808017/ATmega4809-CNANO-Documents/ATmega4809-Curiosity-Nano-Altium-Project/BOM_Template.xlsx

 | Component list |  | Field=ProjectTitle
 | PCBA Number: |  | Field=ProjectPCBAssyNumber
 | PCBA Revision: |  | Field=ProjectPCBAssyRevision
 | Variant: |  | Field=VariantName
 | Print Date: | Field=CurrentDate | Field=CurrentTime
Column=Fitted | Column=Designator | Column=Quantity | Column=Value | Column=Manufacturer | Column=MPN | Column=Description
 |  | Field=TotalQuantity
Approved |  |  | Notes
