808017/ATmega4809-CNANO-Documents/CNANO-Explorer-UserGuide-DS50003716.pdf

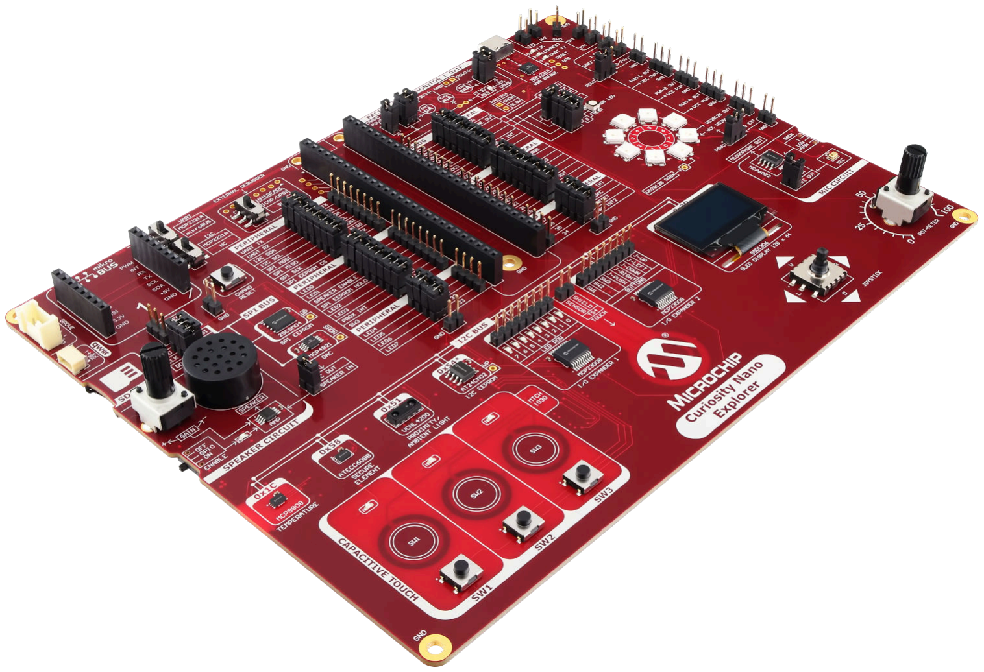
[picture p1: figure]

User Guide
© 2025 Microchip Technology Inc. and its subsidiaries

DS50003716B - 1

## Preface

- Website (https://www.microchip.com/en-us/development-tool/EV58G97A) - Purchase this product, kit information, latest user guide, and design documentation
- Explorer Pinouts for all Curiosity Nanos (https://ww1.microchip.com/downloads/aemDocuments/documents/MCU08/ProductDocuments/BoardDesignFiles/Curiosity-Nano-Explorer-Pinouts.pdf) - Explorer Pinouts for all Curiosity Nano boards
- Schematics (https://ww1.microchip.com/downloads/aemDocuments/documents/MCU08/ProductDocuments/BoardDesignFiles/Curiosity-Nano-Explorer-Schematics.pdf) - Board schematics
- Altium Project (https://ww1.microchip.com/downloads/aemDocuments/documents/MCU08/ProductDocuments/BoardDesignFiles/Curiosity-Nano-Explorer-Altium-Project.zip) - Altium design files for the latest board revision
- Design Documentation (https://ww1.microchip.com/downloads/aemDocuments/documents/MCU08/ProductDocuments/BoardDesignFiles/Curiosity-Nano-Explorer-Design-Documentation.zip) - Production files for all board revisions
- MPLAB® Discover (https://mplab-discover.microchip.com/v2?dsl=%22Curiosity+Nano+Explorer%22) - Code examples for Curiosity Nano Explorer

Important:
This version of the user guide documents Curiosity Nano Explorer Revision 4.
- Identify your product revision
- Curiosity Nano Explorer Online Errata (https://onlinedocs.microchip.com/g/GUID-2B07EF5D-DD0E-43DF-9A21-7FCEBF41749E) - Latest revision history and known issues for all board revisions

Product Page Links

## Curiosity Nano Explorer User Guide

## Curiosity Nano Explorer User Guide [EV58G97A]

Curiosity Nano Explorer User Guide [EV58G97A]

- Curiosity Nano Explorer Online User Guide (https://onlinedocs.microchip.com/g/GUID-4910ECB5-7AD0-4572-B070-CCA2E253F3CB) - Access the latest user guide online
- Curiosity Nano Explorer PDF User Guide (http://www.microchip.com/DS50003716) - Download the latest PDF version of the user guide

## Table of Contents

6.3. I

Introduction

## 1. Introduction

Kit Introduction, Kit Contents, Terminology, Image Legend.

## 1.1. Curiosity Nano Explorer

The Curiosity Nano Explorer lives up to its name by providing extensive on-board features that allow users to explore and experiment with the microcontroller peripherals of their Curiosity Nano development board. It also serves as a great platform to become familiar with Microchip's software offerings.
A wide selection of input and output options:
- INPUTS include Touch and mechanical buttons, a potentiometer, a joystick, a temperature sensor, a proximity sensor, an ambient light sensor, and a microphone
- OUTPUTS include LEDs (simple yellow, standard RGB, and WS2812B RGB), an OLED display, and a speaker
Solid support for serial communication:
- I²C Bus with eight clients
- SPI Bus with three clients
- UART connection
Microchip’s complementary technologies:
- Touch controller with three touch buttons and a separate touch button for use with microcontrollers featuring a touch peripheral
- ECC608 provides CryptoAuthentication™ features
- Power Monitoring by the PAC1944 enables the measurement of various power domains Finally, if anything is missing on the Explorer, its functionality can be expanded via the mikroBUS™, Grove or Qwiic® connector.

## 1.2. Kit Contents

The Curiosity Nano Explorer kit contains:
- One Curiosity Nano Explorer development board
- 20 separable 100-mil jumper wires for pin remapping
- Ten additional 100-mil pin jumpers
- One 1x8 (100-mil) right-angled pin header to connect external programmer/debuggers
- One joystick cap

## 1.3. Terminology

This user guide uses the following terminology:

Table 1-1. Terminology
Term | Explanation
Explorer | The Curiosity Nano Explorer development board
CNANO | The connected Curiosity Nano development board
CNANO Socket | A socket with two 1x28 100-mil pin header sockets to connect any Curiosity Nano development board to the Curiosity Nano Explorer

## 1.4. Image Legend

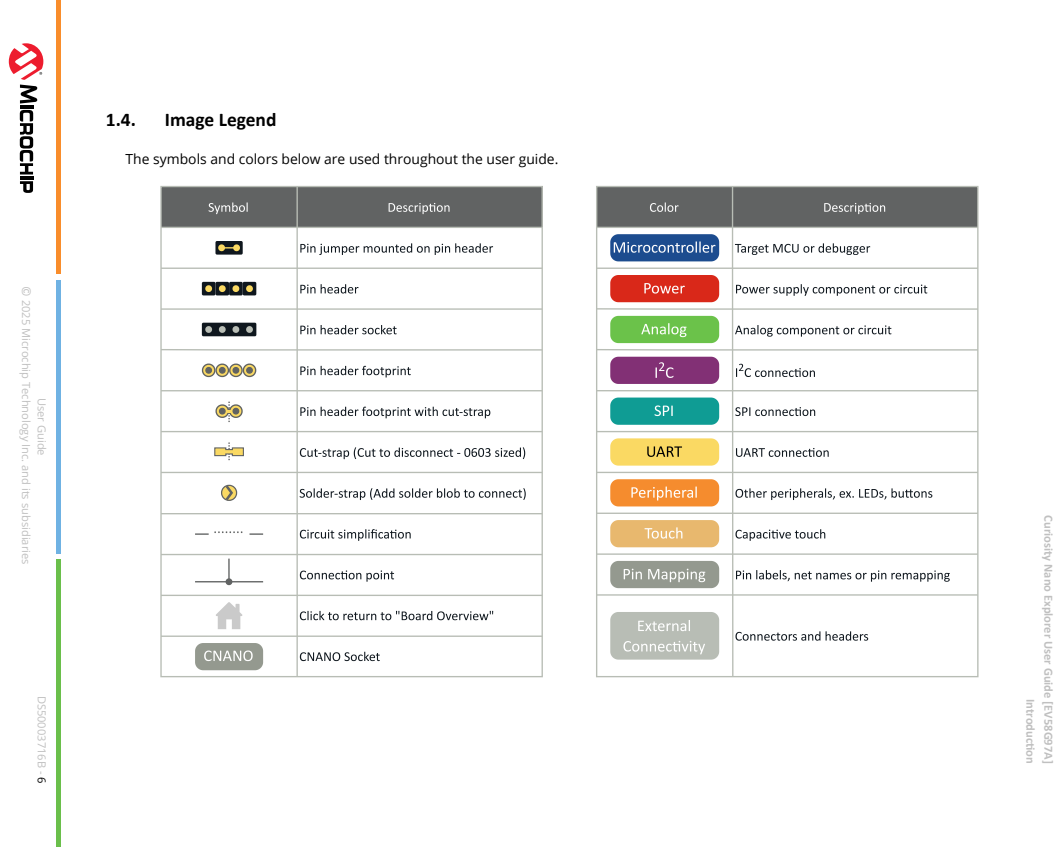
[picture p2: page 6]
Introduction; User Guide

rotatethispage90
The symbols and colors below are used throughout the user guide.

© 2025 Microchip Technology Inc. and its subsidiaries

Curiosity Nano Explorer User Guide [EV58G97A]

## 2. Board Overview

## 2.1. Block Diagram

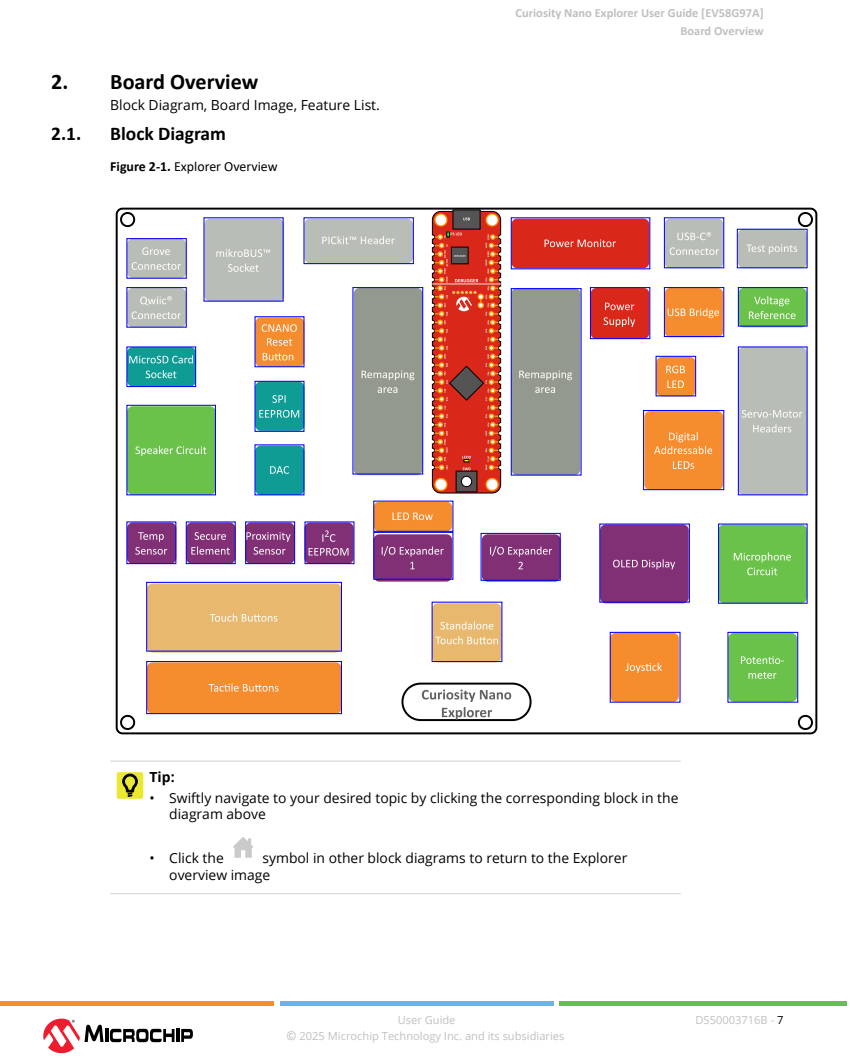
[picture p3: page 7]
Board Overview; • Click the; symbol in other block diagrams to return to the Explorer; overview image

Block Diagram, Board Image, Feature List.

Figure 2-1. Explorer Overview

Tip:
• Swiftly navigate to your desired topic by clicking the corresponding block in the
diagram above

## 2.2. Board Image

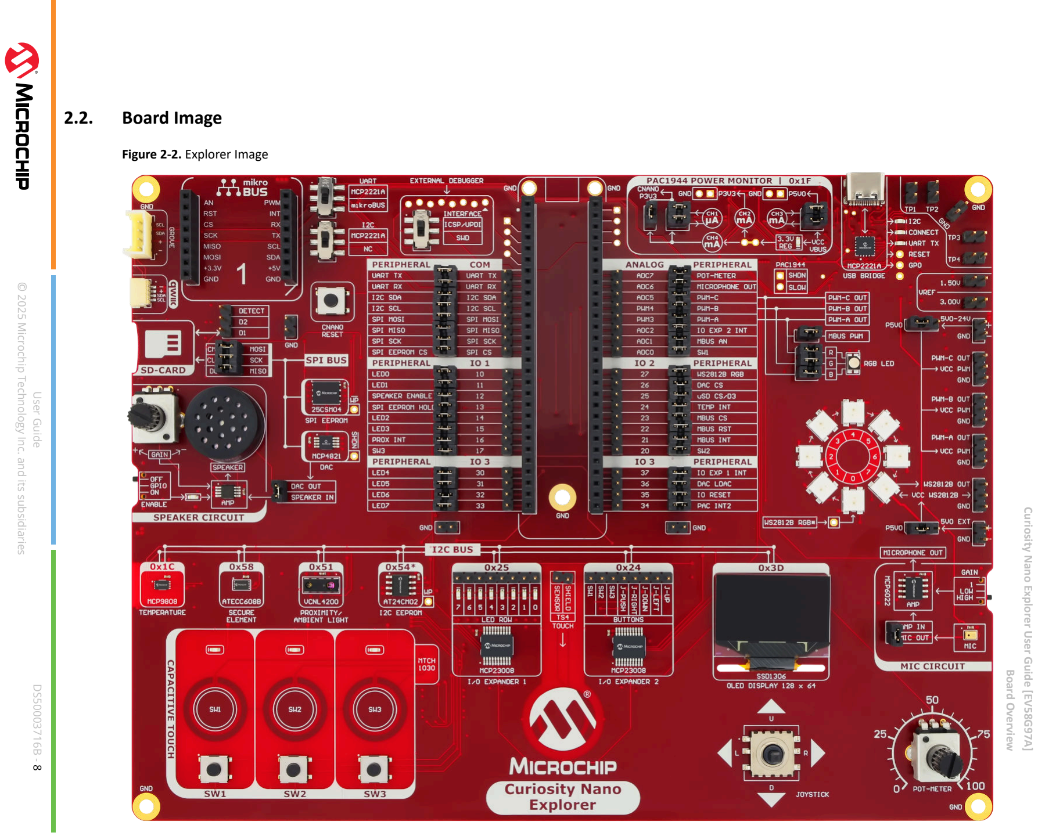
[picture p4: page 8]

Curiosity Nano Explorer User Guide [EV58G97A]

Board Overview

User Guide

© 2025 Microchip Technology Inc. and its subsidiaries

DS50003716B -

8

rotatethispage90
Figure 2-2. Explorer Imagerotatethispage90

Board Overview

## 2.3. Feature List

- Curiosity Nano socket
– Supports all Curiosity Nano development boards
– Fully remappable pinout
- On-board peripherals
– MCP2221A (https://www.microchip.com/en-us/product/MCP2221A) USB to UART/I²C-Bridge – PAC1944 (https://www.microchip.com/en-us/product/pac1944) power monitor
– ATECC608B (https://www.microchip.com/en-us/product/atecc608b) secure element
– MCP4821 (https://www.microchip.com/en-us/product/mcp4821) 12-bit digital-to-analog converter
– MTCH1030 (https://www.microchip.com/en-us/product/MTCH1030) touch controller
– Two serial EEPROMs (AT24CM02 (https://www.microchip.com/en-us/product/at24cm02) and 25CSM04) (https://www.microchip.com/en-us/product/25CSM04)
– Two MCP23008 (https://www.microchip.com/en-us/product/MCP23008) I²C I/O-expanders – MicroSD card socket
- Multiple input options
– MCP9808 (https://www.microchip.com/en-us/product/MCP9808) temperature sensor
– Microphone and amplifier (MCP6022) (https://www.microchip.com/en-us/product/mcp6022) with adjustable gain
– Joystick
– Potentiometer
– Push buttons
– Touch buttons
– Proximity/ambient light sensor
- Multiple output options
– LED row with eight yellow LEDs – OLED display
– One RGB LED
– Eight digital addressable LEDs
– Three external PWM outputs for servomotors
– Speaker and class-D amplifier with adjustable gain
- External connectivity options
– Grove I²C connector
– mikroBUS™ socket
– Qwiic® I²C connector
- Multiple power sources
– On-board USB Type-C® connector
– USB powered from connected CNANO – External power options for addressable LEDs and servomotors
- On-board Power Supplies
– MIC33153 (https://www.microchip.com/en-us/product/mic33153) 4 MHz PWM 1.2A internal inductor buck switcher power module to power 3.3V peripherals
– MCP1754 (https://www.microchip.com/en-us/product/MCP1754) 3.3V 150 mA LDO to power USB bridge and power monitor circuitry
– MIC2008 (https://www.microchip.com/en-us/product/MIC2008) high-side power switch for slew rate control and over-current protection
- MCP1501 (https://www.microchip.com/en-us/product/MCP1501) user-remappable voltage references, 1.5V and 3.0V
- Reset button for connected CNANO MCU

Pinout and Remapping

## 3. Pinout and Remapping

Pinout and Remapping Area, Different Types of Remapping.

Tip: The mapping between Explorer and any Curiosity Nano development board can be found in the Curiosity Nano Explorer Pinouts (https://ww1.microchip.com/downloads/aemDocuments/documents/MCU08/ProductDocuments/BoardDesignFiles/Curiosity-Nano-Explorer-Pinouts.pdf) document.

Figure 3-1. Pinout, Remapping Area and CNANO Socket

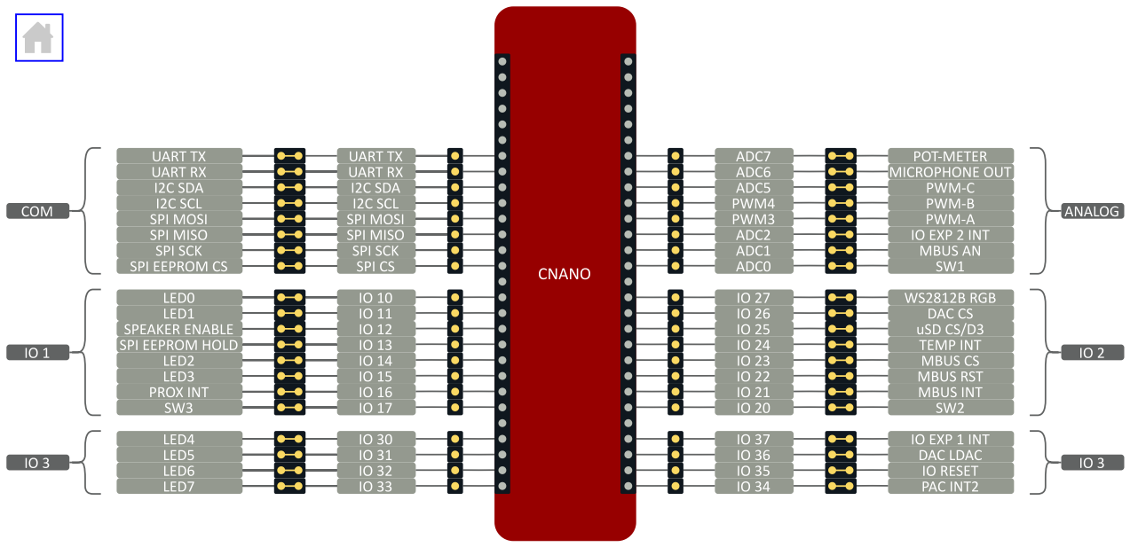
[picture p5: figure]

Connections to the CNANO socket are divided into five sections - COM, analog, IO1, IO2 and
IO3. Standard functionality is assigned to each pin in the COM and analog section Curiosity Nano development boards. Pins in the I/O sections are numbered with a <section><pin-number> format, ex: “IO 26” indicates section 2 pin 6.

Info: Curiosity Nano development boards with low pin count microcontrollers
may not implement the standard functionality in the COM and analog sections.

Pinout and Remapping
Figure 3-2. Explorer to CNANO Connections

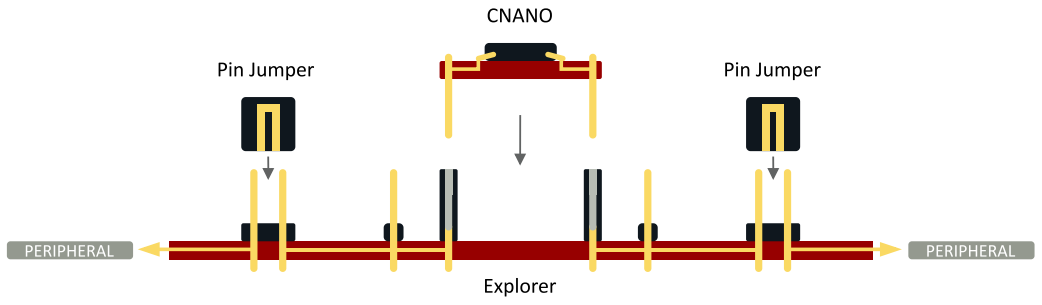
[picture p6: figure]

Tip: Connect your measuring tool to the innermost pin header for easy access to any signal on the Explorer. Use the custom test points for access with longer measurement probes.

## 3.1. CNANO Socket Remapping

The Explorer’s connections to the CNANO socket are fully remappable. Any peripheral can be connected to any pin on the socket.

Figure 3-3. Peripheral to CNANO Pin Remapping

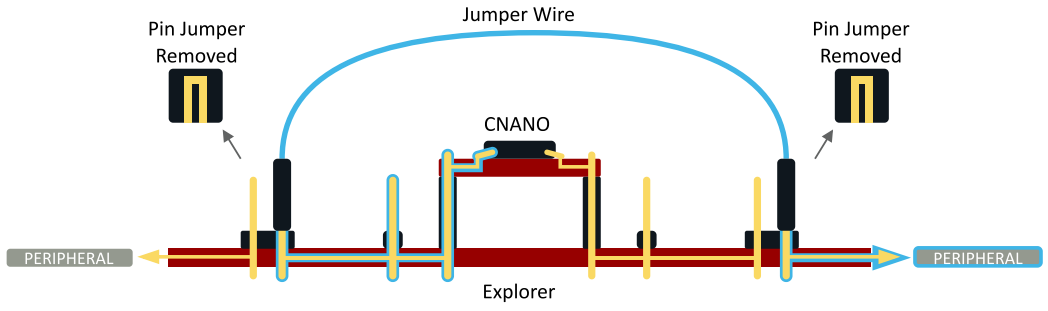
[picture p7: figure]

Tip: Peripheral connections are labeled on the silkscreen.

## 3.2. Direct Remapping

Many peripherals on the Explorer can be remapped by connecting a pin directly to the CNANO socket using a jumper wire. For example, if your CNANO's microcontroller has a DAC (Digital-to-Analog Converter) output, you can directly connect it to the speaker amplifier.

Pinout and Remapping
Figure 3-4. Direct peripheral remapping

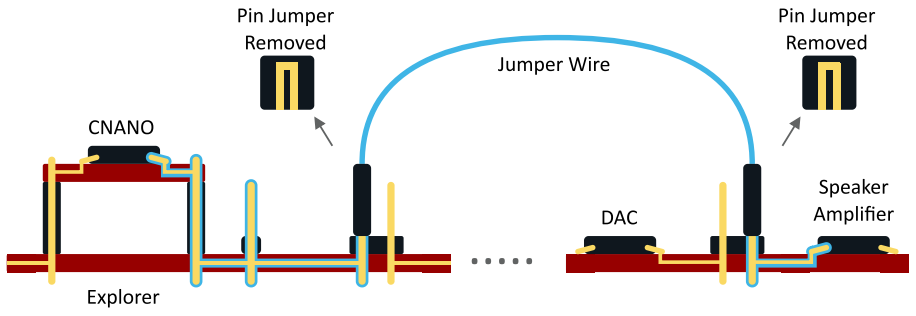
[picture p8: figure]

## 3.3. Custom Test Points

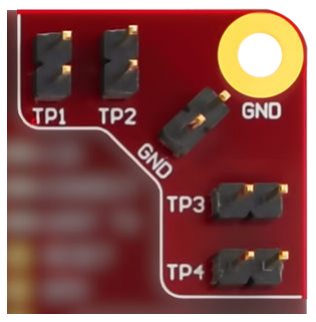
[picture p9: figure]

The Explorer features four customizable test points available on the board edge. The test points are labeled TP1, TP2, TP3 and TP4 on the silkscreen.
Easily measure any signal by connecting a jumper wire between the innermost pin header in the remapping area and a test point.

Figure 3-5. Connecting Net to Test Point

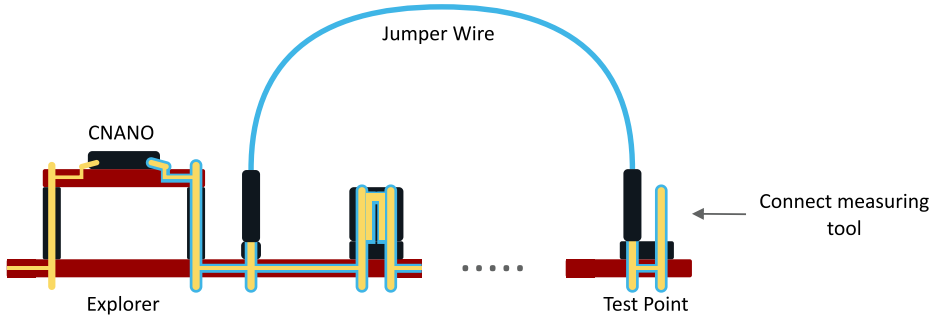
[picture p10: figure]

Tip: A pin header with ground connections is available next to the test points.

Power Supply and Monitor

## 4. Power Supply and Monitor

Power supply, Power Monitor.

## 4.1. Power Supply

Figure 4-1. Power Supply Overview

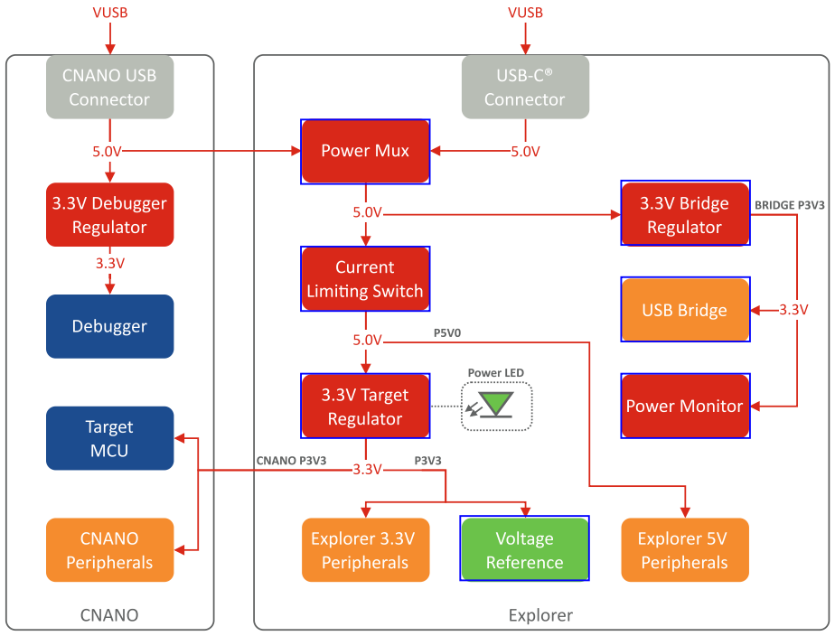
[picture p11: figure]

Important: The Explorer powers the CNANO at 3.3V, and all the pins connected to the CNANO socket are designed for use with 3.3V I/O pins.

The Explorer’s power supply features:
- Dedicated 3.3V regulator to power the CNANO and 3.3V peripherals
– The CNANO’s target regulator is disabled while connected to the Explorer
- 5V peripherals powered directly by USB voltage
- A power multiplexer allows power supplied from the on-board USB-C® connector or the CNANO
- A current limiting switch with a soft start to protect the board, the current limit set at 2A
- On-board power monitoring for voltage and current measurement with four channels

Power Supply and Monitor
Table 4-1. Power Domain Specifications
Power Domain | Vnom | Vmin - Vmax | Imax
P5V0 | 5.0V | 4.4–5.5V | 2.0A
P3V3 | 3.30V | 3.22–3.38V | 1.2A
CNANO P3V3 | 3.30V | 3.22–3.38V | 1.2A
BRIDGE P3V3 | 3.30V | 3.23–3.37V | 150 mA

### 4.1.1. Power Sources

The two main power sources are:
- The USB connector on the CNANO
- The USB-C® connector on the Explorer

Current limitations:
- The CNANO’s VBUS output has a current limitation of 500 mA
- The Explorer’s USB-C® connector can sink different amounts of current based on the USB source (up to 3.0A from a USB-C® source)
- Both USB inputs are fed into a power multiplexer, with output current limited to 2.0A

Info: If both USB connectors are powered, the current is sourced through the Explorer's USB-C® connector.

Figure 4-2. Power MUX Overview

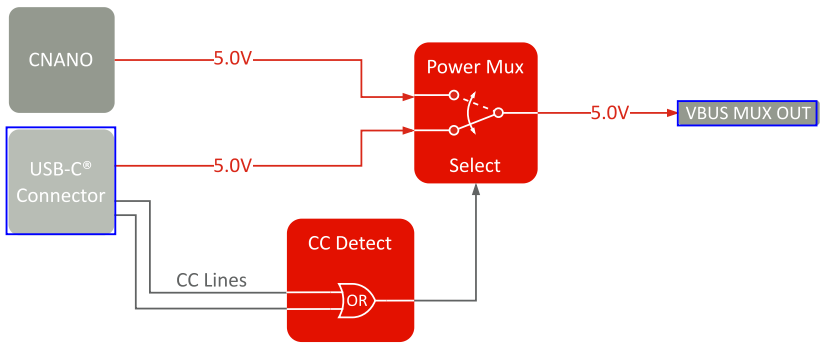
[picture p12: figure]

### 4.1.2. Power Domains

There are four main power domains on the Explorer:
- P5V0
- P3V3
- CNANO P3V3
- BRIDGE P3V3

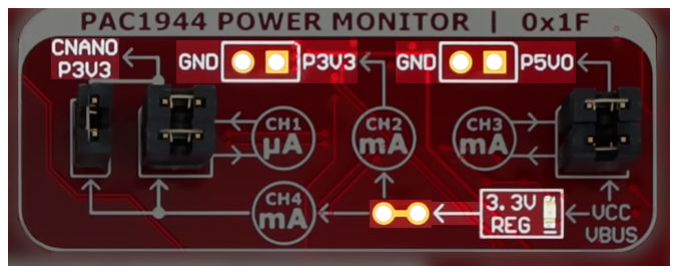
[picture p13: figure]

Power Supply and Monitor
CNANO P3V3 is powered by the same regulator as P3V3, separated for dedicated power measurement of the CNANO. It powers the CNANO’s external power input. Refer to CNANO Power Configuration for more information.

Table 4-2. Peripherals Connected to the Different Power Domains
Power Domain | Power Measurement Channel | Peripheral
CNANO P3V3 | CH1 (uA), CH4 (mA) | Connected CNANO
P3V3 | CH2 (mA) | Touch controller I/O expander 2 + button LEDs I/O expander 1 + LED row I 2C EEPROM Secure Element Proximity and ambient light sensor (digital circuitry) Temperature sensor OLED display SPI EEPROM DAC Voltage reference Microphone circuit Speaker circuit Potentiometer mikroBUS™ socket (3.3V pin)
| | MicroSD card socket Grove and Qwiic®connector
P5V0 | CH3 (mA) | RGB LED Digital addressable LEDs Servomotor circuit Proximity and ambient light sensor (internal LED) mikroBUS™ socket (5V pin)
BRIDGE P3V3 | - | Power monitor circuit USB bridge circuit

Figure 4-3. Power Domains Overview

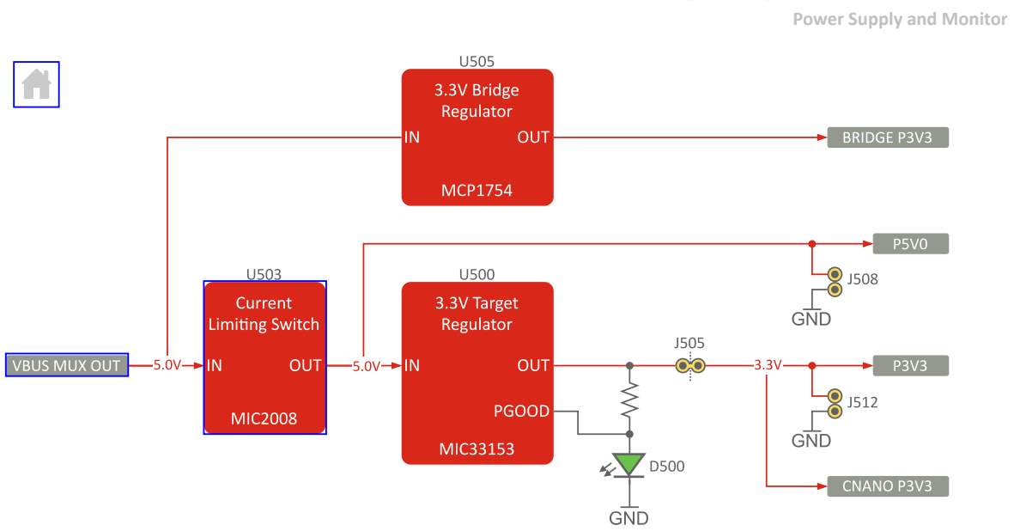
[picture p14: figure]
Power Supply and Monitor

### 4.1.3. Current Limiting Switch

A MIC2008 (https://www.microchip.com/en-us/product/MIC2008) current limiting switch with an adjustable slew rate is mounted on the board to prevent large inrush currents. The switch has been configured with a current limit of 2.0A by selecting resistor R500 to be 120Ω.

Info: MIC2008 current limit range: 0.2–2.0A. See the MIC2008 data sheet (https://www.microchip.com/en-us/product/MIC2008#document-table) for more information

Figure 4-4. Current Limiting Switch

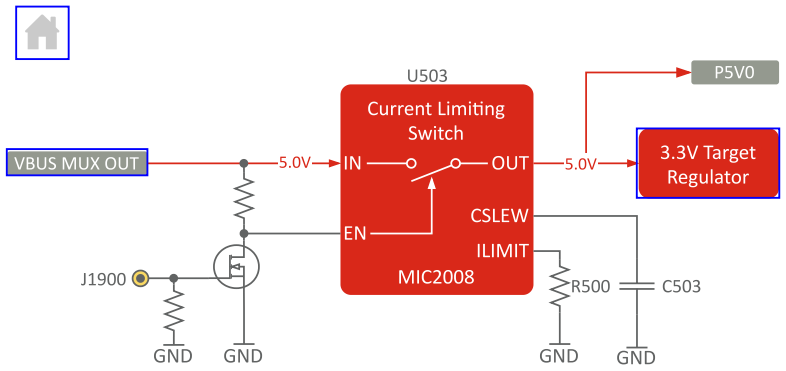
[picture p15: figure]

### 4.1.4. CNANO Power Configuration

The Explorer supplies the CNANO with a fixed 3.3V. When connected to the Explorer, the on-board regulator of the CNANO is disabled by pulling the VOFF pin low, ensuring no logic level mismatches between the CNANO and the Explorer.

Info: The CNANO's on-board debugger is only powered when the CNANO USB is connected to power.

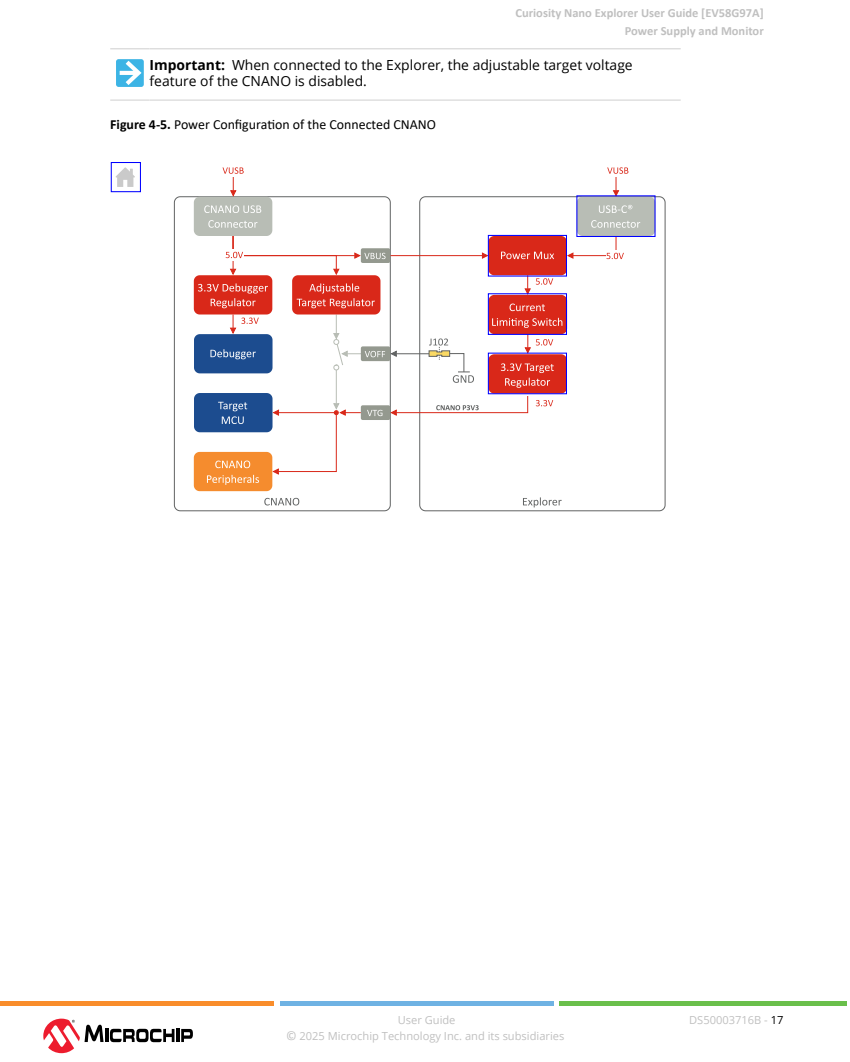
[picture p16: page 17]

Power Supply and Monitor

Important: When connected to the Explorer, the adjustable target voltage
feature of the CNANO is disabled.

Figure 4-5. Power Configuration of the Connected CNANO

Power Supply and Monitor

## 4.2. Power Monitor

### 4.2.1. Getting Started with Power Monitor

The on-board PAC1944 (https://www.microchip.com/en-us/product/pac1944) quad-channel power monitor circuit allows tracking of the power consumption of peripherals on the Explorer. The measurement data can be accessed through the USB bridge MCP2221A.
To read and visualize power data, download and install the PAC194x/PAC195x Demo Application. (https://www.microchip.com/en-us/development-tool/EV40S84A#Software)

Figure 4-6. PAC194x/PAC195x Demo Application

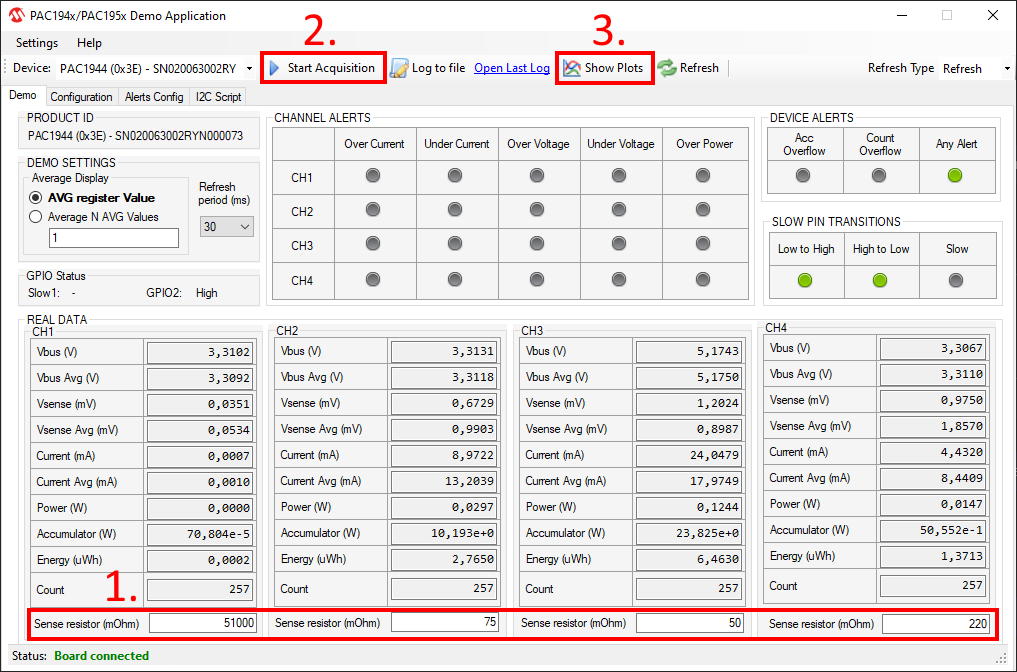
[picture p17: figure]

Open the application and perform the following steps to get started:
1. Configure the sense resistor value:
a. Channel 1: 51000
b. Channel 2: 75
c. Channel 3: 50
d. Channel 4: 220
2. Start Acquisition.
3. Press "Show Plots" to visualize the data.

Important: While using the demo application set the I

2C slide switch to the
"NC" position, which isolates the PAC1944 and MCP2221A from the rest of the Explorer’s I²C bus.

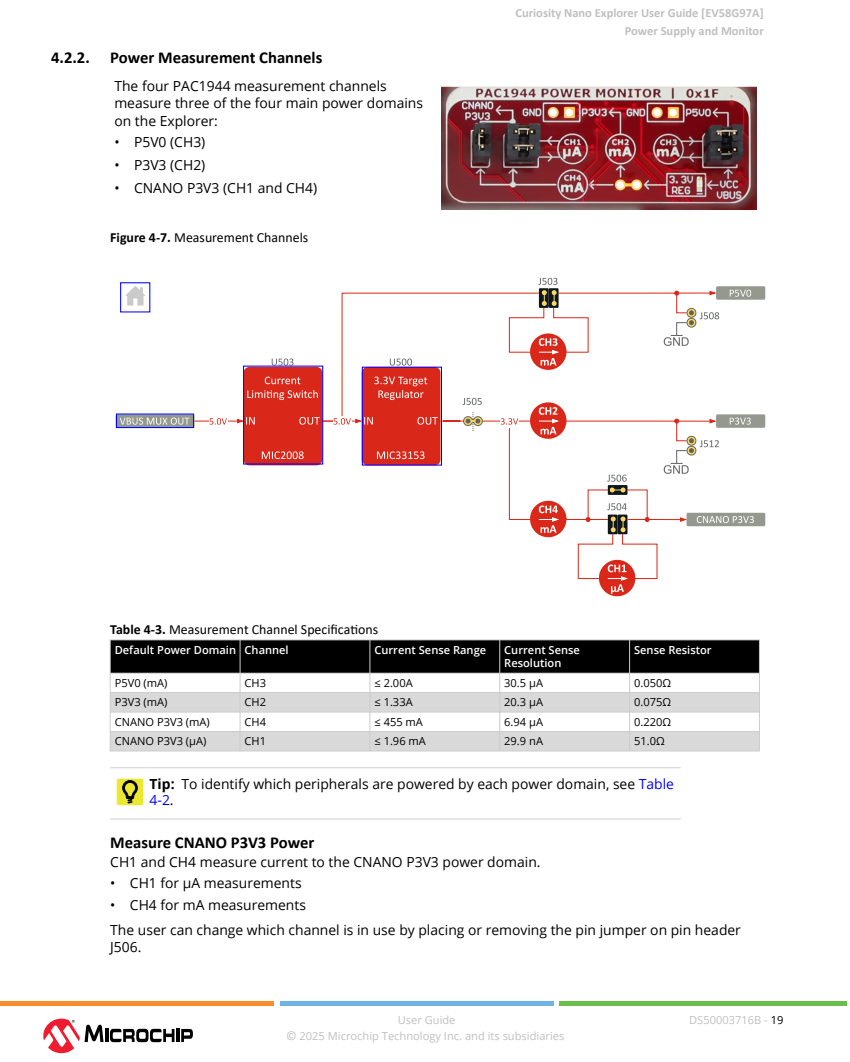
[picture p18: page 19]

Power Supply and Monitor

4.2.2. Power Measurement Channels

The four PAC1944 measurement channels
measure three of the four main power domains
on the Explorer:
• CNANO P3V3 (CH1 and CH4)

Figure 4-7. Measurement Channels

Table 4-3. Measurement Channel Specifications

Default Power Domain | Channel | Current Sense Range | Current Sense Resolution | Sense Resistor

P5V0 (mA) | CH3 | ≤ 2.00A | 30.5 μA | 0.050Ω
P3V3 (mA) | CH2 | ≤ 1.33A | 20.3 μA | 0.075Ω
CNANO P3V3 (mA) | CH4 | ≤ 455 mA | 6.94 μA | 0.220Ω
CNANO P3V3 (μA) | CH1 | ≤ 1.96 mA | 29.9 nA | 51.0Ω

Tip: To identify which peripherals are powered by each power domain, see Table

Measure CNANO P3V3 Power
CH1 and CH4 measure current to the CNANO P3V3 power domain.
• CH1 for µA measurements
• CH4 for mA measurements
The user can change which channel is in use by placing or removing the pin jumper on pin header

Power Supply and Monitor
Important: The sense resistor for CH1 is 51Ω. Currents above 2 mA will cause a significant voltage drop in the voltage supplied to the attached CNANO.
Figure 4-8. Currents Above 2 mA (CH1 bypassed) | Figure 4-9. Currents Below 2 mA (CH1 connected)

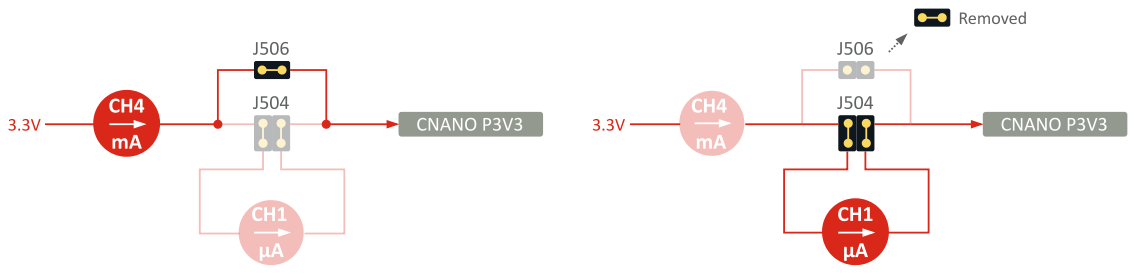
[picture p19: figure]

Measure External Power
CH1 and CH3 can be disconnected from their default connections to measure current from external sources.

Remember to connect the GND from the Explorer to the GND of the external source. Do not apply voltages above 9V to the current measurement channels.

Figure 4-10. Connect External Source to CH1 (µA) | Figure 4-11. Connect External Source to CH3 (mA)

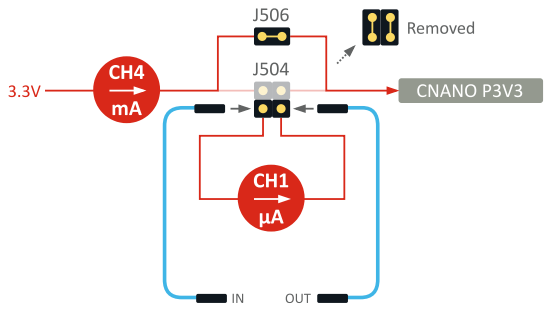
[picture p20: figure]
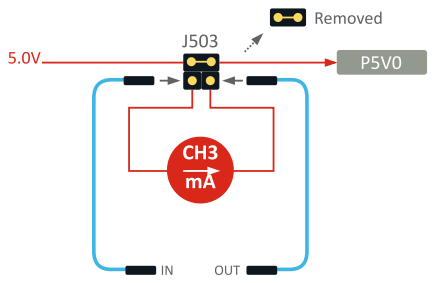
[picture p21: figure]
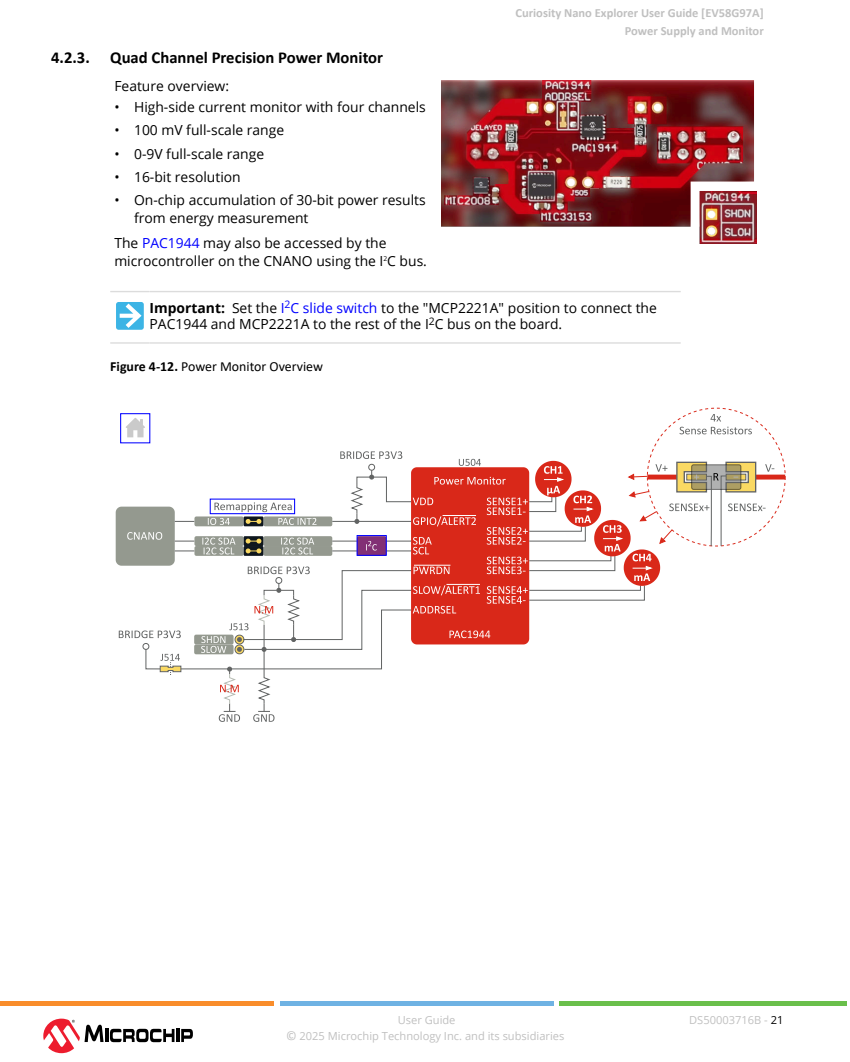
[picture p22: page 21]

Power Supply and Monitor

4.2.3. Quad Channel Precision Power Monitor

Feature overview:
• High-side current monitor with four channels
• 100 mV full-scale range
• 0-9V full-scale range
• 16-bit resolution
• On-chip accumulation of 30-bit power results
from energy measurement
The PAC1944 (https://www.microchip.com/en-us/product/pac1944) may also be accessed by the
microcontroller on the CNANO using the I²C bus.

Important: Set the I
PAC1944 and MCP2221A to the rest of the I²C bus on the board.

2C slide switch to the "MCP2221A" position to connect the

Figure 4-12. Power Monitor Overview

## 5. Buttons and LEDs

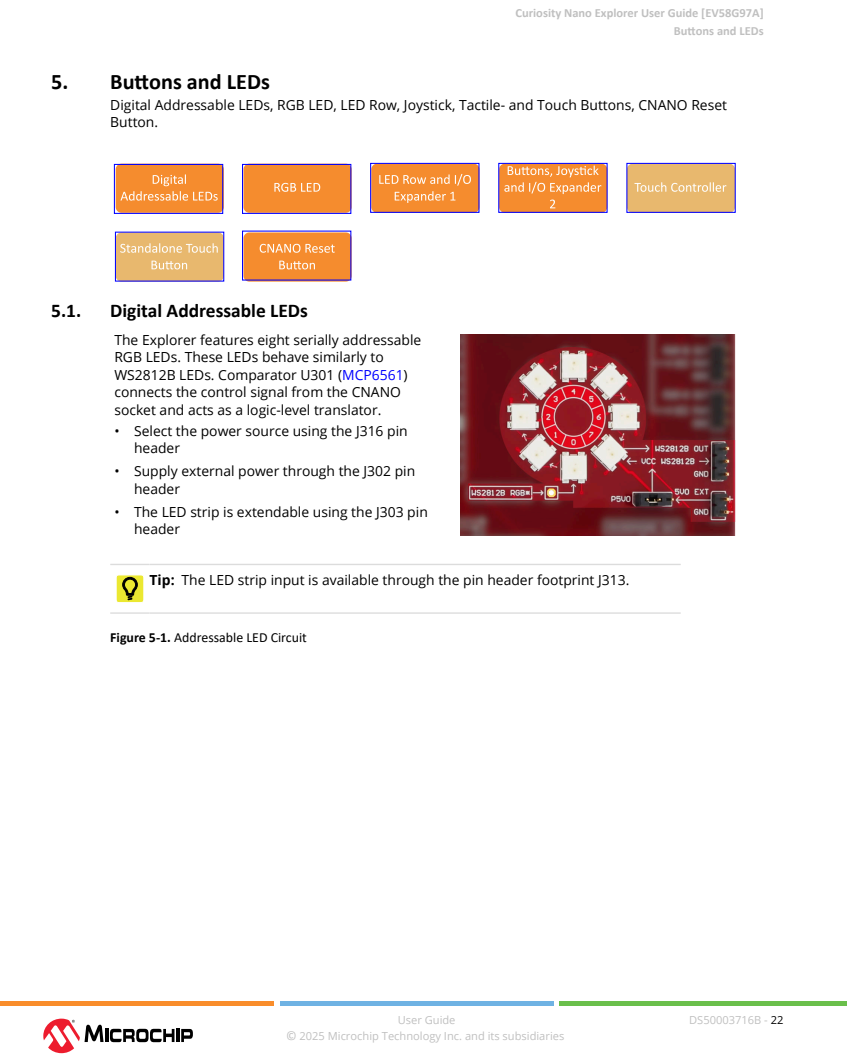
[picture p23: page 22]

Buttons and LEDs

Digital Addressable LEDs, RGB LED, LED Row, Joystick, Tactile- and Touch Buttons, CNANO Reset
Button.

5.1. Digital Addressable LEDs

The Explorer features eight serially addressable
RGB LEDs. These LEDs behave similarly to
WS2812B LEDs. Comparator U301 (MCP6561) (https://www.microchip.com/en-us/product/mcp6561)
connects the control signal from the CNANO
socket and acts as a logic-level translator.
• Select the power source using the J316 pin
header
• Supply external power through the J302 pin
• The LED strip is extendable using the J303 pin

Tip: The LED strip input is available through the pin header footprint J313.

Figure 5-1. Addressable LED Circuit

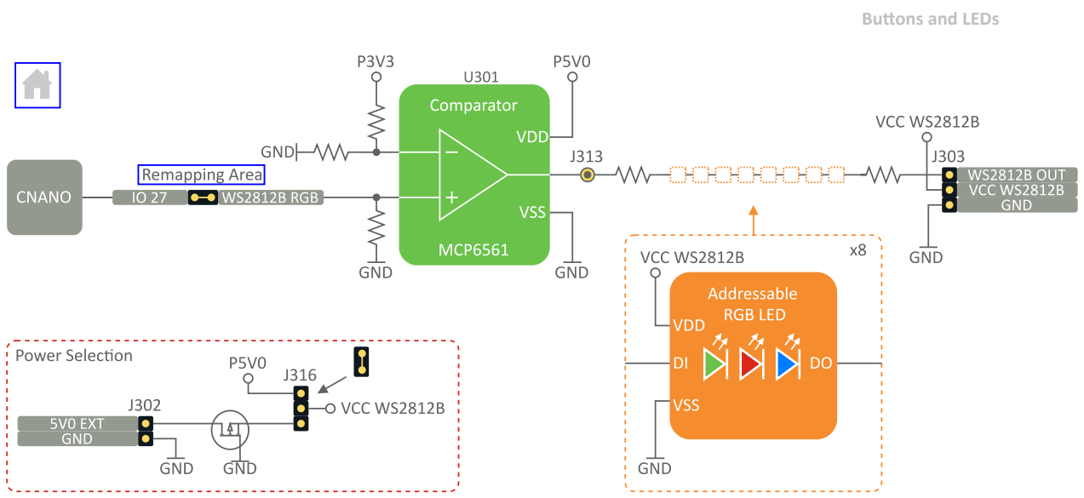
[picture p24: figure]
Buttons and LEDs

Important: Long LED strips consume a lot of current, and it is recommended to use an external supply to power LED strips attached to the board.

Tip: Check out the PIC® and AVR® examples for driving WS2812 or similar LEDs on MPLAB® Discover. (https://mplab-discover.microchip.com/v2?dsl=WS2812)

Related information: Addressable LEDs Timing and Format.

## 5.2. RGB LED

An RGB LED is connected to the PWM outputs
from the CNANO socket.

The LED is very bright when driven at full power – do not stare at it.

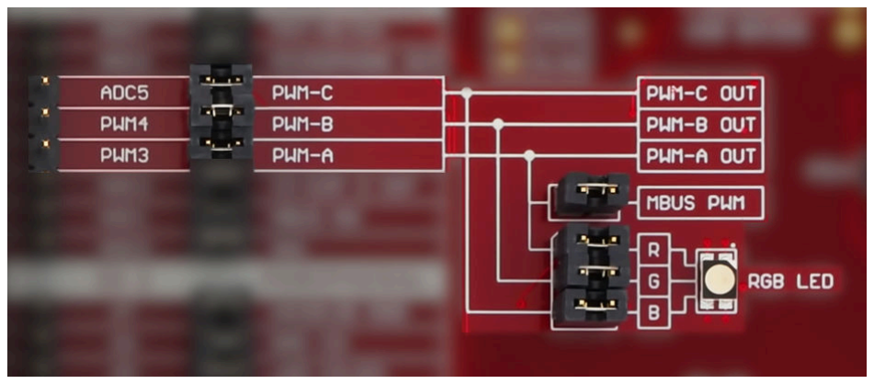
[picture p25: figure]

The PWM outputs from the CNANO socket are shared between the servomotor driver and the mikroBUS™ socket. Disconnect the different channels by removing the jumper caps from J203 and J309.
- Pin header J309 connects the RGB LED to the CNANO socket
- Pin header J203 connects the mikroBUS™ PWM channel to the CNANO socket

Figure 5-2. RGB LED Overview

Buttons and LEDs

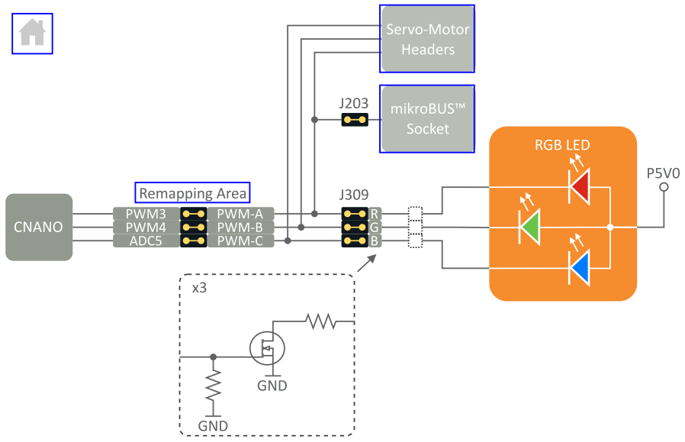
[picture p26: figure]

Tip: Check out the PIC and AVR examples for driving RGB LEDs on MPLAB® Discover. (https://mplab-discover.microchip.com/v2?dsl=pwm+AND+rgb+AND+led)

## 5.3. LED Row and I/O Expander 1

LED Row
The Explorer features eight controllable yellow LEDs. Turn the LED on by pulling the pin low (active-low).
The eight LEDs can be controlled in three different ways:
1. From the Remapping Area.
2. From I/O Expander 1 via the I²C Bus.
3. From the 1x8 pin header (J301).

I/O Expander 1

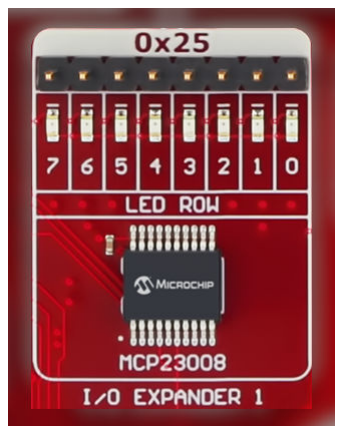
[picture p27: figure]

Set the GP pin to output-low mode on the I/O Expander to activate (turn on) the LED.

Info: Each LED is connected to a resistor network, ensuring that no short circuits occur if controlled from multiple sides simultaneously.

Figure 5-3. LED Row Connections

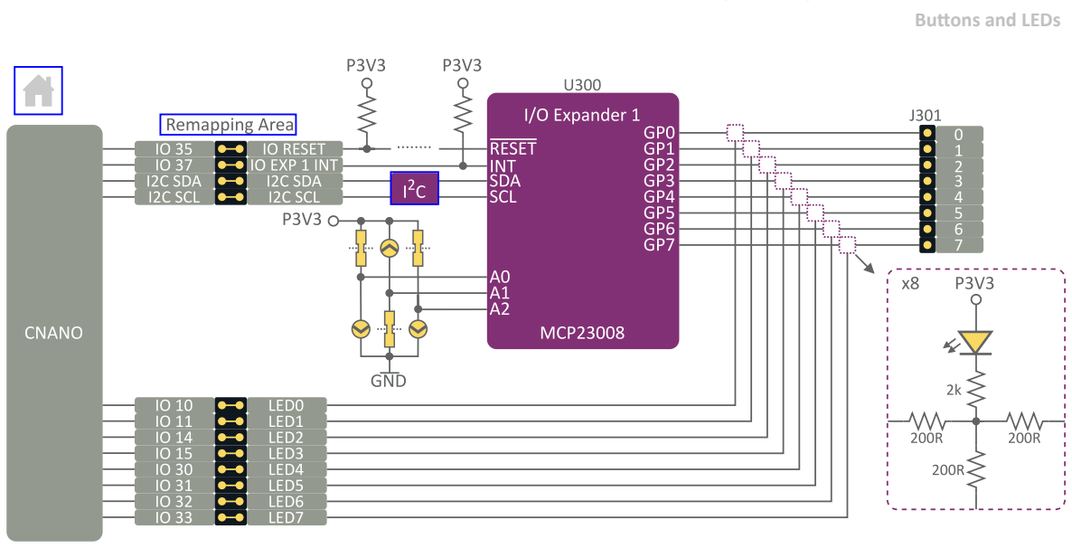
[picture p28: figure]
Buttons and LEDs

Info: I/O Expander 1’s 7-bit I²C address: 0x25. The I²C address can be changed using pins A0-A2 and follows the address format ‘0100, A2, A1, A0’.

## 5.4. Buttons, Joystick and I/O Expander 2

Tactile and Touch Buttons
Three tactile and three touch buttons are available as user inputs on the Explorer. The buttons are connected in a group of one LED, one tactile, and one touch button. The grouping is shown on the silkscreen. Pressing any button in the same group will assert the same signal and activate the LED.
The button signals can be accessed in three different ways:
1. From the Remapping Area.
2. From I/O Expander 2 via the I²C Bus.
3. From the 1x8 pin header (J401).

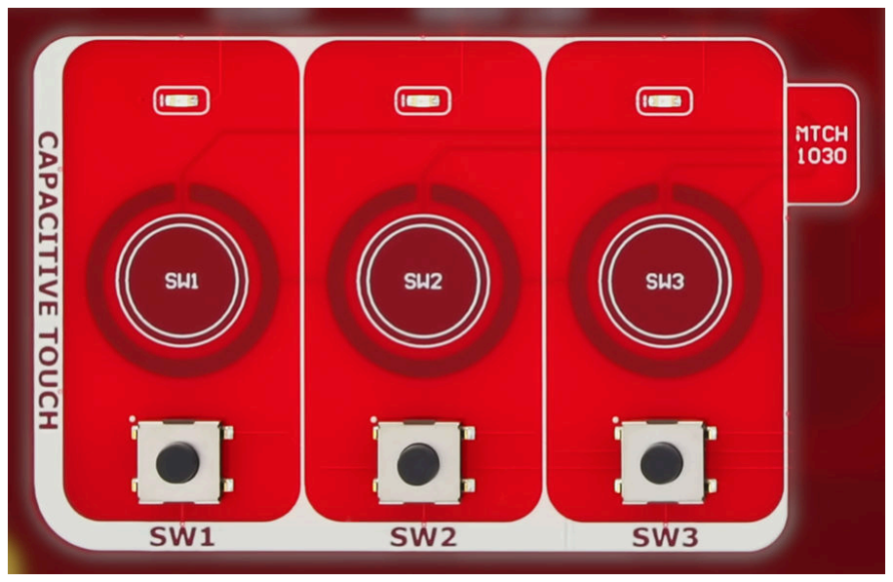
[picture p29: figure]

Tip: See section Touch Controller for more information on the touch buttons.

Buttons and LEDs
Joystick
The joystick signals can be accessed in two different ways:
1. From I/O Expander 2 via the I²C Bus.
2. From the 1x8 pin header (J401).

I/O Expander 2
Configure the GP pins as inputs with internal pull-ups to read the button states with the I/O Expander.

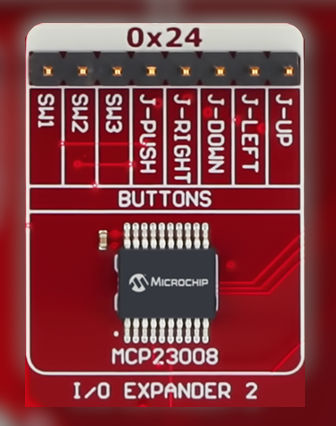
[picture p30: figure]

Info: Each button signal is connected to a resistor network, ensuring there are no short circuit occurs
if a pin is set high while the button is pressed.

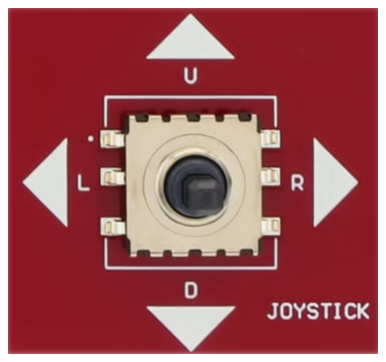
[picture p31: figure]

Buttons and LEDs
Figure 5-4. Buttons and Joystick Connections

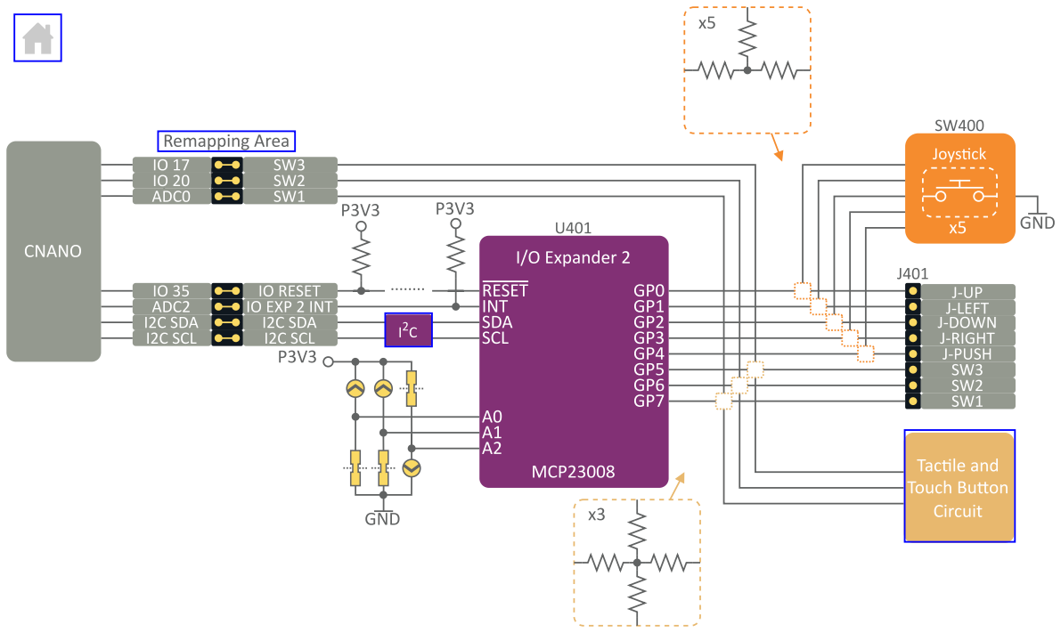
[picture p32: figure]

Info: I/O Expander 2’s 7-bit I²C address: 0x24. The I²C address can be changed using pins A0-A2 and follows the address format ‘0100, A2, A1, A0’.

## 5.5. Touch Controller

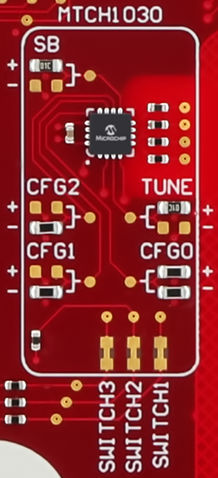
[picture p33: figure]

The three touch buttons are connected to the MTCH1030 (https://www.microchip.com/en-us/product/MTCH1030) touch controller. The touch buttons are sensed using capacitive touch sensors with active shields utilizing the Driven Shield Plus feature. Response time, oversampling, touch sensistivity, easy tune, and single-button mode are configured through resistors networks on the bottom side of the Explorer. The parameters are read by the touch controller during power-up and only the single-button mode can be altered at run-time.

Info: OUTx pin indicates the touch detection state
of BUTTONx. The pin idles in a high-impedance
state. When the touch button is pressed, it switches to output-low.

Buttons and LEDs
Figure 5-5. MTCH1030 Connections

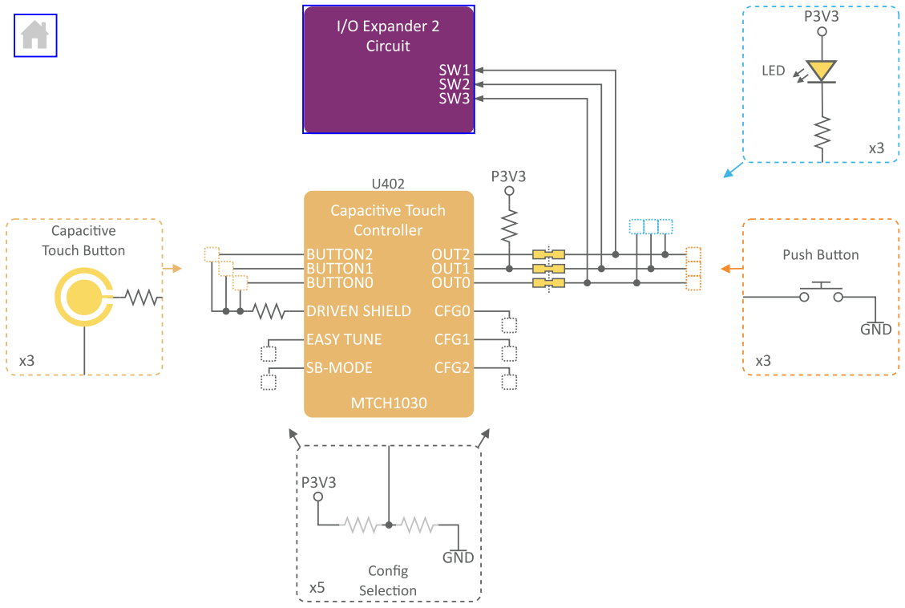
[picture p34: figure]

Info: By default, the Touch Tune Data feature of MTCH1030 is disabled due to the pull-up resistor on pin OUT1. To use this feature, refer to the chapter MTCH1030 Touch Tune Data in the appendix.

Info: The MTCH1030 enables anti-touch recalibration if a touch button pressed for more than 8s. This causes the OUTx pin to revert to a high-impedance state.

The MTCH1030 touch controller on the Explorer is configured as follows:
- Measurement Period: Back-to-back measurements (minimum period)
- Oversampling: Eight samples per measurement cycle
- Sensitivity: 0-63
- Easy Tune: Disabled
- Single-Button Mode: Disabled

Tip: Touch sensor data captured with MTCH1030 can be visualized using the MPLAB® Data Visualizer, (https://www.microchip.com/en-us/tools-resources/debug/mplab-data-visualizer) see section MTCH1030 Touch Tune Data.

Buttons and LEDs

## 5.6. Standalone Touch Button

Underneath the Microchip logo is a single standalone capacitive touch button with an optional active shield.
If the microcontroller on the CNANO supports capacitive touch sensing, the standalone capacitive touch button can be used by connecting it to the remapping area from the 1x2 pin header J404. See section Direct Remapping.
The sensor and shield pins are labeled in the silkscreen next to the pin header.

Figure 5-6. Standalone Touch Button

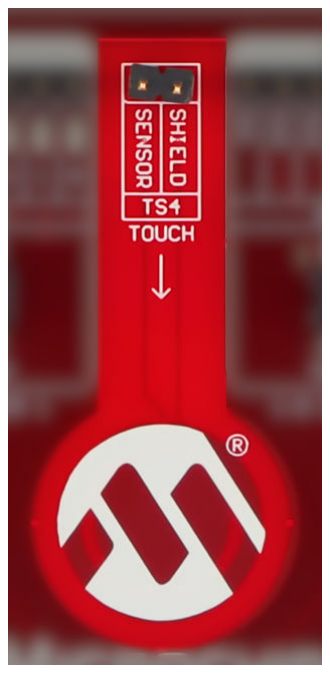
[picture p35: figure]

Tip: Generate code with the capacitive touch library in MCC Melody (https://onlinedocs.microchip.com/v2/keyword-lookup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) and visualize touch sensor data in MPLAB® Data Visualizer. (https://onlinedocs.microchip.com/v2/keyword-lookup?keyword=visualize-touch-dv&version=latest&redirect=true)

## 5.7. CNANO Reset Button

The Explorer features a reset button connected to the default reset pin location of the CNANO. The CNANO microcontroller (MCU) must have the reset functionality enabled for this button to work. Refer to your MCU’s data sheet to determine the pin location and function, and consult the CNANO schematics to see how it is connected.

Important: The reset button will reset only the CNANO MCU. Pressing the button
will not reset the peripherals on the Explorer.

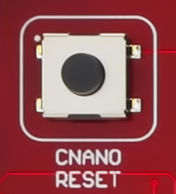
[picture p36: figure]

Figure 5-7. CNANO Reset Button

Serial Communication

## 6. Serial Communication

USB Bridge, UART, I²C and SPI Peripherals.

## 6.1. USB Bridge

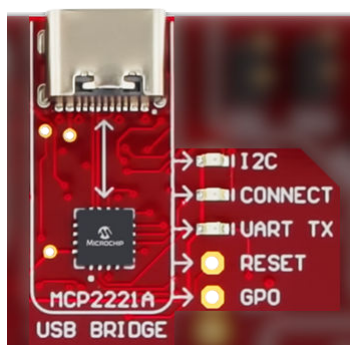
[picture p37: figure]

The MCP2221A (https://www.microchip.com/en-us/product/MCP2221A) is a USB-to-UART/I²C serial converter. It bridges the gap between a computer's USB port and the I²C and UART interfaces on the Explorer.
When the on-board USB-C® is disconnected, the USB bridge is held in reset. You can keep the USB bridge in reset using the MCU on the CNANO by pulling IO-37 on the Explorer low.

Tip: When not in use, it is recommended to
disconnect the bridge reset from the CNANO
socket by removing the jumper cap on IO-37.

Figure 6-1. USB Bridge Overview

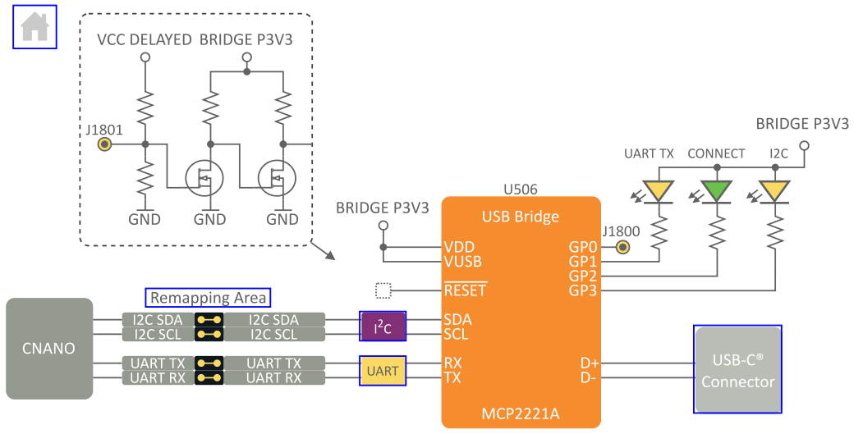
[picture p38: figure]

Tip: Drivers, CLI tools and apps are available to interface with the MCP2221A (https://www.microchip.com/en-us/product/MCP2221A#Software) on
its web page.

The USB bridge can be disconnected from the main I²C bus on the Explorer using slide switch S500. When disconnected, the USB bridge and the power monitor IC are isolated on their own I²C bus.

Serial Communication
Important: The USB bridge is only able to act as an I²C host.

The UART connection to the CNANO socket is shared between the USB bridge and the mikroBUS™ socket. Use slide switch S501 to select the connected UART.

## 6.2. UART Peripherals

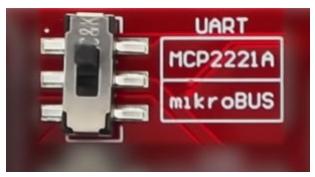
[picture p39: figure]

The CNANO’s default UART pins are shared between the USB
bridge and the mikroBUS™ socket. Only one of the connections is active at any time. Select which pins are connected to the CNANO socket using slide switch S501.

Figure 6-2. UART Overview

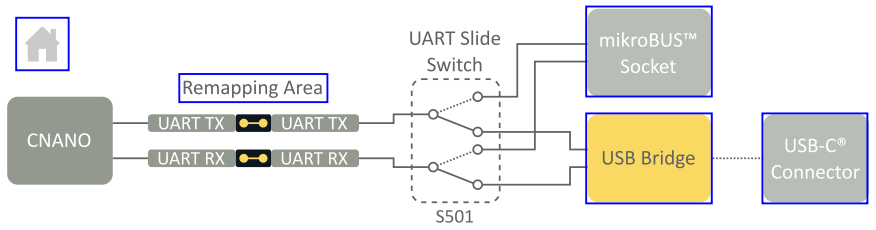
[picture p40: figure]

## 6.3. I

## 2C Peripherals

### 6.3.1. I

2C Bus

Figure 6-3. I

2C Bus Overview

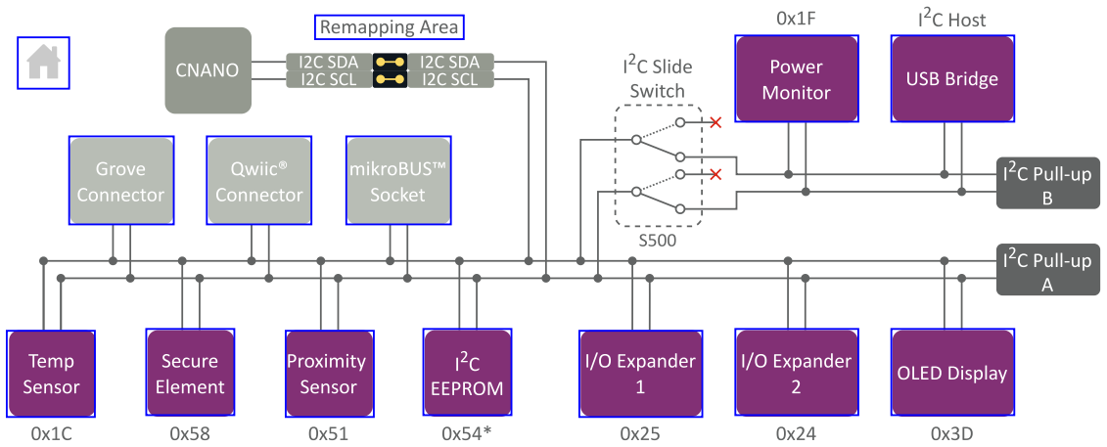
[picture p41: figure]

The Explorer features an I²C bus with several attached devices and external connectivity options. All connected devices are compatible with Standard Mode (100 kHz) and Fast Mode (400 kHz) I²C. The

Serial Communication
bus is designed to meet the rise-time requirements for both modes. The SDA and SCL signals are connected to the COM section of the CNANO socket.

Important: Connecting I²C extension boards with pull-ups will impact bus
performance.

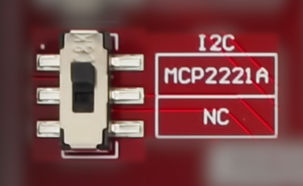
[picture p42: figure]

The Explorer’s I²C bus can be split into two separate buses using
the slide switch S500. Each bus has its own set of pull-ups - I²C
pull-ups A and B.
When the I²C bus is split, the USB bridge and the power monitor ICs are isolated from the main I²C bus, with the USB bridge acting as the host to communicate with the power monitor IC.

Important: The USB bridge can function only as an I²C host.

Table 6-1. I

2C Electrical Characteristics
Parameter | Value
I 2C Pull-up A | 2.7 kΩ
I 2C Pull-up B | 5.1 kΩ
I

2C bus with Pull-ups A and B
I 2C bus capacitance¹ | 130 pF
Rise-time² | ~200 ns
I

2C bus with Pull-up A isolated
I 2C bus capacitance¹ | 95 pF
Rise-time² | ~220 ns
I

2C bus with Pull-up B isolated
I 2C bus capacitance¹ | 35 pF
Rise-time² | ~150 ns
Note:
1Bus capacitance calculated using measured rise time with equation 1 from the I²C-bus specification and user manual. 2Rise time is defined as the time it takes for the I²C bus to rise from 0.3*VDD to 0.7*VDD.

Serial Communication

### 6.3.2. Temperature Sensor

MCP9808 (https://www.microchip.com/en-us/product/MCP9808) is a digital temperature sensor connected to the Explorer’s I²C bus. The alert pin is connected to the CNANO socket IO-24.
- Accuracy:
– ±0.25°C (typical) from -40°C to +125°C
– ±0.5°C (maximum) from -20°C to +100°C
- User selectable measurement resolution:
– 0.0625°C
– 0.125°C
– 0.25°C
– 0.5°C
- User programmable temperature limits: – Temperature window limit
– Critical temperature limit

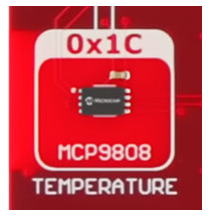
[picture p43: figure]

Info: 7-bit I²C address: 0x1C. The I²C address can be changed using pins A0-A2 and follows the address format ‘0011, A2, A1, A0’.

Figure 6-4. Temperature Sensor

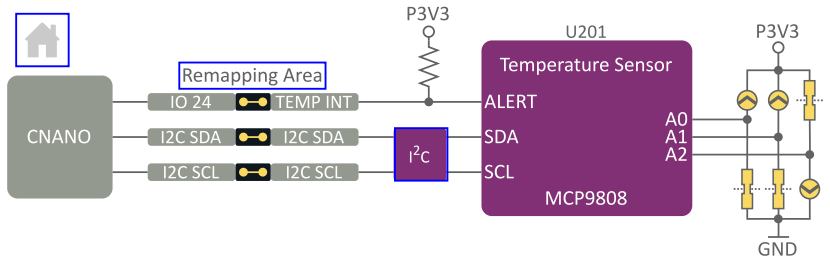
[picture p44: figure]

### 6.3.3. Secure Element

ATECC608B (https://www.microchip.com/en-us/product/ATECC608B) is a secure element in the Microchip CryptoAuthentication™ family and is connected to the Explorer’s I

2C bus.
- Supports advanced Elliptic Curve Cryptography (ECC)
- Protected storage for up to 16 keys, certificates or data
- Internal random number generator
- Secure boot support

Info: 7-bit I²C address: 0x58.

Serial Communication
Figure 6-5. Secure Element

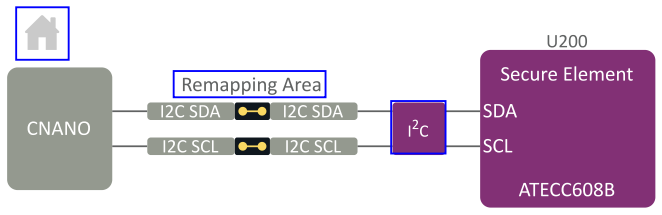
[picture p45: figure]

Info: The ATECC608B-MAH4I used on the Explorer is pre-provisioned for the Microchip Trust Platform and configured to support some of the most common IoT use cases. For more details, visit: https://www.microchip.com/en-us/products/security/trust-platform/trustflex. (https://www.microchip.com/en-us/products/security/trust-platform/trustflex)

### 6.3.4. Proximity and Ambient Light Sensor

VCNL4200 is a proximity sensor (PS) and ambient light sensor (ALS) connected to the Explorer’s I²C bus.
- Programmable emitter current
- 16-bit resolution ALS
- 12-bit/16-bit resolution PS
- Detection distance of up to 1.5m
- Interrupt function available for ALS and PS with upper and lower thresholds

Info: 7-bit I²C address: 0x51.

Figure 6-6. Proximity and Ambient Light Sensor

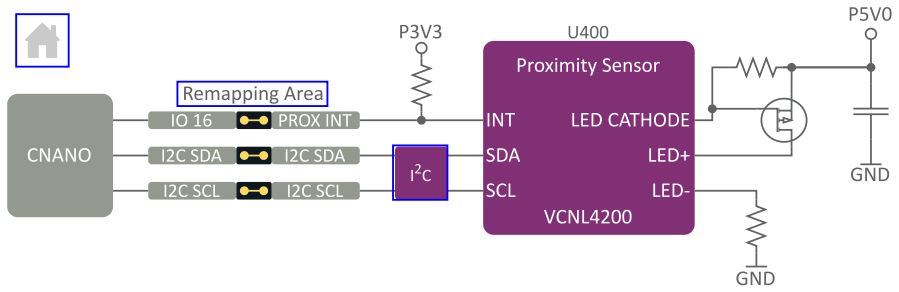
[picture p46: figure]

Serial Communication
6.3.5. 2 Mb Serial EEPROM
AT24CM02 (https://www.microchip.com/en-us/product/at24cm02) is a 2 Mb Serial EEPROM connected to the Explorer’s I

2C bus.
- 1024 pages of 256 bytes each
- Random, byte and sequential read modes
- Byte and page write modes
- Built in error detection and correction
- Hardware write protection

Info: 7-bit I²C address space: 0x54 - 0x57.

Figure 6-7. I

2C EEPROM

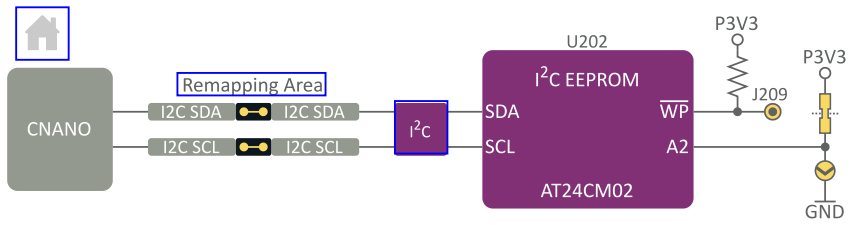
[picture p47: figure]

Info: The write protect pin is available through pin header footprint J209 and can be remapped to the CNANO socket.

### 6.3.6. I/O Expanders

The Explorer features two MCP23008 (https://www.microchip.com/en-us/product/MCP23008) I/O expanders connected to the I²C bus.
- 8-bit bidirectional I/O port
- I/O pins default to input
- Configurable interrupt output pin
I/O Expander 1 is set up to control the LED row containing eight yellow LEDs.
- See chapter LED Row and I/O Expander 1 for more information.
I/O Expander 2 is set up to read the status of the joystick and tactile or touch buttons.
- See chapter Buttons, Joystick and I/O Expander 2 for more information.

Serial Communication

### 6.3.7. OLED Display Module

The Explorer features an OLED display connected to the I²C bus.
- SSD1306 display driver
- 1.30” screen size with 128x64 pixel resolution
- Fast response time (≦ 10 µs)
- Typical brightness: 120 cd/m²

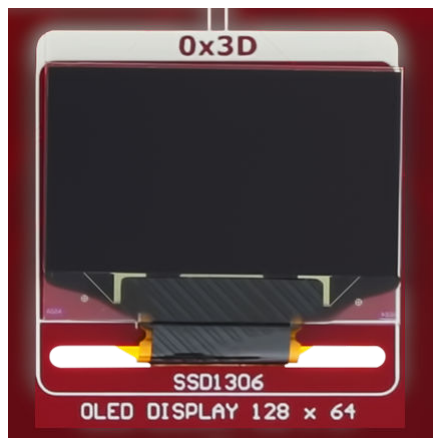
[picture p48: figure]

Info: 7-bit I²C address: 0x3D. Alternative I²C address 0x3C can be used by connecting pin A0 to GND.

Figure 6-8. OLED Display

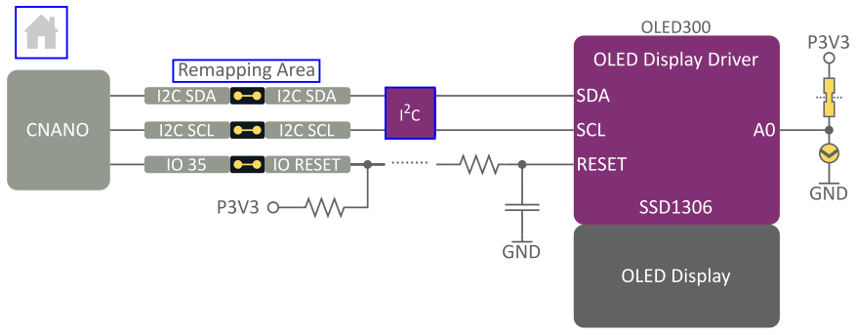
[picture p49: figure]

## 6.4. SPI Peripherals

### 6.4.1. SPI Bus

The Explorer features an SPI bus with several peripherals and a MikroBus socket attached. The individual Chip Select (CS) pins and the mutual SPI bus pins are routed to the CNANO socket.

Figure 6-9. SPI Bus Overview

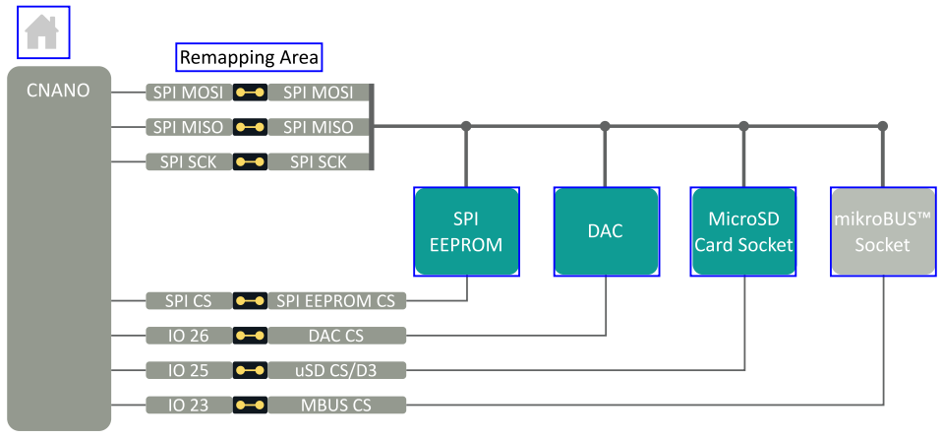
[picture p50: figure]

Serial Communication
Info: A 47 kΩ pull-up resistor (R221) is mounted on the MISO line close to the microSD card socket, causing the MISO line to idle high.

### 6.4.2. Digital-to-Analog Converter

MCP4821 (https://www.microchip.com/en-us/product/mcp4821) is a single-channel 12-bit Digital-to-Analog converter (DAC) with internal voltage reference. The DAC is connected to the SPI bus on the Explorer.
- SPI with 20 MHz clock support
- 2.048V Internal voltage reference (Vref)
- DAC output, limited by supply voltage (3.3V)
- Synchronous update of DAC output using the LDAC pin

Table 6-2. Programmable Gain
Gain Selection | Ideal Output Range | LSb Size
2.048V | 0.0-2.0475V | 0.5 mV
4.096V | 0.0-3.299V | 1.0 mV

Figure 6-10. DAC Overview

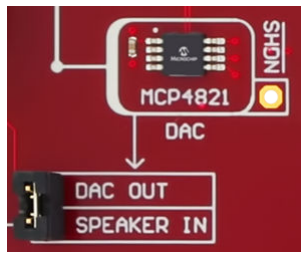
[picture p51: figure]
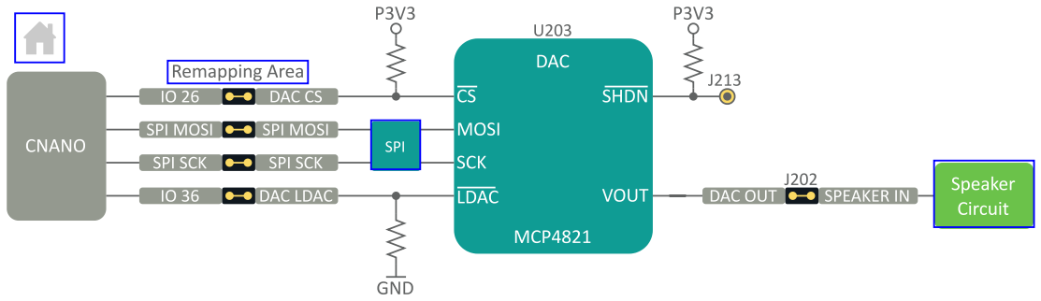
[picture p52: figure]

Tip: The DAC output is connected to the speaker circuit by default. It can be remapped using pin header J202.

6.4.3. 4 Mb Serial EEPROM
25CSM04 (https://www.microchip.com/en-us/product/25CSM04) is a 4 Mb Serial EEPROM connected to the Explorer’s SPI bus.
- SPI with up to 8 MHz clock support
- 2048 pages of 256 bytes each
- Byte or sequential reads
- Byte or page writes
- Built-in Error Correction Code (ECC)
- Configurable software and/or hardware write protection

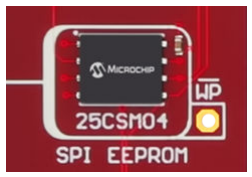
[picture p53: figure]

Serial Communication
Figure 6-11. SPI EEPROM

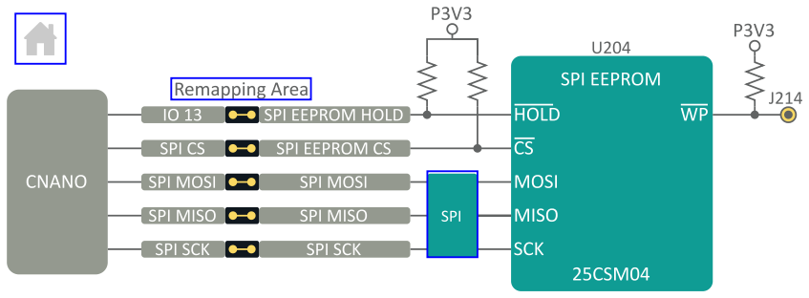
[picture p54: figure]

Tip: Enable the hardware write-protected feature by pulling the WP pin low.

### 6.4.4. microSD Card Socket

The Explorer features a microSD card socket connected to its SPI bus. Only pins required for an SPI connection to a microSD card are connected to the CNANO socket.
All pins of the microSD card socket are available on pin headers close to the microSD card socket. The pin headers allow devices with a dedicated
high-speed multimedia interface to fully utilize all
data lines of a connected microSD card.

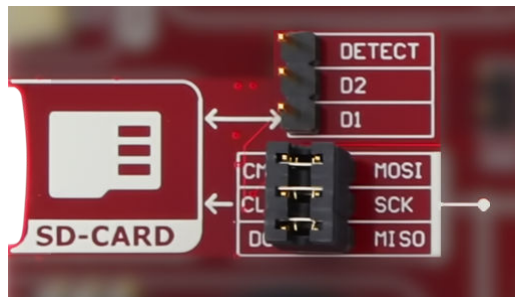
[picture p55: figure]

Tip: D1, D2, and the card detect pins are routed to a separate pin header (J212). With no card inserted, the card-detect pin is low.

Figure 6-12. microSD Card

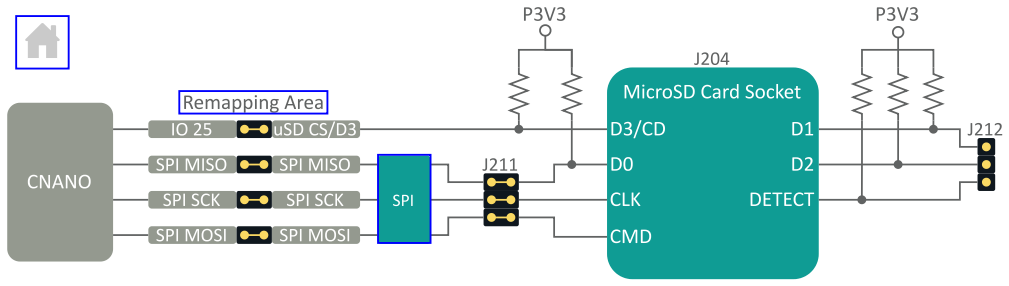
[picture p56: figure]

Info: A 47 kΩ pull-up resistor (R221) is mounted on the MISO line close to the microSD card socket, causing the MISO line to idle high.

Analog Peripherals

## 7. Analog Peripherals

Microphone Circuit, Speaker Circuit, Rotary Potentiometer, Voltage Reference.

## 7.1. Microphone Circuit

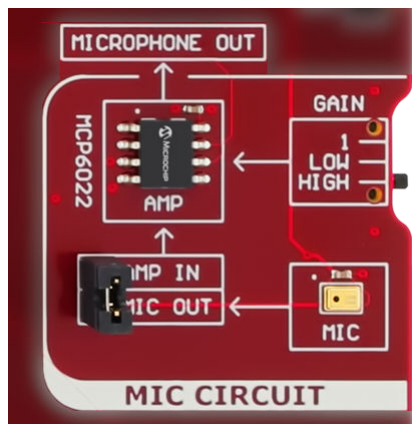
[picture p57: figure]

A MEMS microphone is available as an analog input peripheral on the Explorer and is connected to its amplifier through the 1x2 pin header J206.
The dual operational amplifier MCP6022 (https://www.microchip.com/en-us/product/MCP6022) is used to amplify the signal from the microphone with three selectable gain stages. The gain stages are 1, 221 (low) and 1001 (high), selectable using the slide switch S200.

Figure 7-1. Microphone Circuit Overview

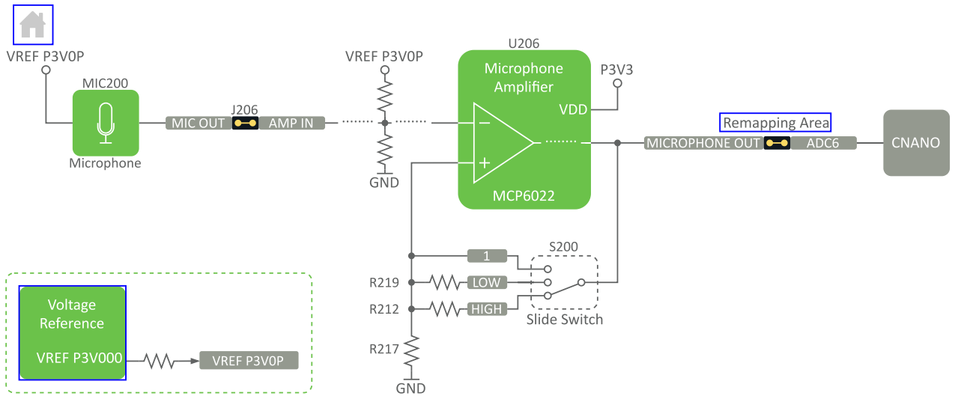
[picture p58: figure]

Tip: The microphone output can be disconnected from the amplifier and accessed directly through the 1x2 pin header J206.

Analog Peripherals

## 7.2. Speaker Circuit

The Explorer features an 8Ω, 0.2W miniature speaker. The speaker amplifier input signal is, by default, connected to the output of the 12-bit DAC MCP4821. (https://www.microchip.com/en-us/product/mcp4821)
A Class-D mono amplifier drives the speaker. Volume control is

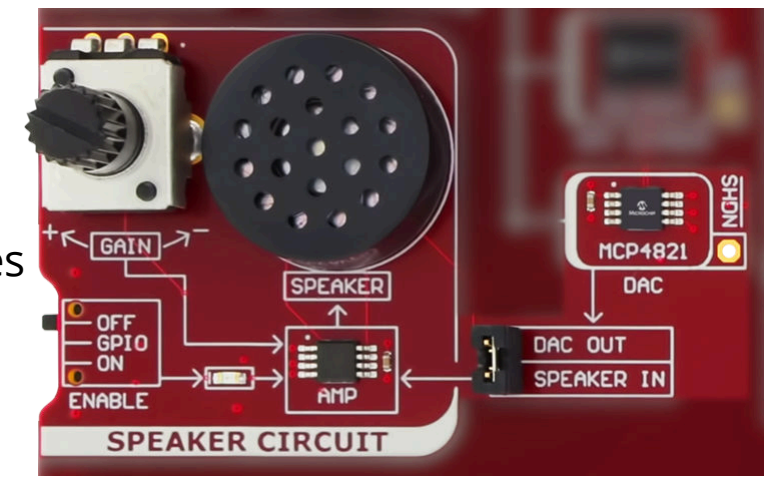
[picture p59: figure]

implemented with the rotary potentiometer R210, which provides an approximate logarithmic gain control for the amplifier input.

Tip: Pin header J202 can be used to remap the
speaker input signal and/or DAC output.

Figure 7-2. Speaker Circuit Overview

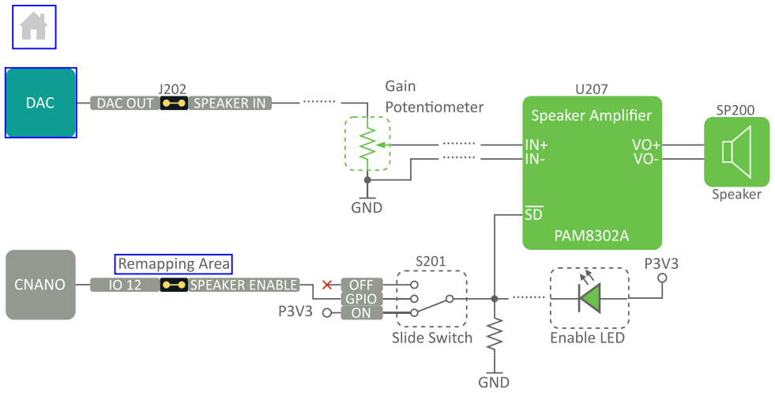
[picture p60: figure]

## 7.3. Rotary Potentiometer

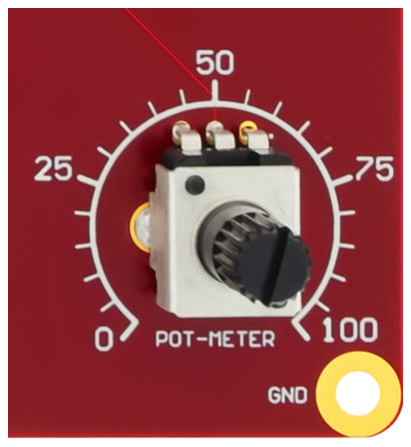
[picture p61: figure]

A 10 kΩ ±20% rotary potentiometer is available to the user as an analog input (R421). The voltage output varies between 0V and 3.3V. The voltage output increases when turning the potentiometer clockwise.

Figure 7-3. Rotary Potentiometer

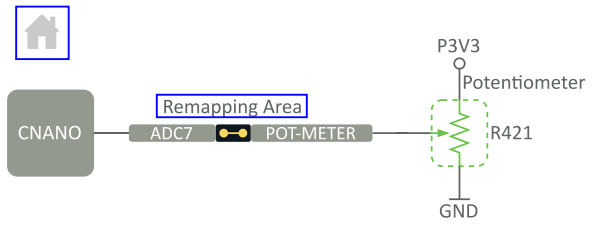
[picture p62: figure]

## 7.4. Voltage Reference

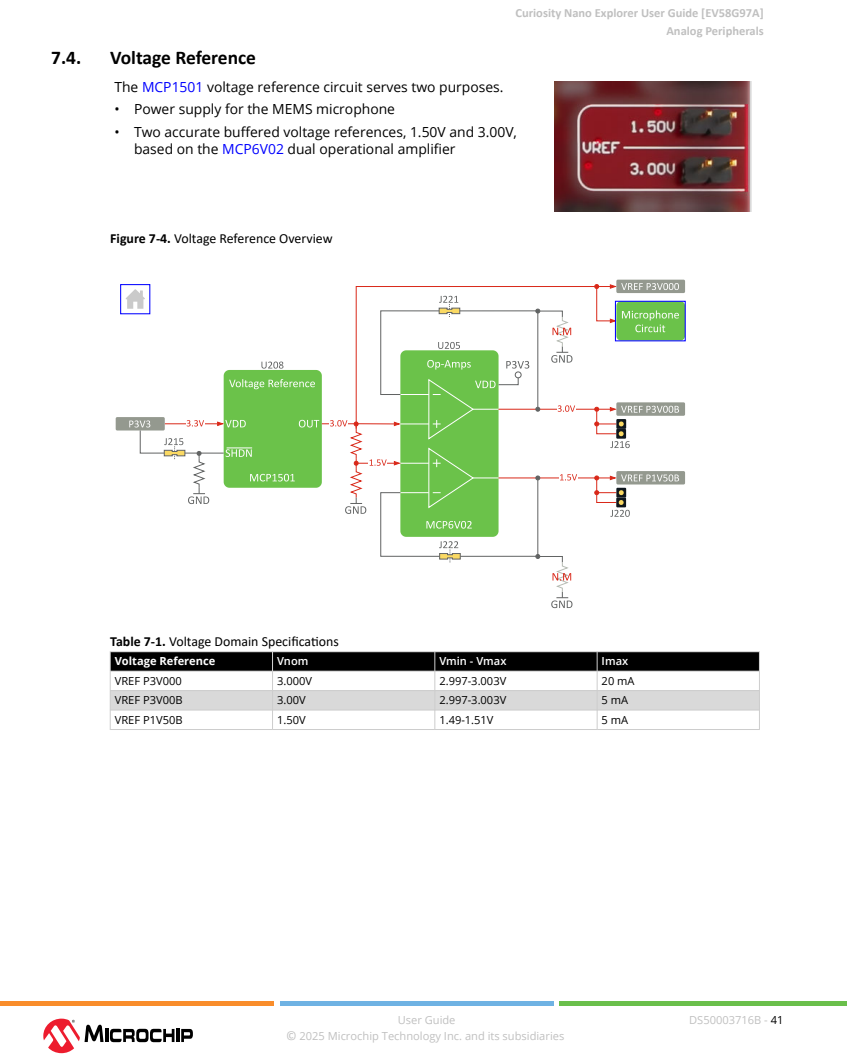
[picture p63: page 41]
Analog Peripherals

The MCP1501 (https://www.microchip.com/en-us/product/MCP1501) voltage reference circuit serves two purposes.
• Power supply for the MEMS microphone
• Two accurate buffered voltage references, 1.50V and 3.00V,
based on the MCP6V02 (https://www.microchip.com/en-us/product/MCP6V02) dual operational amplifier

Figure 7-4. Voltage Reference Overview

Table 7-1. Voltage Domain Specifications

Voltage Reference | Vnom | Vmin - Vmax | Imax
VREF P3V000 | 3.000V | 2.997-3.003V | 20 mA
VREF P3V00B | 3.00V | 2.997-3.003V | 5 mA
VREF P1V50B | 1.50V | 1.49-1.51V | 5 mA

External Connectivity

## 8. External Connectivity

Servomotor Headers, MikroBUS™, Grove, Qwiic®, PICkit™ Header.

## 8.1. Servomotor Headers

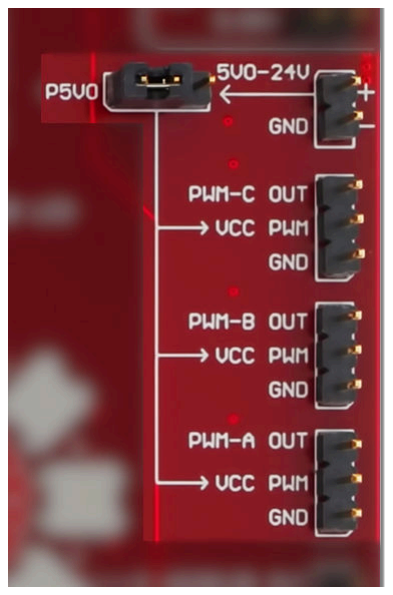
[picture p64: figure]

The Explorer features three-pin headers compatible with typical servomotor pinouts. The control signal of each pin header has a MOSFET-driven open-drain output.
The 5V supply on the board usually supplies the control signal and power output on the pin headers. External power can be supplied through pin header J310. Select between on-board and external power using pin header J308.

Info: The RGB LED will light up when driving
servomotors and can be disconnected by removing
pin jumpers from J309.

Figure 8-1. Servomotor Driver Circuit

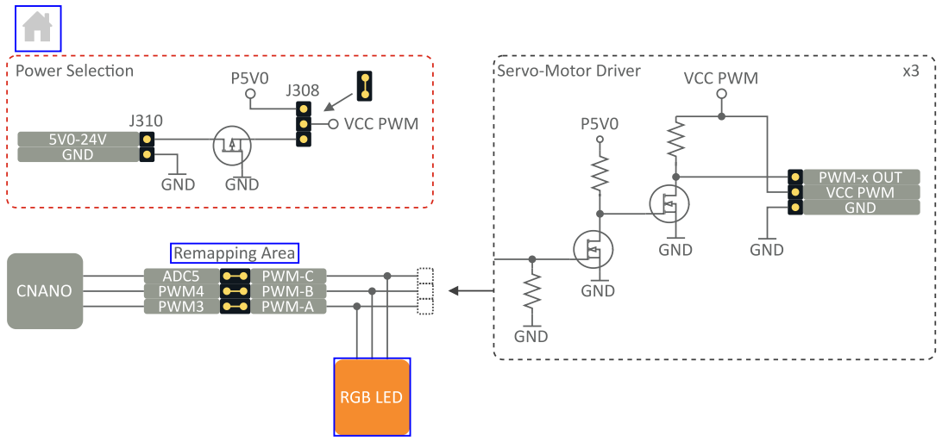
[picture p65: figure]

Important:
Servomotors usually require high currents. It is recommended to use an external supply to power servomotors.
The circuit is rated for external power in the range of 5-24V.

External Connectivity

## 8.2. MikroBUS™ Socket

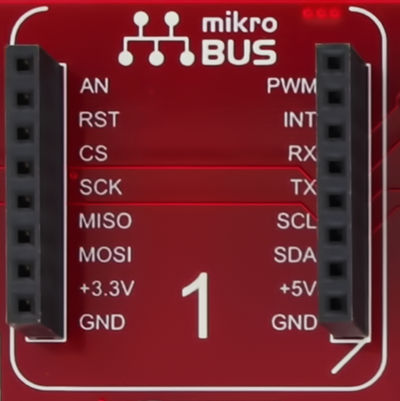
[picture p66: figure]

The Explorer features a mikroBUS™ (https://www.mikroe.com/mikrobus) socket for Mikroelektronika Click boards™. The socket is connected to the Explorer's main I²C and SPI bus.
UART pins are shared between the USB bridge and the mikroBUS™ socket. Select your UART connections using the slide-switch S501.
The PWM pin is shared with the single RGB LED and servomotor driver and can be remapped with pin header J203.

Figure 8-2. MikroBUS™ Socket

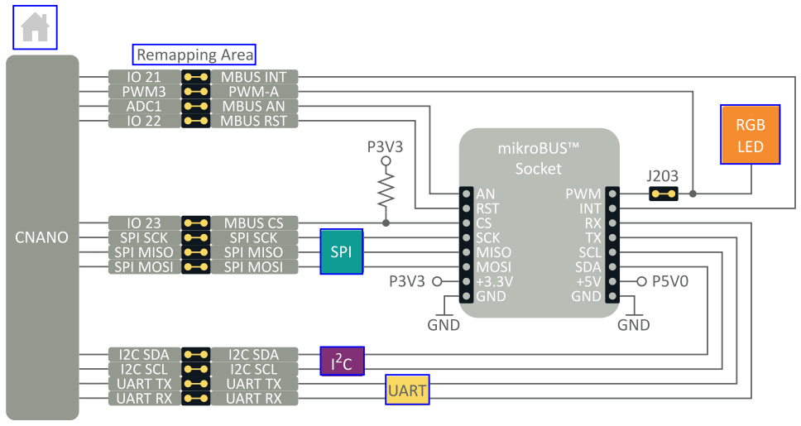
[picture p67: figure]

## 8.3. Grove

The Explorer features a Grove (https://wiki.seeedstudio.com/Grove_System/) connector. The Grove system allows rapid prototyping using modular building blocks with many modules to choose from.

Figure 8-3. Grove Connector

External Connectivity

## 8.4. Qwiic®

The Explorer includes a 4-pin Qwiic® (https://www.sparkfun.com/qwiic) connector for easy daisy-chaining of multiple devices within the SparkFun Qwiic Connect System.

Figure 8-4. Qwiic Connector

## 8.5. PICkit™ Header

The Explorer has a 1x8 PICkit™-compatible connector footprint connected to the CNANO's debug pins.
A slide switch (S100) allows the user to select the programming interface for the connected CNANO. Position 1 for UPDI/ICSP™ and position 2 for SWD.

To use a PICkit™ with the Explorer, the user must insert the included 1x8 right-angled pin header into the staggered footprint J122.

Tip: For repeated use, it is recommended to solder in the 1x8 right-angled pin
header.

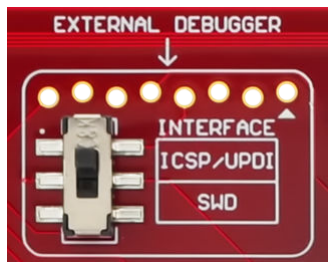
[picture p68: figure]

Figure 8-5. Overview

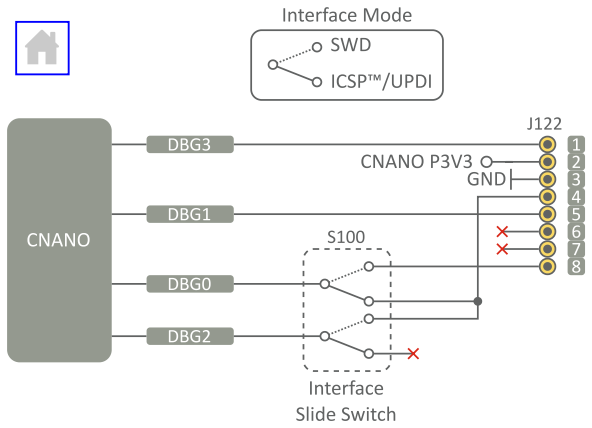
[picture p69: figure]

Hardware Revision History

## 9. Hardware Revision History

## 9.1. Identifying Product ID and Revision

There are two ways to find the revision and product identifier of the Curiosity Nano Explorer: The MPLAB® X IDE Kit Window or the sticker on the bottom of the PCB.

The Kit Window appears in MPLAB X IDE when connecting a Curiosity Nano development board to the computer. An additional page for the Curiosity Nano Explorer shows when the CNANO is plugged into the socket on the board.
The first nine digits of the serial number, listed under kit information, contain the product identifier and revision.

Tip:  If closed, the Kit Window can be opened in MPLAB X IDE through the menu
bar Window > Kit Window.

The same information is found on the sticker on the bottom side of the PCB. The data matrix code on the sticker contains a string with the product identifier 02-00630, revision, and serial number. The product identifier and revision are also printed in plain text as 02-00630/rr, where "rr" represents the revision. The serial number is printed on the following line.
The string in the data matrix code has the following format:

"nnnnnnnrrsssssssss"
n = product identifier
r = revision
s = serial number

## 9.2. Hardware Revision History and Errata

This user guide provides information about the latest available revision of the board. Revision history and errata are available in the Curiosity Nano Explorer Online Errata. (https://onlinedocs.microchip.com/g/GUID-2B07EF5D-DD0E-43DF-9A21-7FCEBF41749E)

## 9.3. Document Revision History

Doc. Rev. | Date | Comments
B | 8/2025 | Updated to reflect Curiosity Nano Explorer Revision 4
A | 6/2024 | Initial document release

Appendix

## 10. Appendix

MTCH1030 Touch Tune Data, Addressable LEDs Timing and Format, Schematics, Assembly Drawing. Schematics, and assembly drawing for the latest board revision are available as a PDF here. (https://ww1.microchip.com/downloads/aemDocuments/documents/MCU08/ProductDocuments/BoardDesignFiles/Curiosity-Nano-Explorer-Schematics.pdf)

## 10.1. MTCH1030 Touch Tune Data

Touch sensor data captured with MTCH1030 can be visualized using the MPLAB® Data Visualizer. (https://www.microchip.com/en-us/tools-resources/debug/mplab-data-visualizer) UART data is output from MTCH1030 on the SW1 pin on the Explorer and can be streamed to the Data Visualizer through the on-board USB bridge.

Important: Power off the Explorer before making any changes to the pin
mapping.

To stream data from the MTCH1030, follow the steps below:
1. Remove the UART TX jumper cap in the pin remapping area.
2. Remove the SW1 jumper cap in the pin remapping area.
3. Make sure that the UART slide switch (S501) is set to connect the Explorer UART to the MCP2221A.
4. Connect the peripheral side of both SW1 and UART TX using a jumper wire.
5. Keep the mechanical SW2 button pressed while powering on the Explorer.
6. Follow the steps in the MTCH1030 data sheet appendix (https://onlinedocs.microchip.com/oxy/GUID-6F038D55-383D-40CD-9C7B-E9EEFD83B8A3-en-US-1/GUID-E100F423-C220-422C-A4CF-49A7C338705D.html) to configure the Data Visualizer.

Figure 10-1. Enabling Touch Tune Data

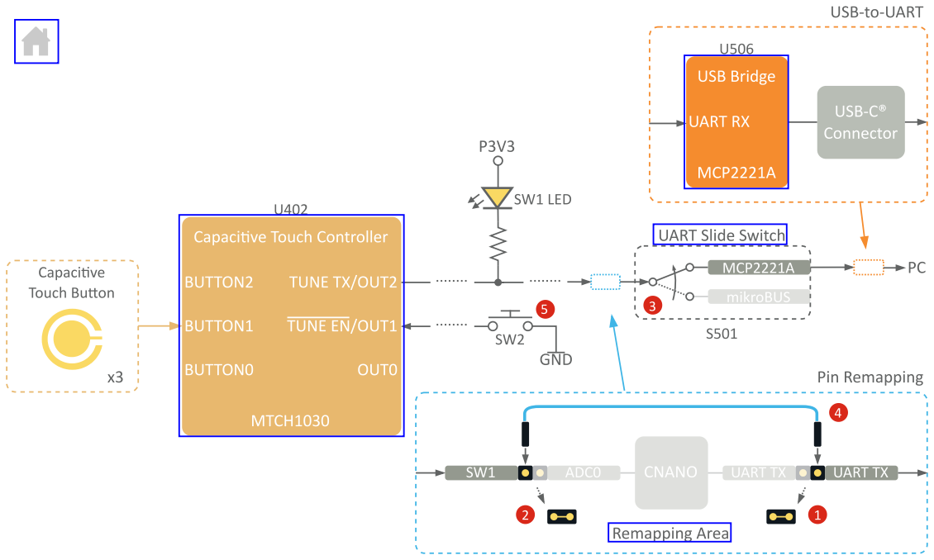
[picture p70: figure]

Related information: Touch Controller

## 10.2. Addressable LEDs Timing and Format

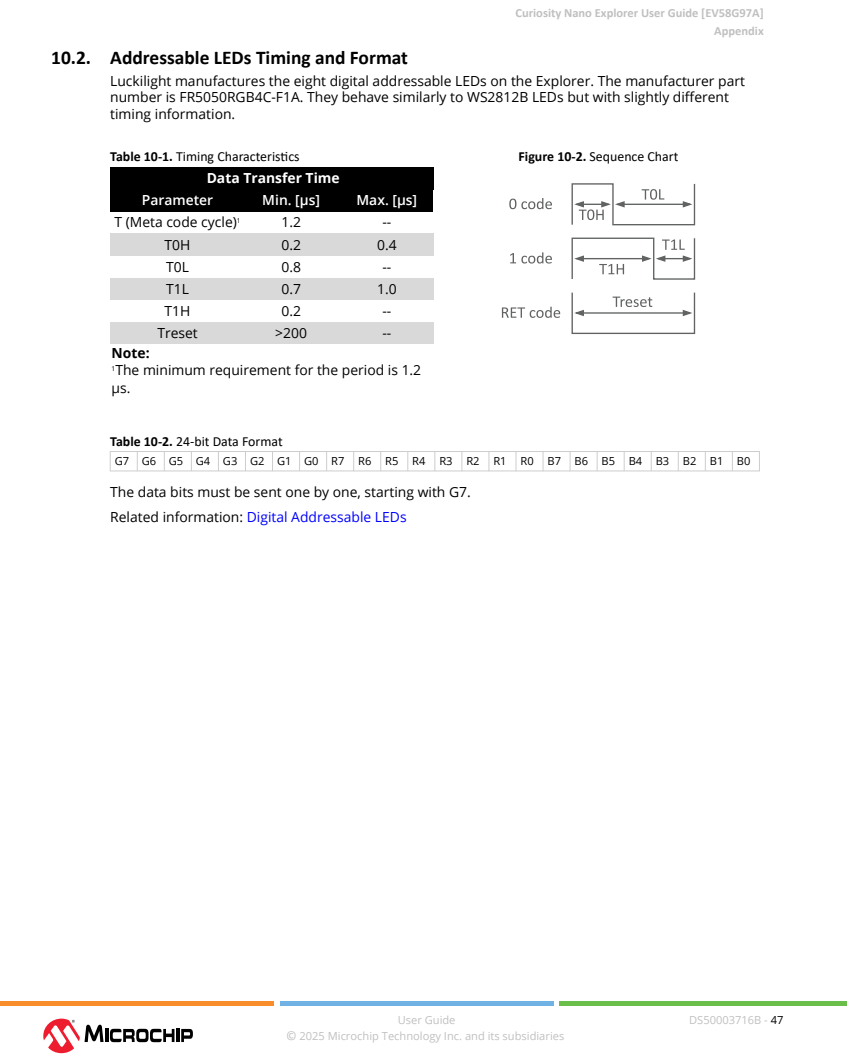
[picture p71: page 47]

Luckilight manufactures the eight digital addressable LEDs on the Explorer. The manufacturer part
number is FR5050RGB4C-F1A. They behave similarly to WS2812B LEDs but with slightly different
timing information.

Note:
1The minimum requirement for the period is 1.2

Table 10-2. 24-bit Data Format
The data bits must be sent one by one, starting with G7.
Related information: Digital Addressable LEDs

## 10.3. Schematics

# Curiosity Nano Explorer

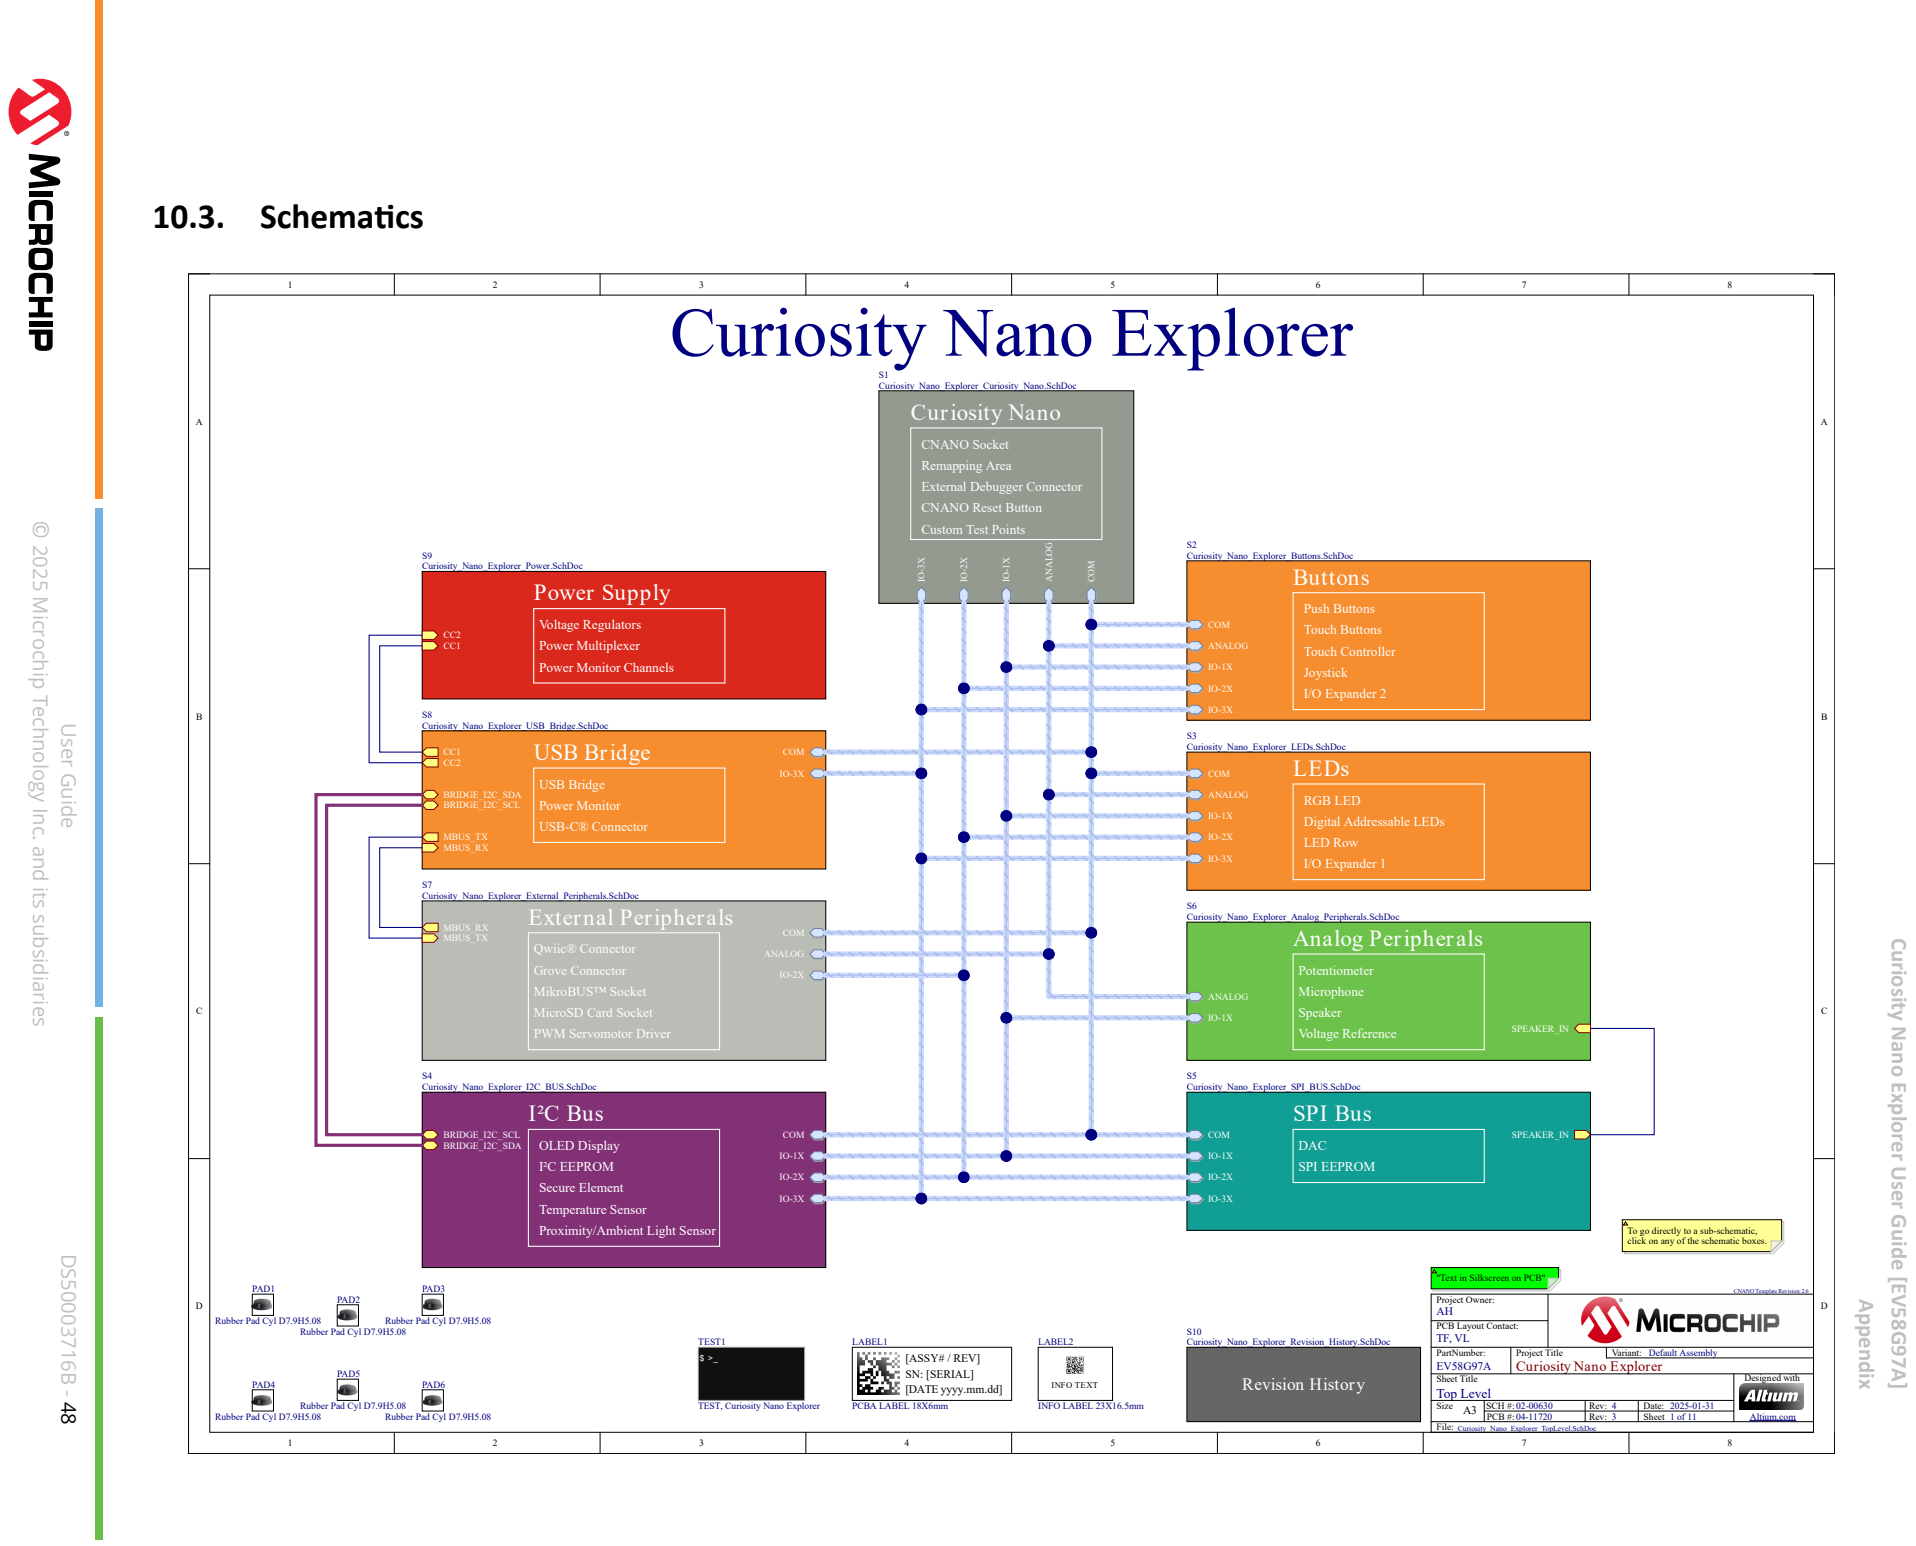
[picture p72: page 48]
Appendix; User Guide; rotatethispage90; Curiosity_Nano_Explorer_TopLevel.SchDoc; File:; PartNumber:; Variant: Default Assembly; ANALOG; SPEAKER_IN; S6 Curiosity_Nano_Explorer_Analog_Peripherals.SchDoc; COM; S1 Curiosity_Nano_Explorer_Curiosity_Nano.SchDoc; MBUS_TX; MBUS_RX; S7 Curiosity_Nano_Explorer_External_Peripherals.SchDoc; S10 Curiosity_Nano_Explorer_Revision_History.SchDoc; PCBA LABEL 18X6mm; LABEL1; S9 Curiosity_Nano_Explorer_Power.SchDoc; S2 Curiosity_Nano_Explorer_Buttons.SchDoc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

CNANO Socket
Remapping Area
External Debugger Connector
CNANO Reset Button
Custom Test Points

© 2025 Microchip Technology Inc. and its subsidiaries

Voltage Regulators
Power Multiplexer
Power Monitor Channels

RGB LED
Digital Addressable LEDs
LED Row
I/O Expander 1

Curiosity Nano Explorer User Guide [EV58G97A]

Qwiic® Connector
Grove Connector
MikroBUS™ Socket
MicroSD Card Socket
PWM Servomotor Driver

OLED Display
I²C EEPROM
Secure Element
Temperature Sensor
Proximity/Ambient Light Sensor

To go directly to a sub-schematic,
click on any of the schematic boxes.

"Text in Silkscreen on PCB"

Rubber Pad Cyl D7.9H5.08

Project Owner:
PCB Layout Contact:

CNANO Template Revision: 2.6

[ASSY# / REV]
SN: [SERIAL]
[DATE yyyy.mm.dd]

Project Title
Curiosity Nano Explorer

Sheet Title Top Level | Designed with Altium.com

TEST, Curiosity Nano Explorer

Size A3 | SCH #: 02-00630 | Rev: 4 | Date: 2025-01-31

PCB #: 04-11720 | Rev: 3 | Sheet

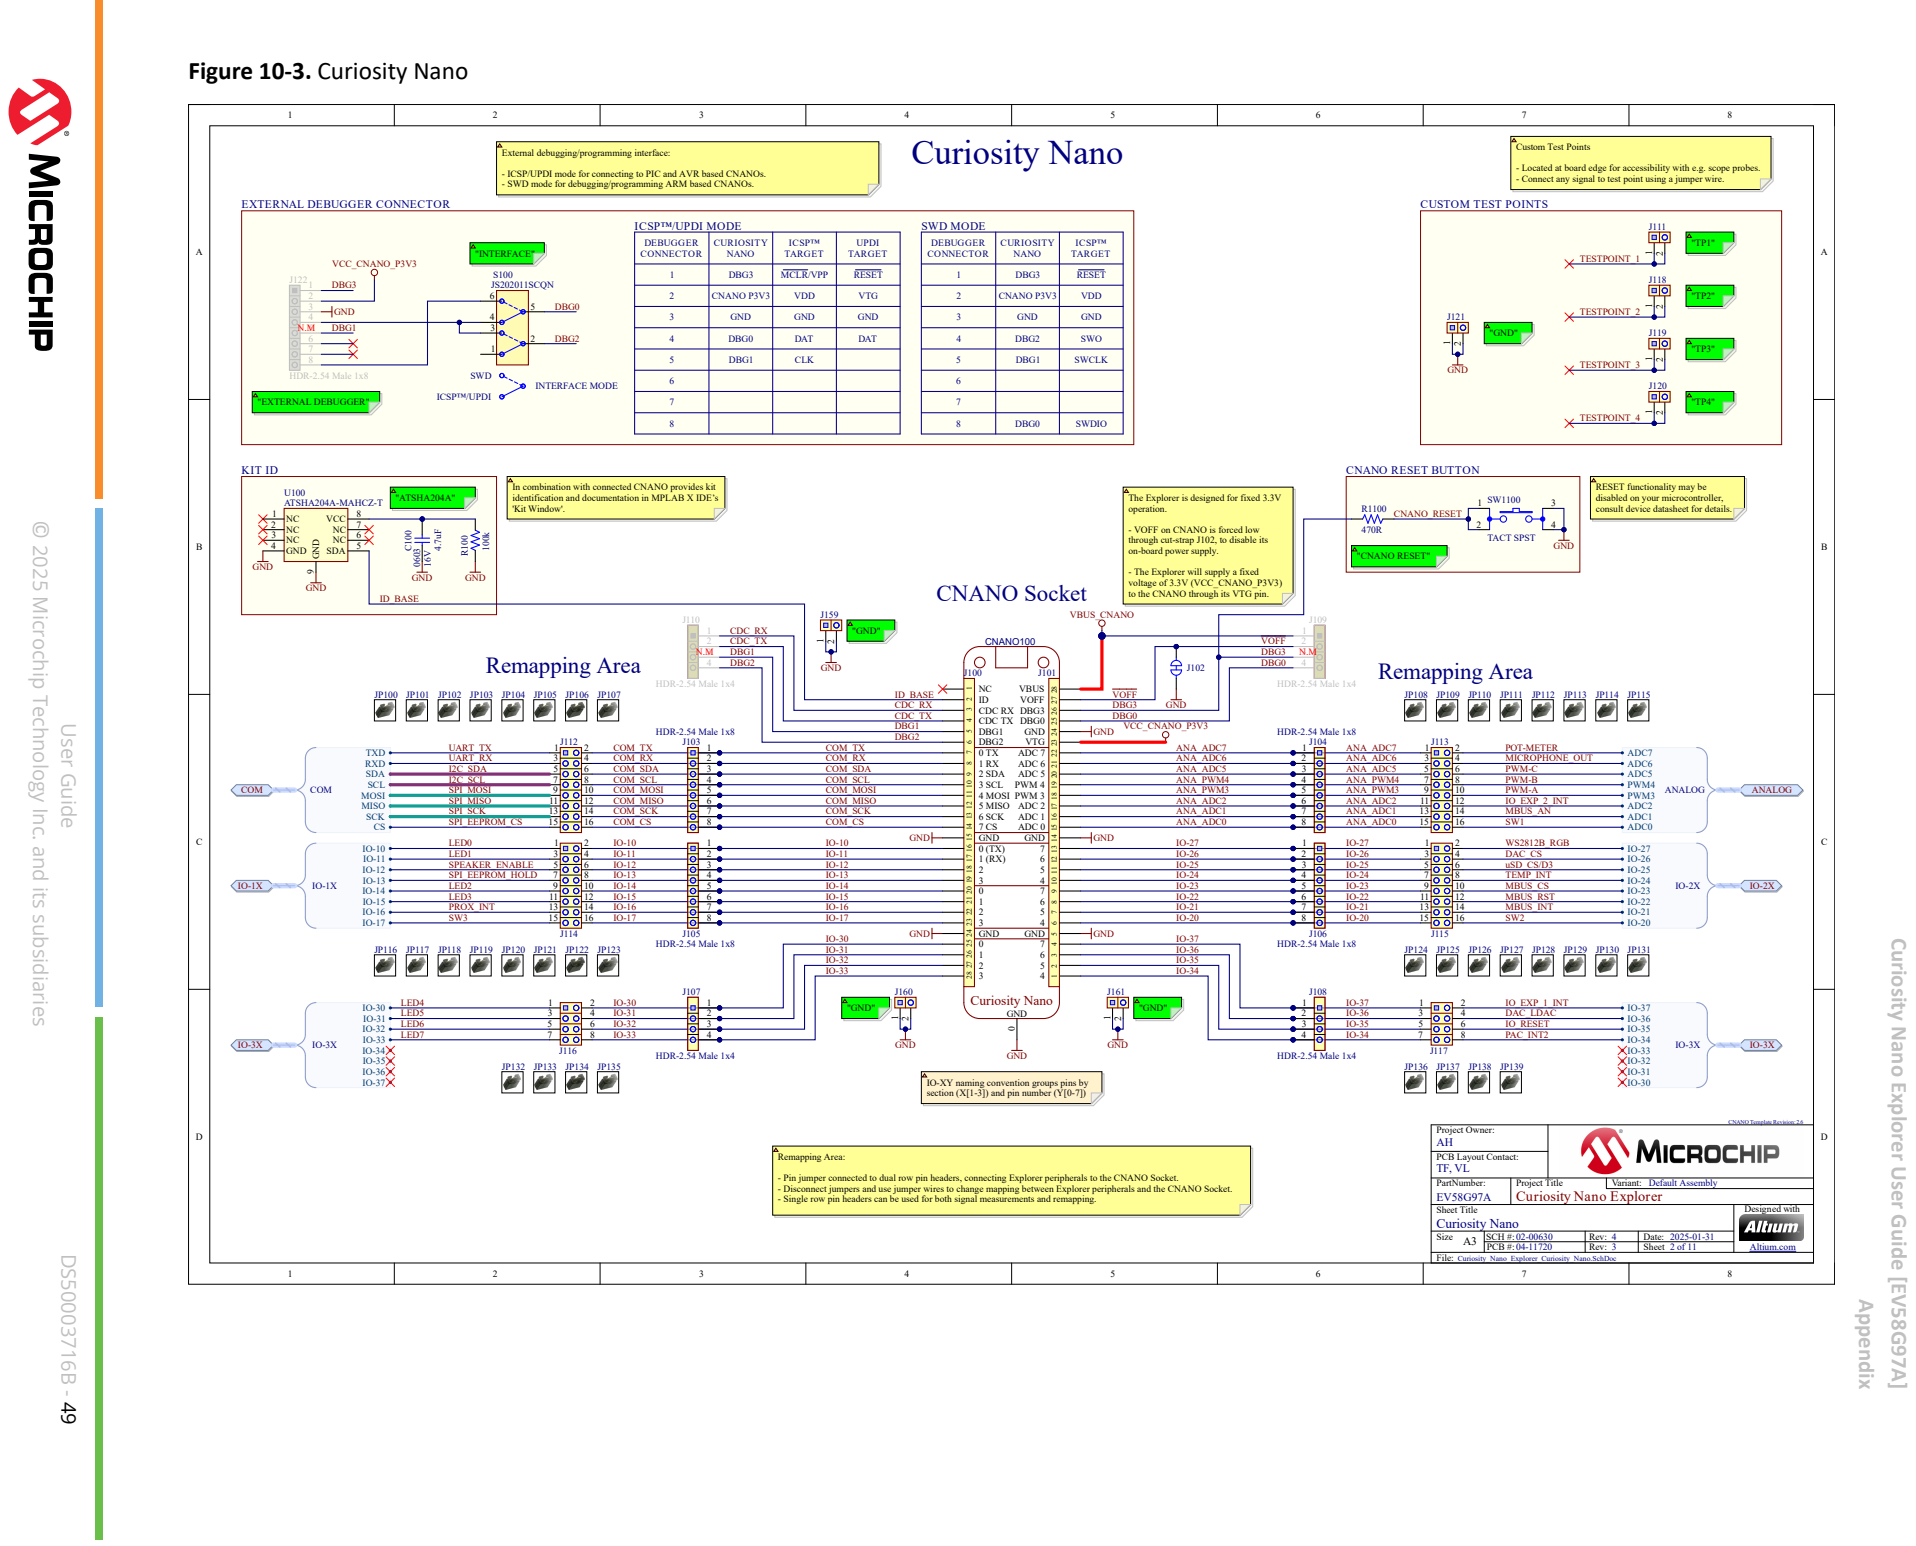
[picture p73: page 49]

External debugging/programming interface:

- ICSP/UPDI mode for connecting to PIC and AVR based CNANOs.
- SWD mode for debugging/programming ARM based CNANOs.

- Located at board edge for accessibility with e.g. scope probes.
- Connect any signal to test point using a jumper wire.

In combination with connected CNANO provides kit
identification and documentation in MPLAB X IDE’s
'Kit Window'.

The Explorer is designed for fixed 3.3V
operation.

RESET functionality may be
disabled on your microcontroller,
consult device datasheet for details.

© 2025 Microchip Technology Inc. and its subsidiaries

- VOFF on CNANO is forced low
through cut-strap J102, to disable its
on-board power supply.

- The Explorer will supply a fixed
voltage of 3.3V (VCC_CNANO_P3V3)
to the CNANO through its VTG pin.

Curiosity Nano Explorer User Guide [EV58G97A]

IO-XY naming convention groups pins by
section (X[1-3]) and pin number (Y[0-7])

- Pin jumper connected to dual row pin headers, connecting Explorer peripherals to the CNANO Socket.
- Disconnect jumpers and use jumper wires to change mapping between Explorer peripherals and the CNANO Socket.
- Single row pin headers can be used for both signal measurements and remapping.

Sheet Title Curiosity Nano | Designed with Altium.com

Size A3 | SCH #: 02-00630 | Rev: 4 | Date: 2025-01-31

PCB #: 04-11720 | Rev: 3 | Sheet 2 of 11

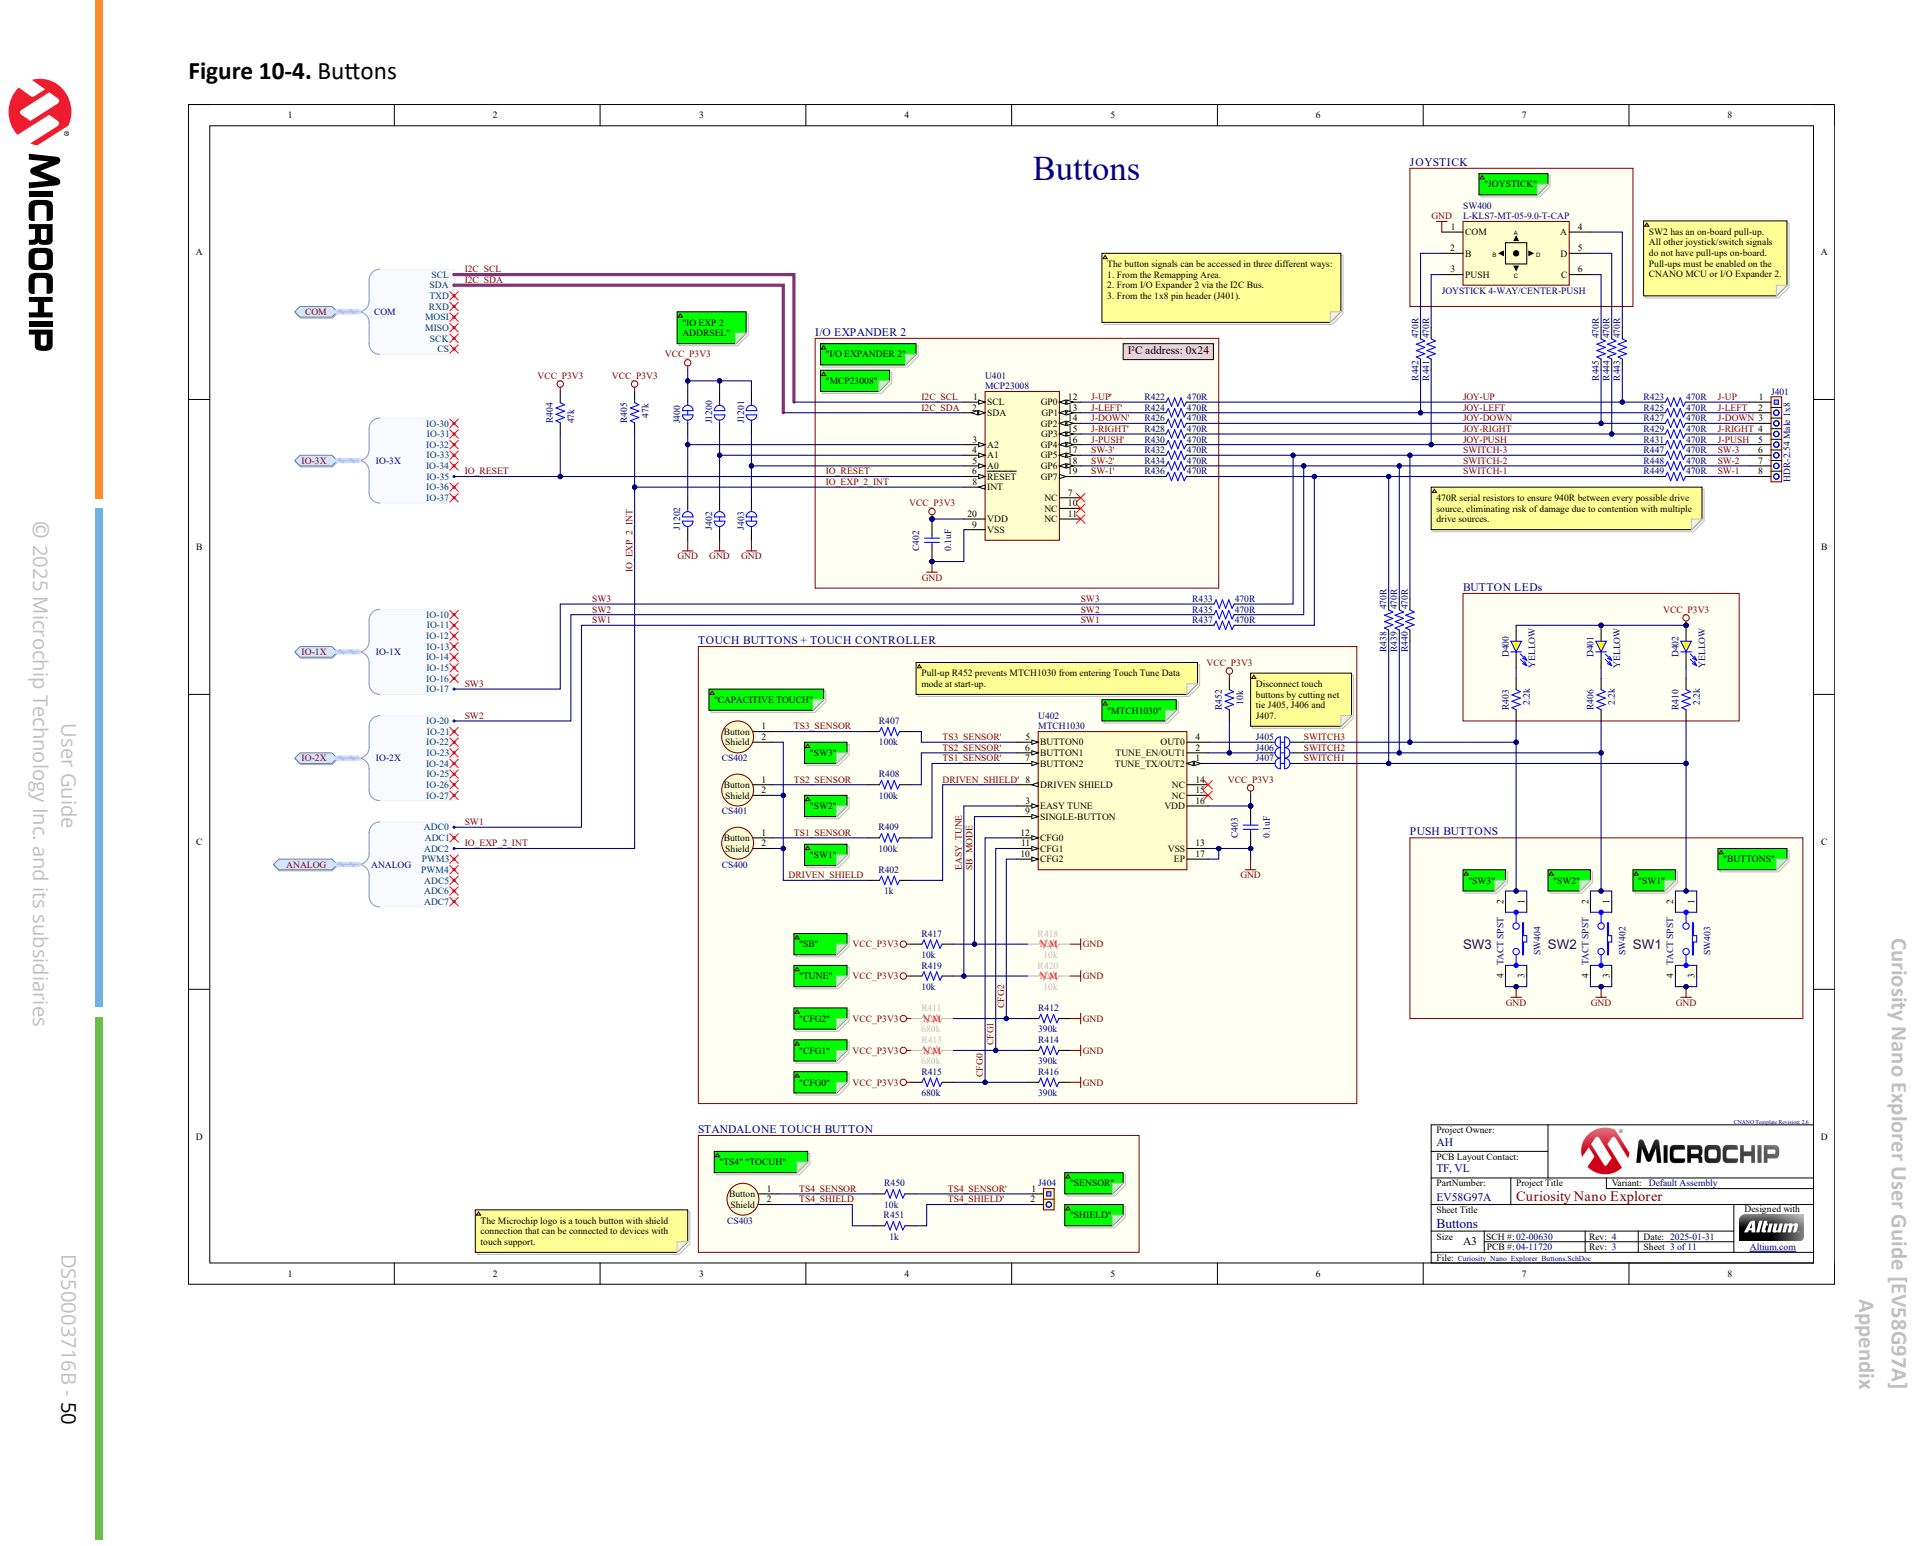
[picture p74: page 50]

SW2 has an on-board pull-up.
All other joystick/switch signals
do not have pull-ups on-board.
Pull-ups must be enabled on the
CNANO MCU or I/O Expander 2.

The button signals can be accessed in three different ways:
1. From the Remapping Area.
2. From I/O Expander 2 via the I2C Bus.
3. From the 1x8 pin header (J401).

470R serial resistors to ensure 940R between every possible drive
source, eliminating risk of damage due to contention with multiple
drive sources.

© 2025 Microchip Technology Inc. and its subsidiaries

TOUCH BUTTONS + TOUCH CONTROLLER

Pull-up R452 prevents MTCH1030 from entering Touch Tune Data

buttons by cutting net
tie J405, J406 and

Curiosity Nano Explorer User Guide [EV58G97A]

The Microchip logo is a touch button with shield
connection that can be connected to devices with
touch support.

Sheet Title Buttons | Designed with Altium.com

Size A3 | SCH #: 02-00630 | Rev: 4 | Date: 2025-01-31

PCB #: 04-11720 | Rev: 3 | Sheet 3 of 11

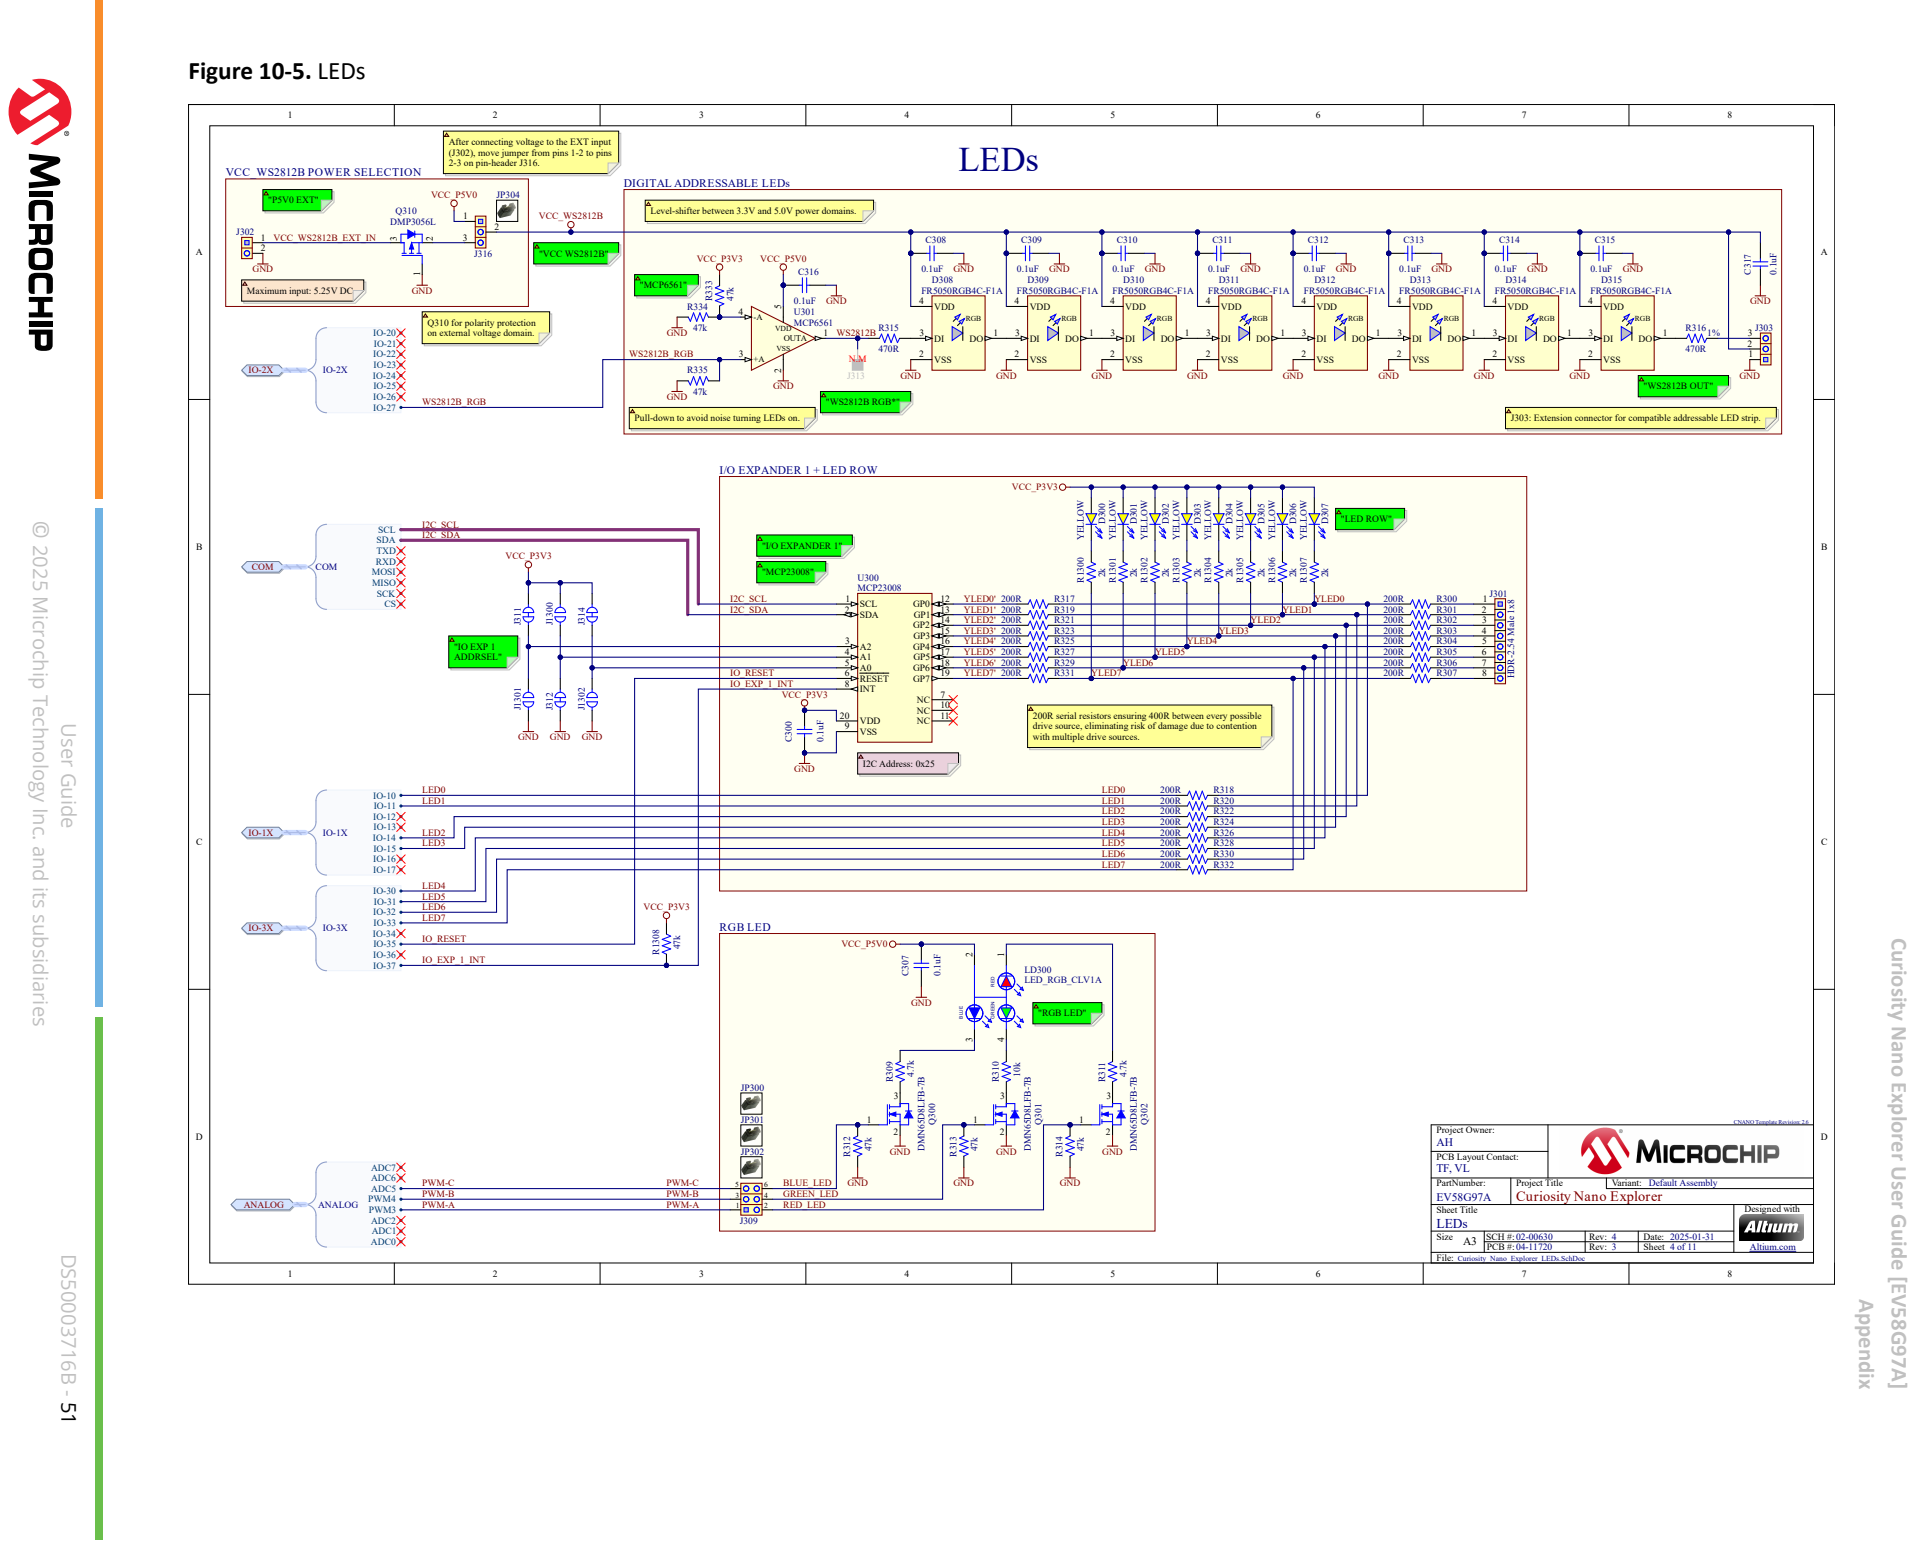
[picture p75: page 51]

After connecting voltage to the EXT input
(J302), move jumper from pins 1-2 to pins
2-3 on pin-header J316.

Level-shifter between 3.3V and 5.0V power domains.

Q310 for polarity protection
on external voltage domain.

Pull-down to avoid noise turning LEDs on.

J303: Extension connector for compatible addressable LED strip.

© 2025 Microchip Technology Inc. and its subsidiaries

200R serial resistors ensuring 400R between every possible
drive source, eliminating risk of damage due to contention
with multiple drive sources.

Curiosity Nano Explorer User Guide [EV58G97A]

Sheet Title LEDs | Designed with Altium.com

Size A3 | SCH #: 02-00630 | Rev: 4 | Date: 2025-01-31

PCB #: 04-11720 | Rev: 3 | Sheet 4 of 11

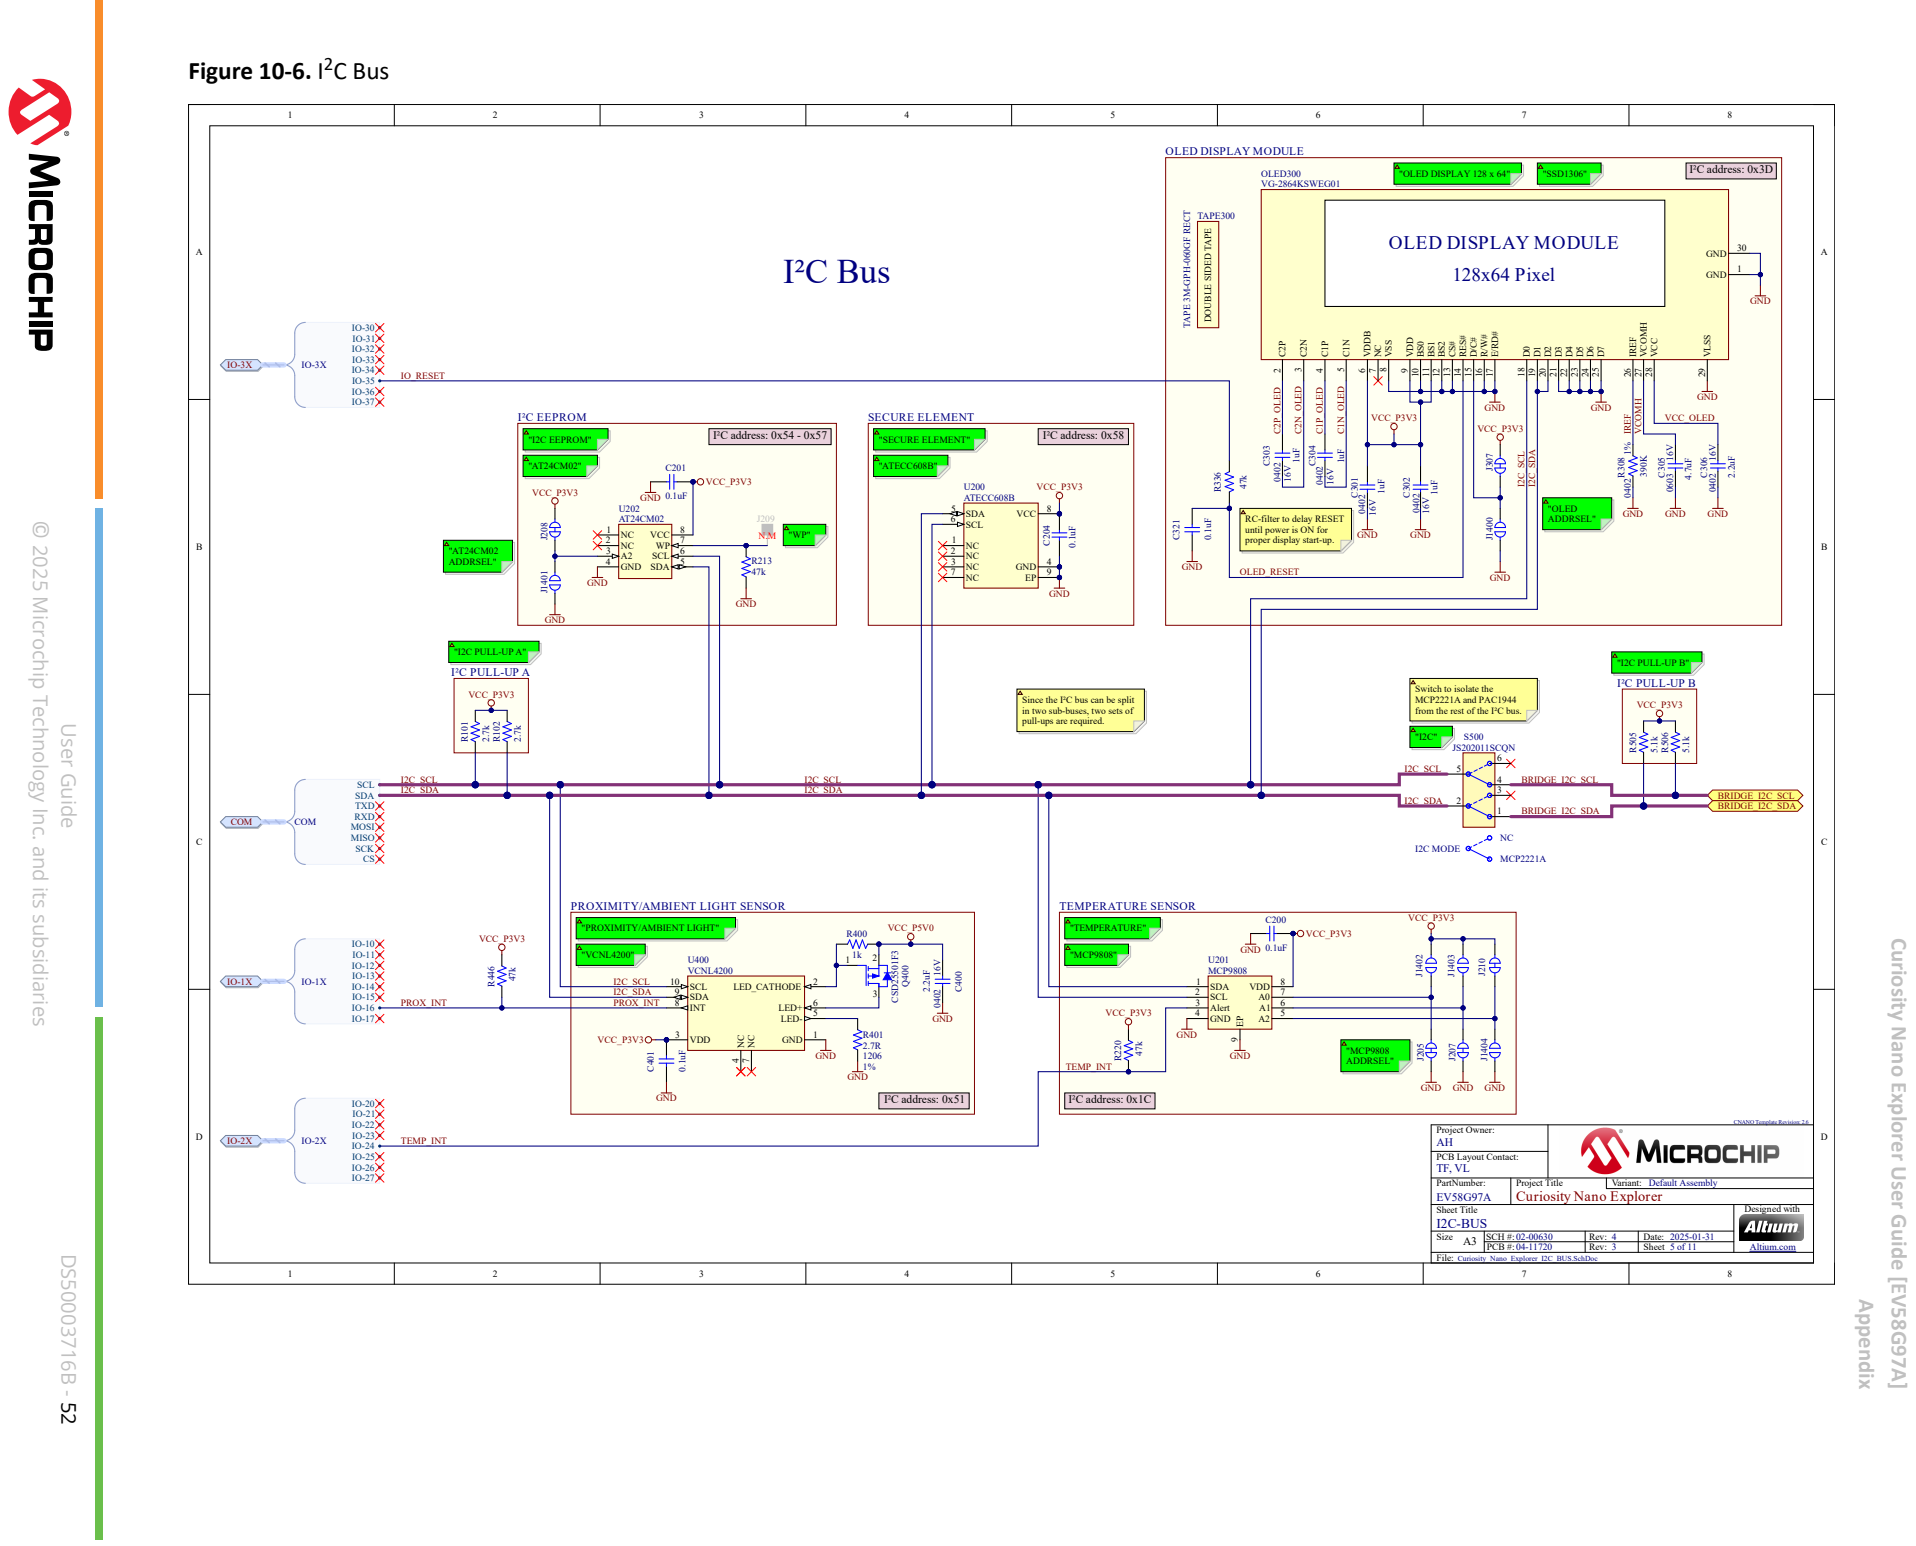
[picture p76: page 52]

until power is ON for
proper display start-up.

© 2025 Microchip Technology Inc. and its subsidiaries

Since the I²C bus can be split
in two sub-buses, two sets of
pull-ups are required.

Switch to isolate the
MCP2221A and PAC1944
from the rest of the I²C bus.

PROXIMITY/AMBIENT LIGHT SENSOR

Curiosity Nano Explorer User Guide [EV58G97A]

Sheet Title I2C-BUS | Designed with Altium.com

Size A3 | SCH #: 02-00630 | Rev: 4 | Date: 2025-01-31

PCB #: 04-11720 | Rev: 3 | Sheet 5 of 11

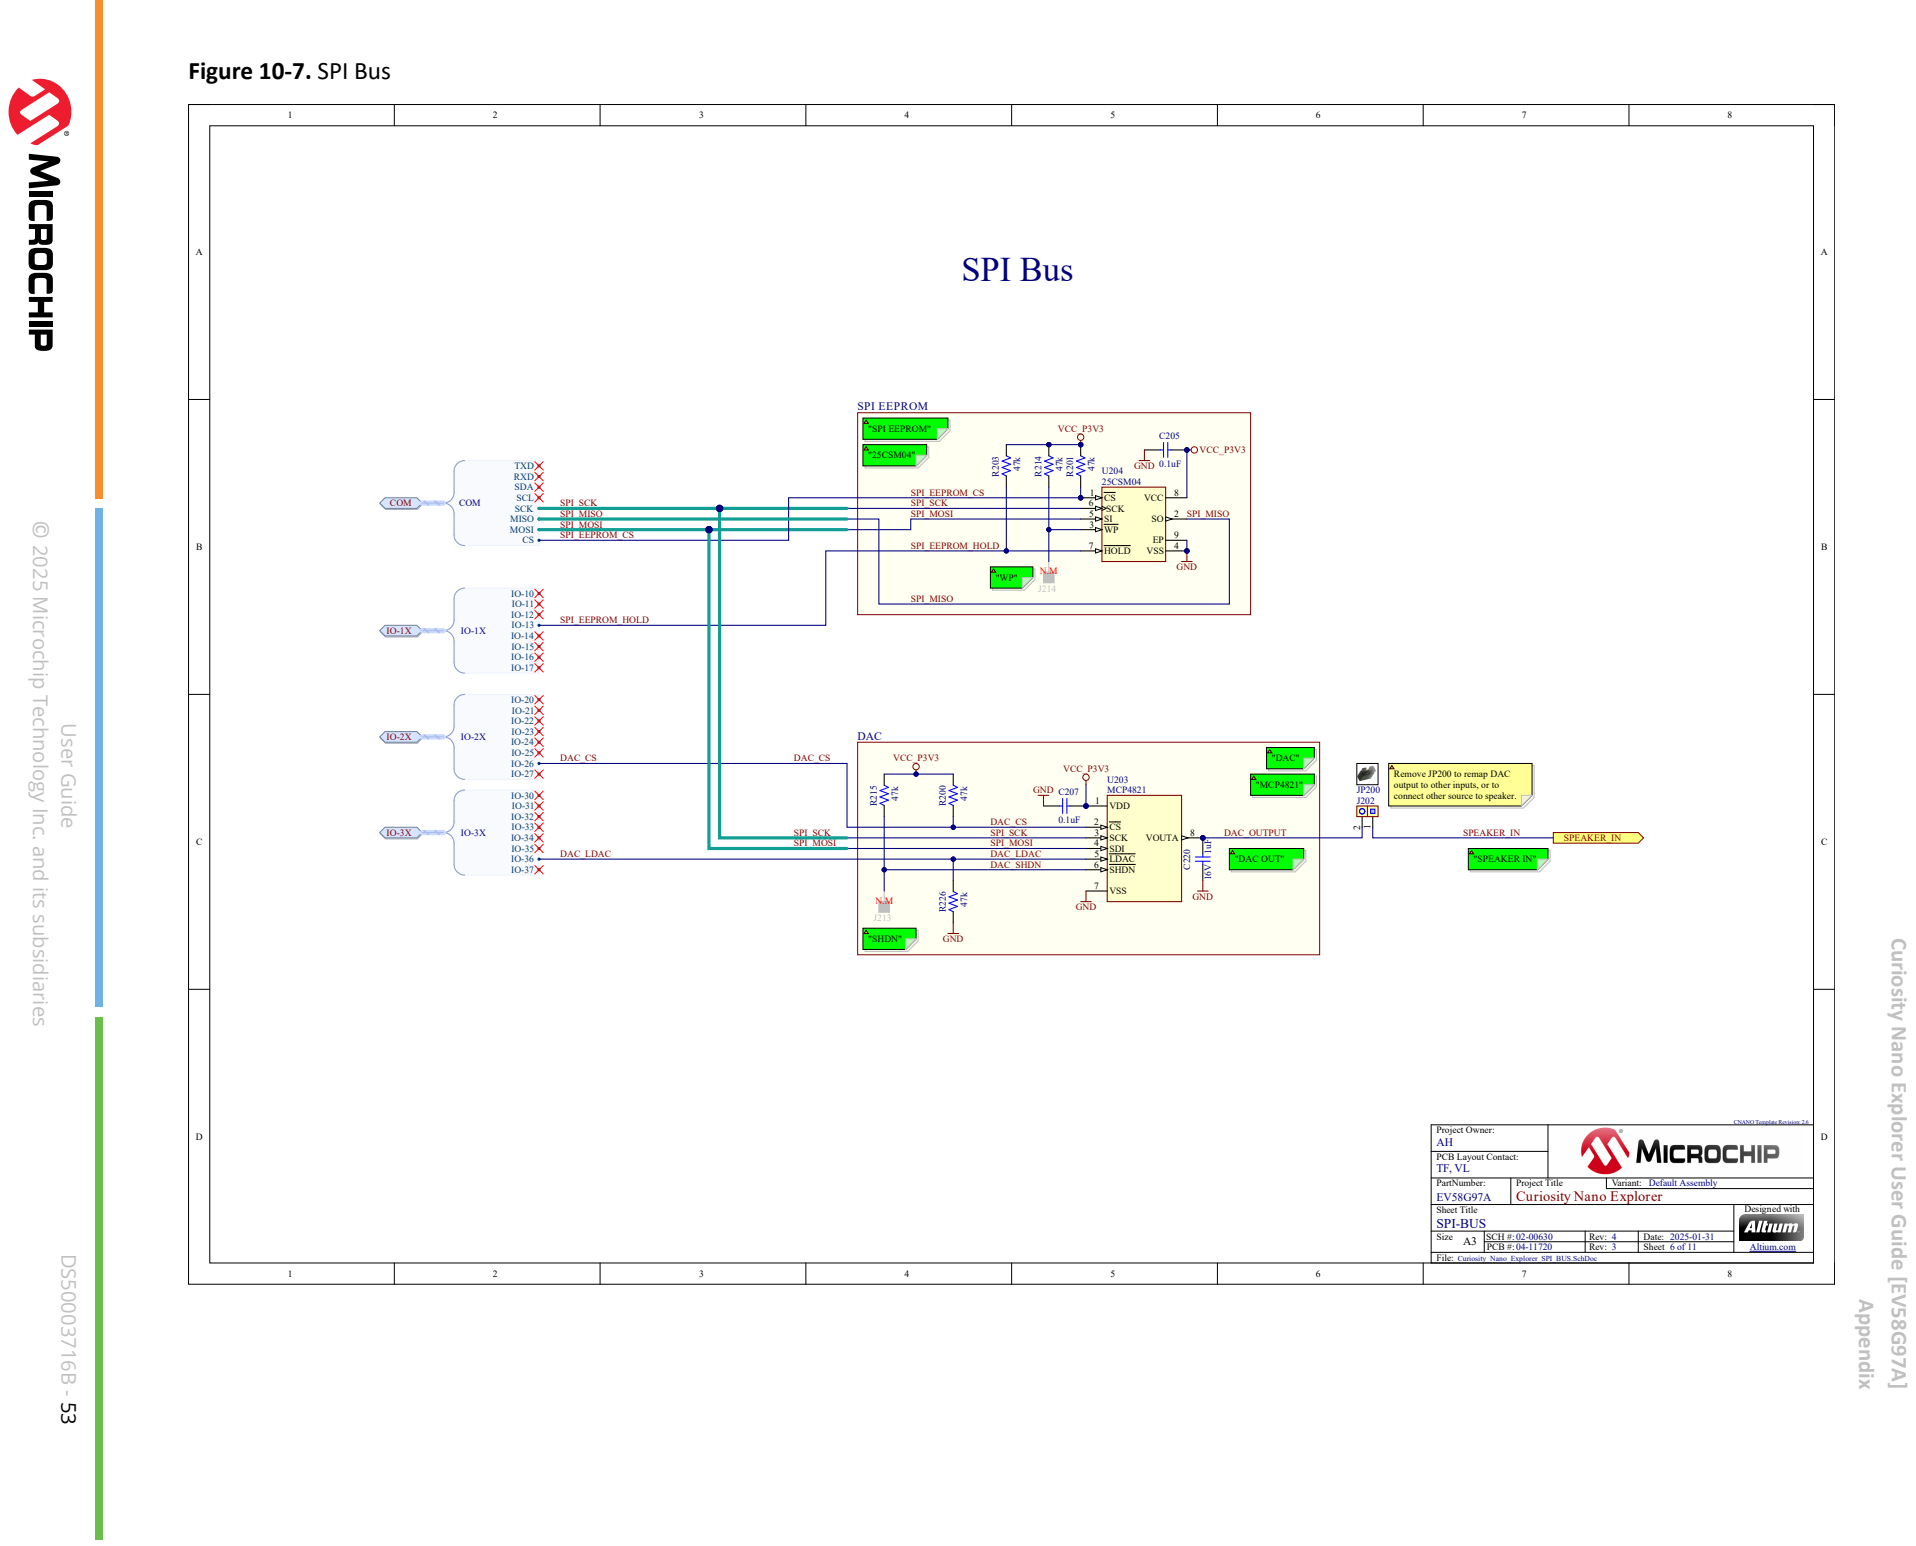
[picture p77: page 53]

© 2025 Microchip Technology Inc. and its subsidiaries

Remove JP200 to remap DAC
output to other inputs, or to
connect other source to speaker.

Curiosity Nano Explorer User Guide [EV58G97A]

Sheet Title SPI-BUS | Designed with Altium.com

Size A3 | SCH #: 02-00630 | Rev: 4 | Date: 2025-01-31

PCB #: 04-11720 | Rev: 3 | Sheet 6 of 11

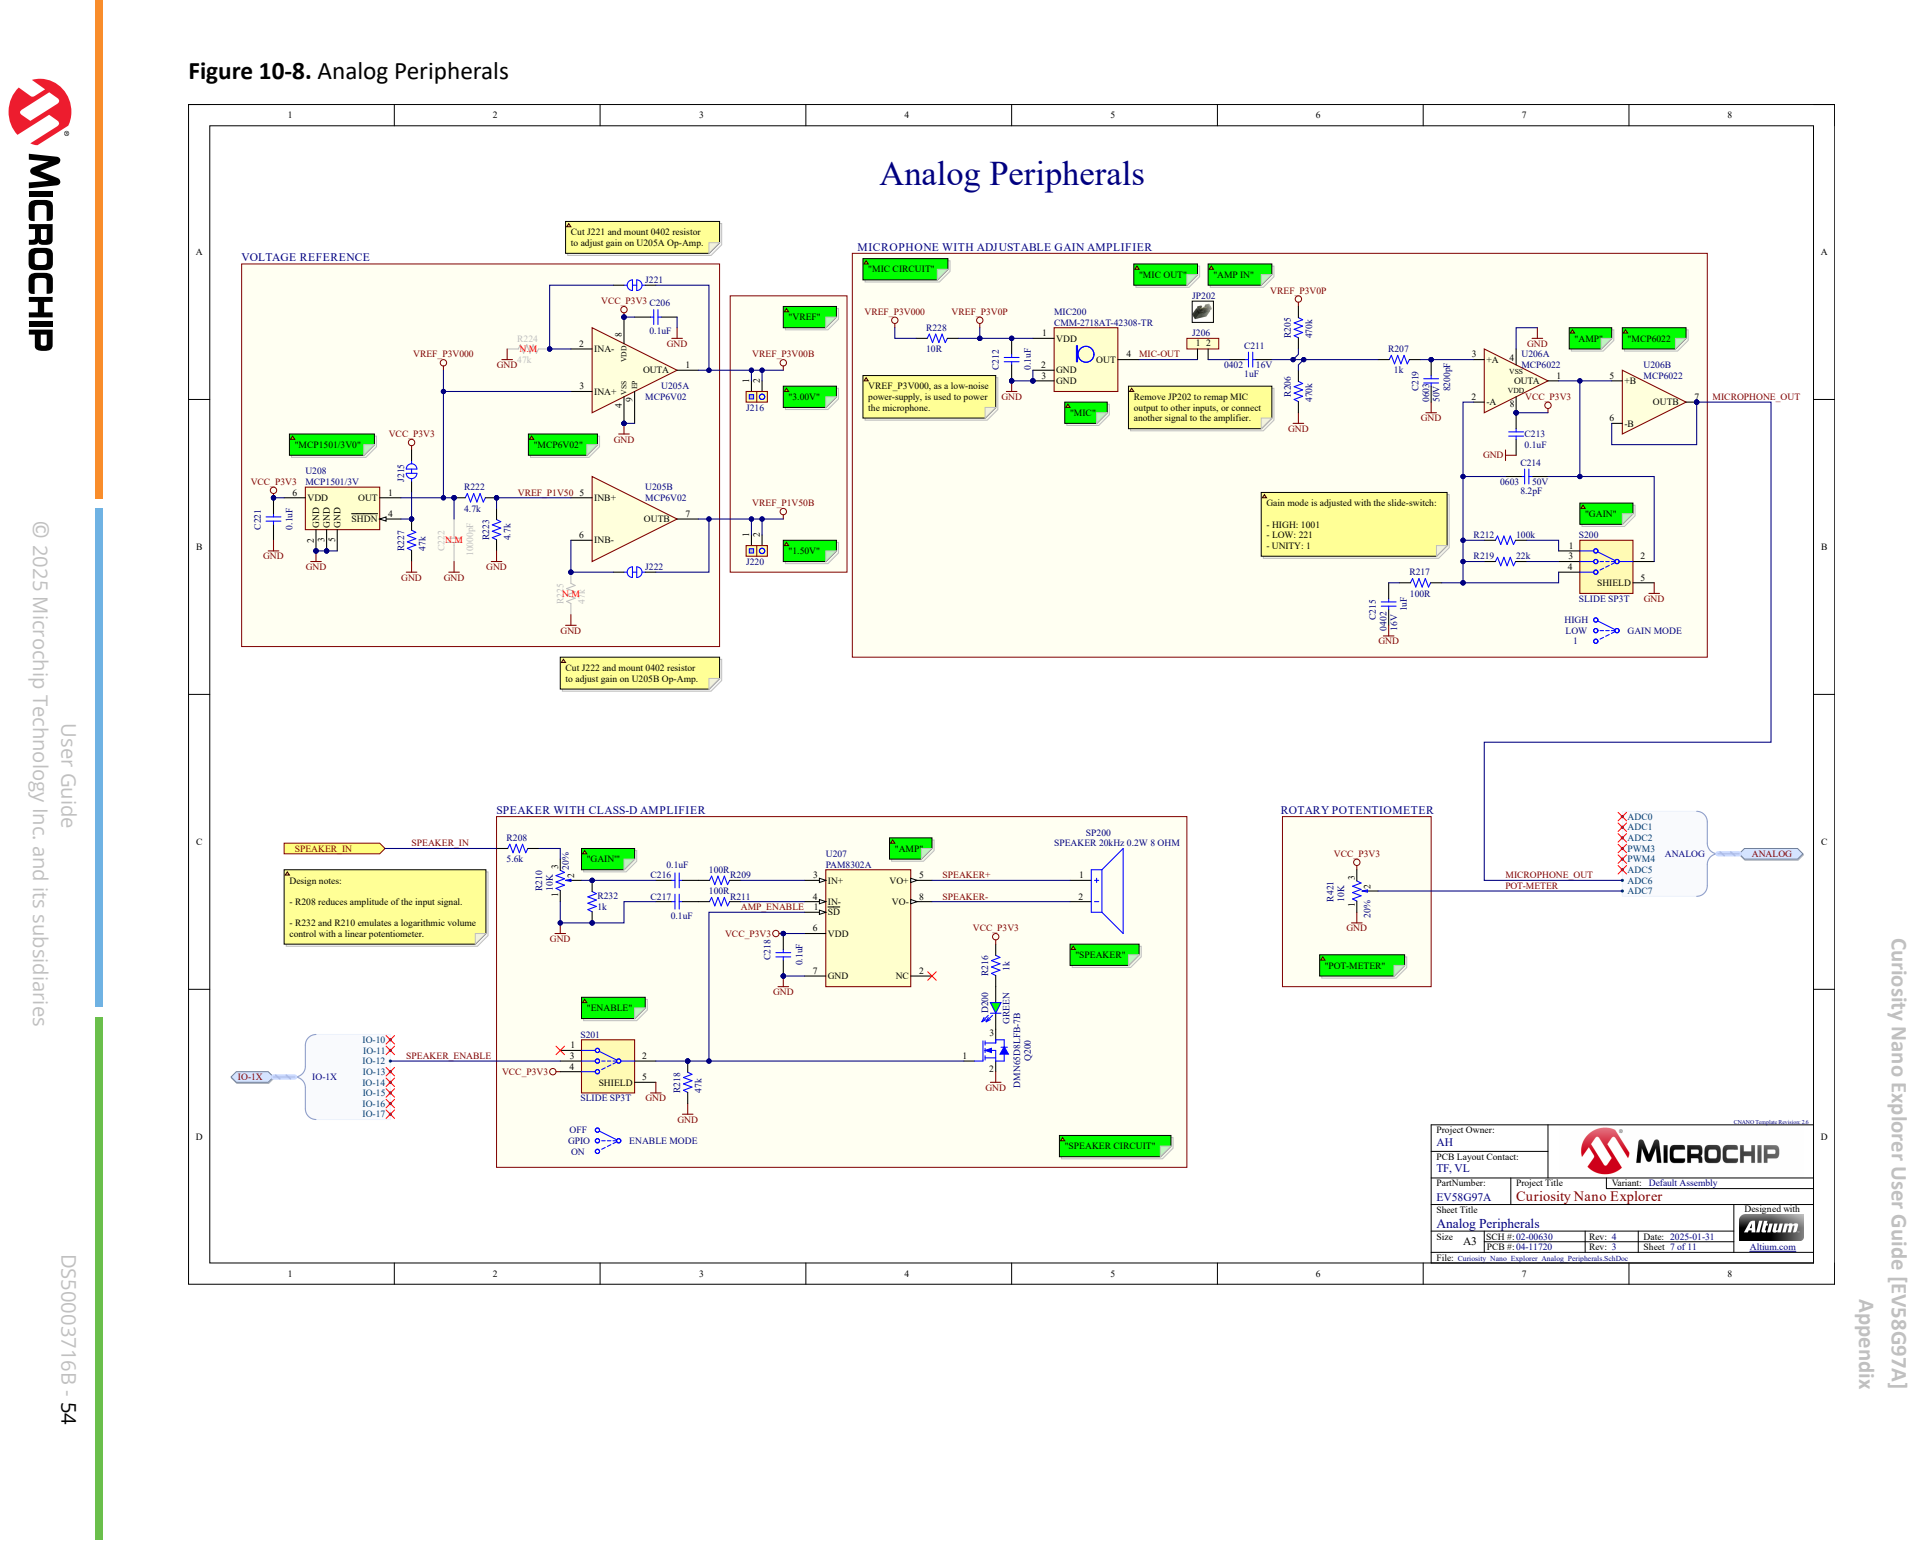
[picture p78: page 54]

Cut J221 and mount 0402 resistor
to adjust gain on U205A Op-Amp.

MICROPHONE WITH ADJUSTABLE GAIN AMPLIFIER

VREF_P3V000, as a low-noise
power-supply, is used to power
the microphone.

Remove JP202 to remap MIC
output to other inputs, or connect
another signal to the amplifier.

Gain mode is adjusted with the slide-switch:

© 2025 Microchip Technology Inc. and its subsidiaries

Cut J222 and mount 0402 resistor
to adjust gain on U205B Op-Amp.

SPEAKER WITH CLASS-D AMPLIFIER

- R208 reduces amplitude of the input signal.

- R232 and R210 emulates a logarithmic volume
control with a linear potentiometer.

Curiosity Nano Explorer User Guide [EV58G97A]

Sheet Title Analog Peripherals | Designed with Altium.com

Size A3 | SCH #: 02-00630 | Rev: 4 | Date: 2025-01-31

PCB #: 04-11720 | Rev: 3 | Sheet 7 of 11

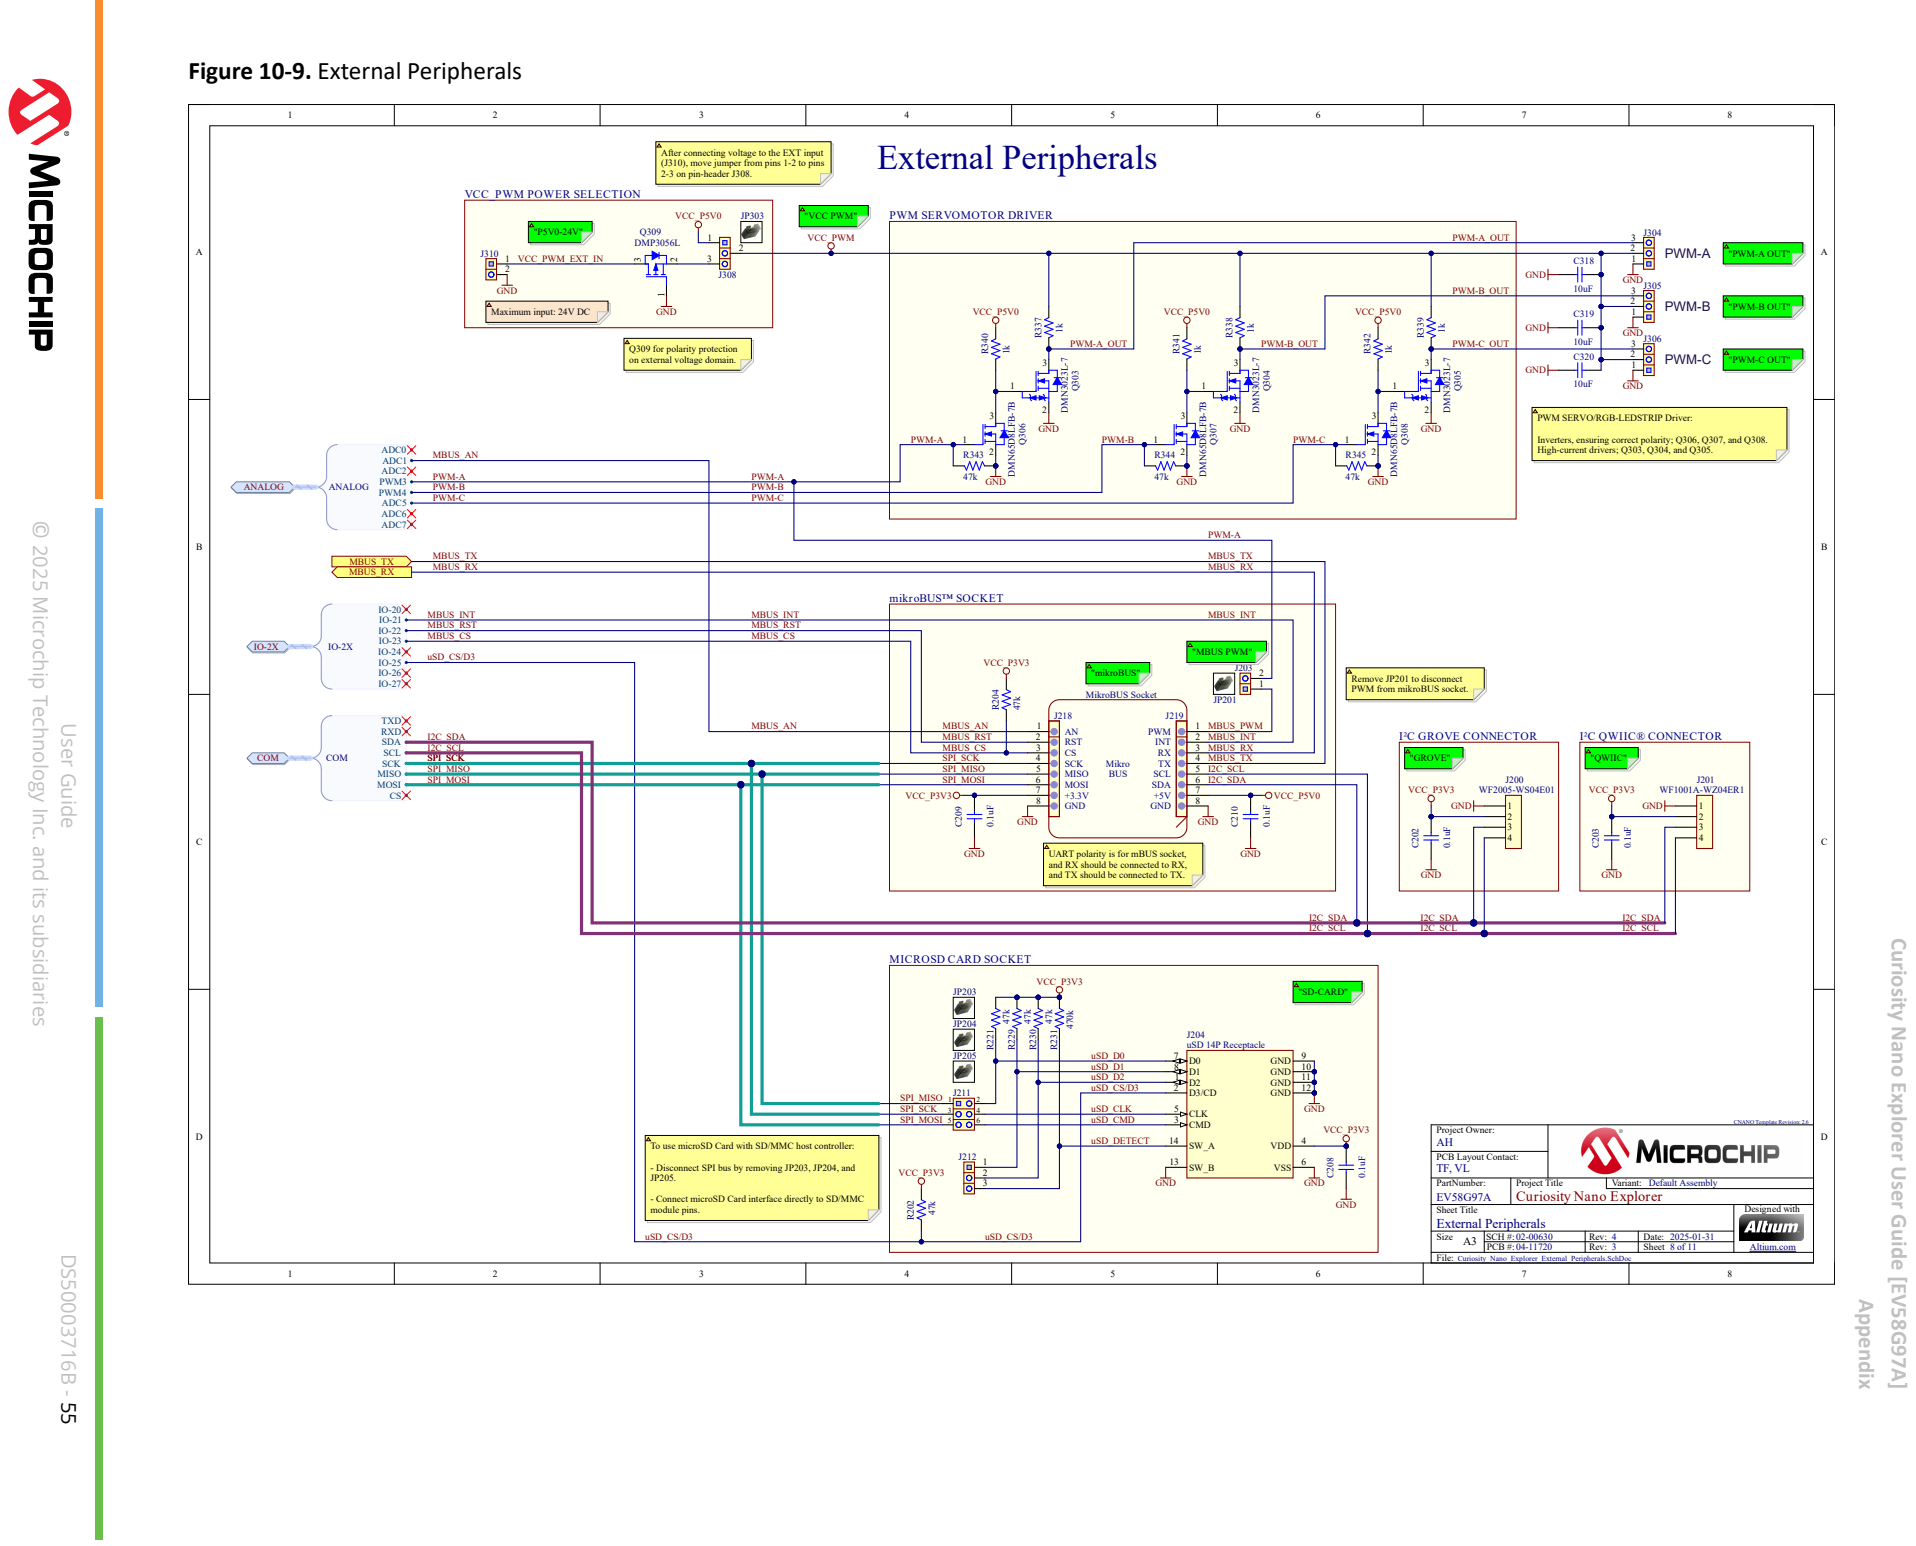
[picture p79: page 55]

After connecting voltage to the EXT input
(J310), move jumper from pins 1-2 to pins
2-3 on pin-header J308.

GND
"PWM-B OUT" Maximum input: 24V DC

Q309 for polarity protection
on external voltage domain.

PWM SERVO/RGB-LEDSTRIP Driver:

Inverters, ensuring correct polarity; Q306, Q307, and Q308.
High-current drivers; Q303, Q304, and Q305.

© 2025 Microchip Technology Inc. and its subsidiaries

Remove JP201 to disconnect
PWM from mikroBUS socket.

UART polarity is for mBUS socket,
and RX should be connected to RX,
and TX should be connected to TX.

Curiosity Nano Explorer User Guide [EV58G97A]

To use microSD Card with SD/MMC host controller:

- Disconnect SPI bus by removing JP203, JP204, and

- Connect microSD Card interface directly to SD/MMC
module pins.

Sheet Title External Peripherals | Designed with Altium.com

Size A3 | SCH #: 02-00630 | Rev: 4 | Date: 2025-01-31

PCB #: 04-11720 | Rev: 3 | Sheet 8 of 11

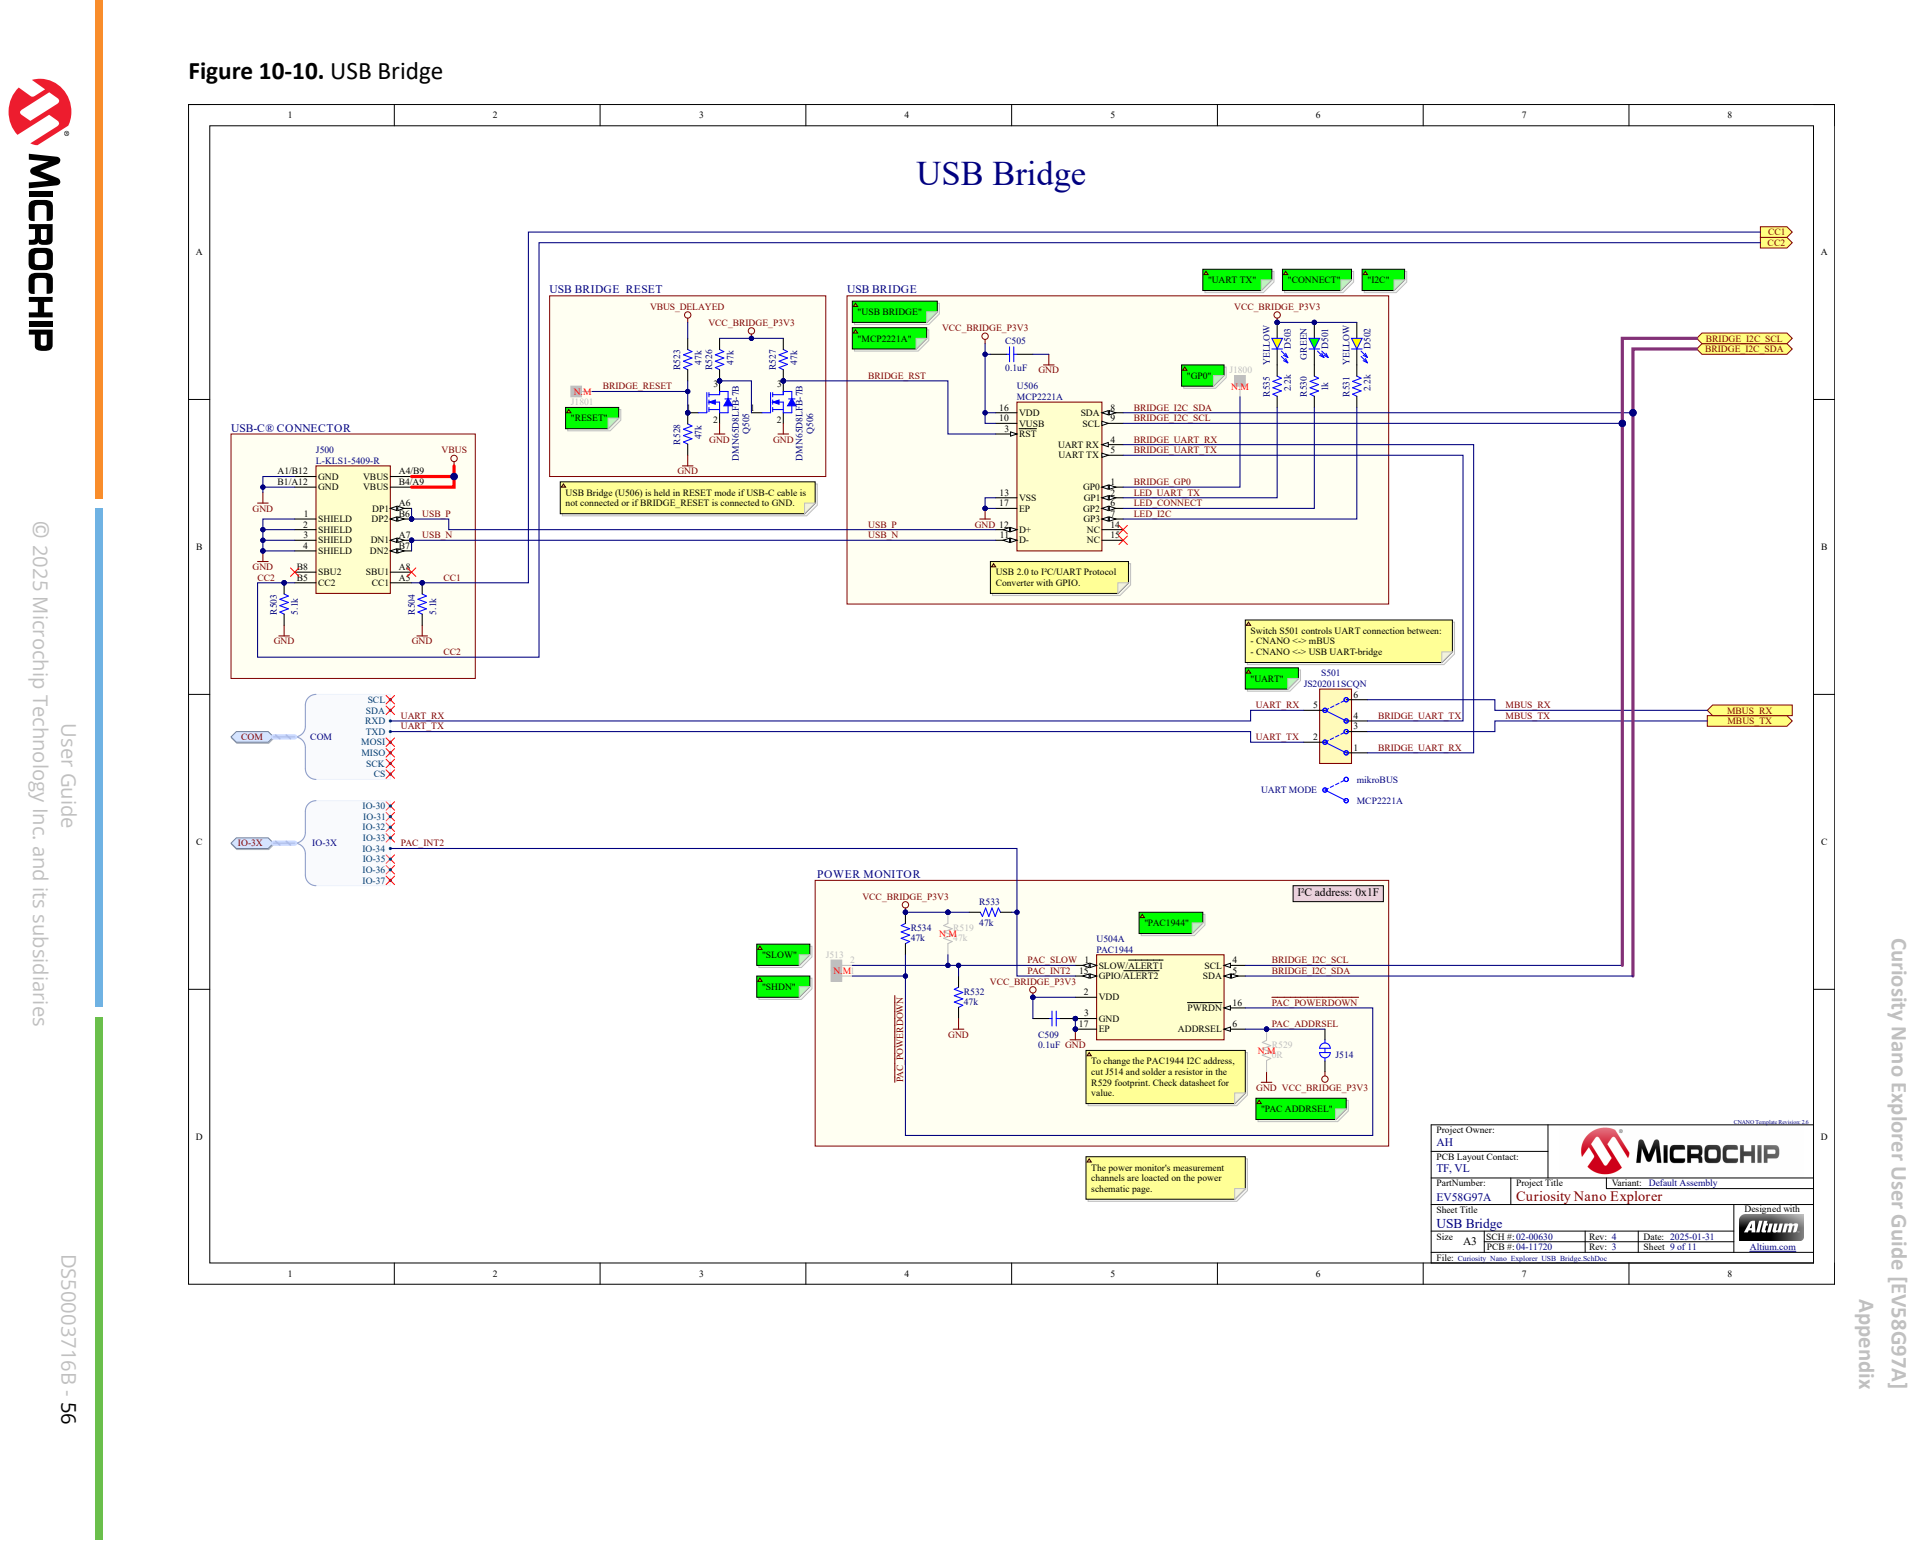
[picture p80: page 56]

USB Bridge (U506) is held in RESET mode if USB-C cable is
not connected or if BRIDGE_RESET is connected to GND.

© 2025 Microchip Technology Inc. and its subsidiaries

USB 2.0 to I²C/UART Protocol
Converter with GPIO.

Switch S501 controls UART connection between:
- CNANO <-> mBUS
- CNANO <-> USB UART-bridge

Curiosity Nano Explorer User Guide [EV58G97A]

GND
To change the PAC1944 I2C address,
cut J514 and solder a resistor in the
R529 footprint. Check datasheet for
value.

The power monitor's measurement
channels are loacted on the power
schematic page.

Sheet Title USB Bridge | Designed with Altium.com

Size A3 | SCH #: 02-00630 | Rev: 4 | Date: 2025-01-31

PCB #: 04-11720 | Rev: 3 | Sheet 9 of 11

# USB BRIDGE 3.3V SUPPLY2.2uF 16VC⁵⁰¹

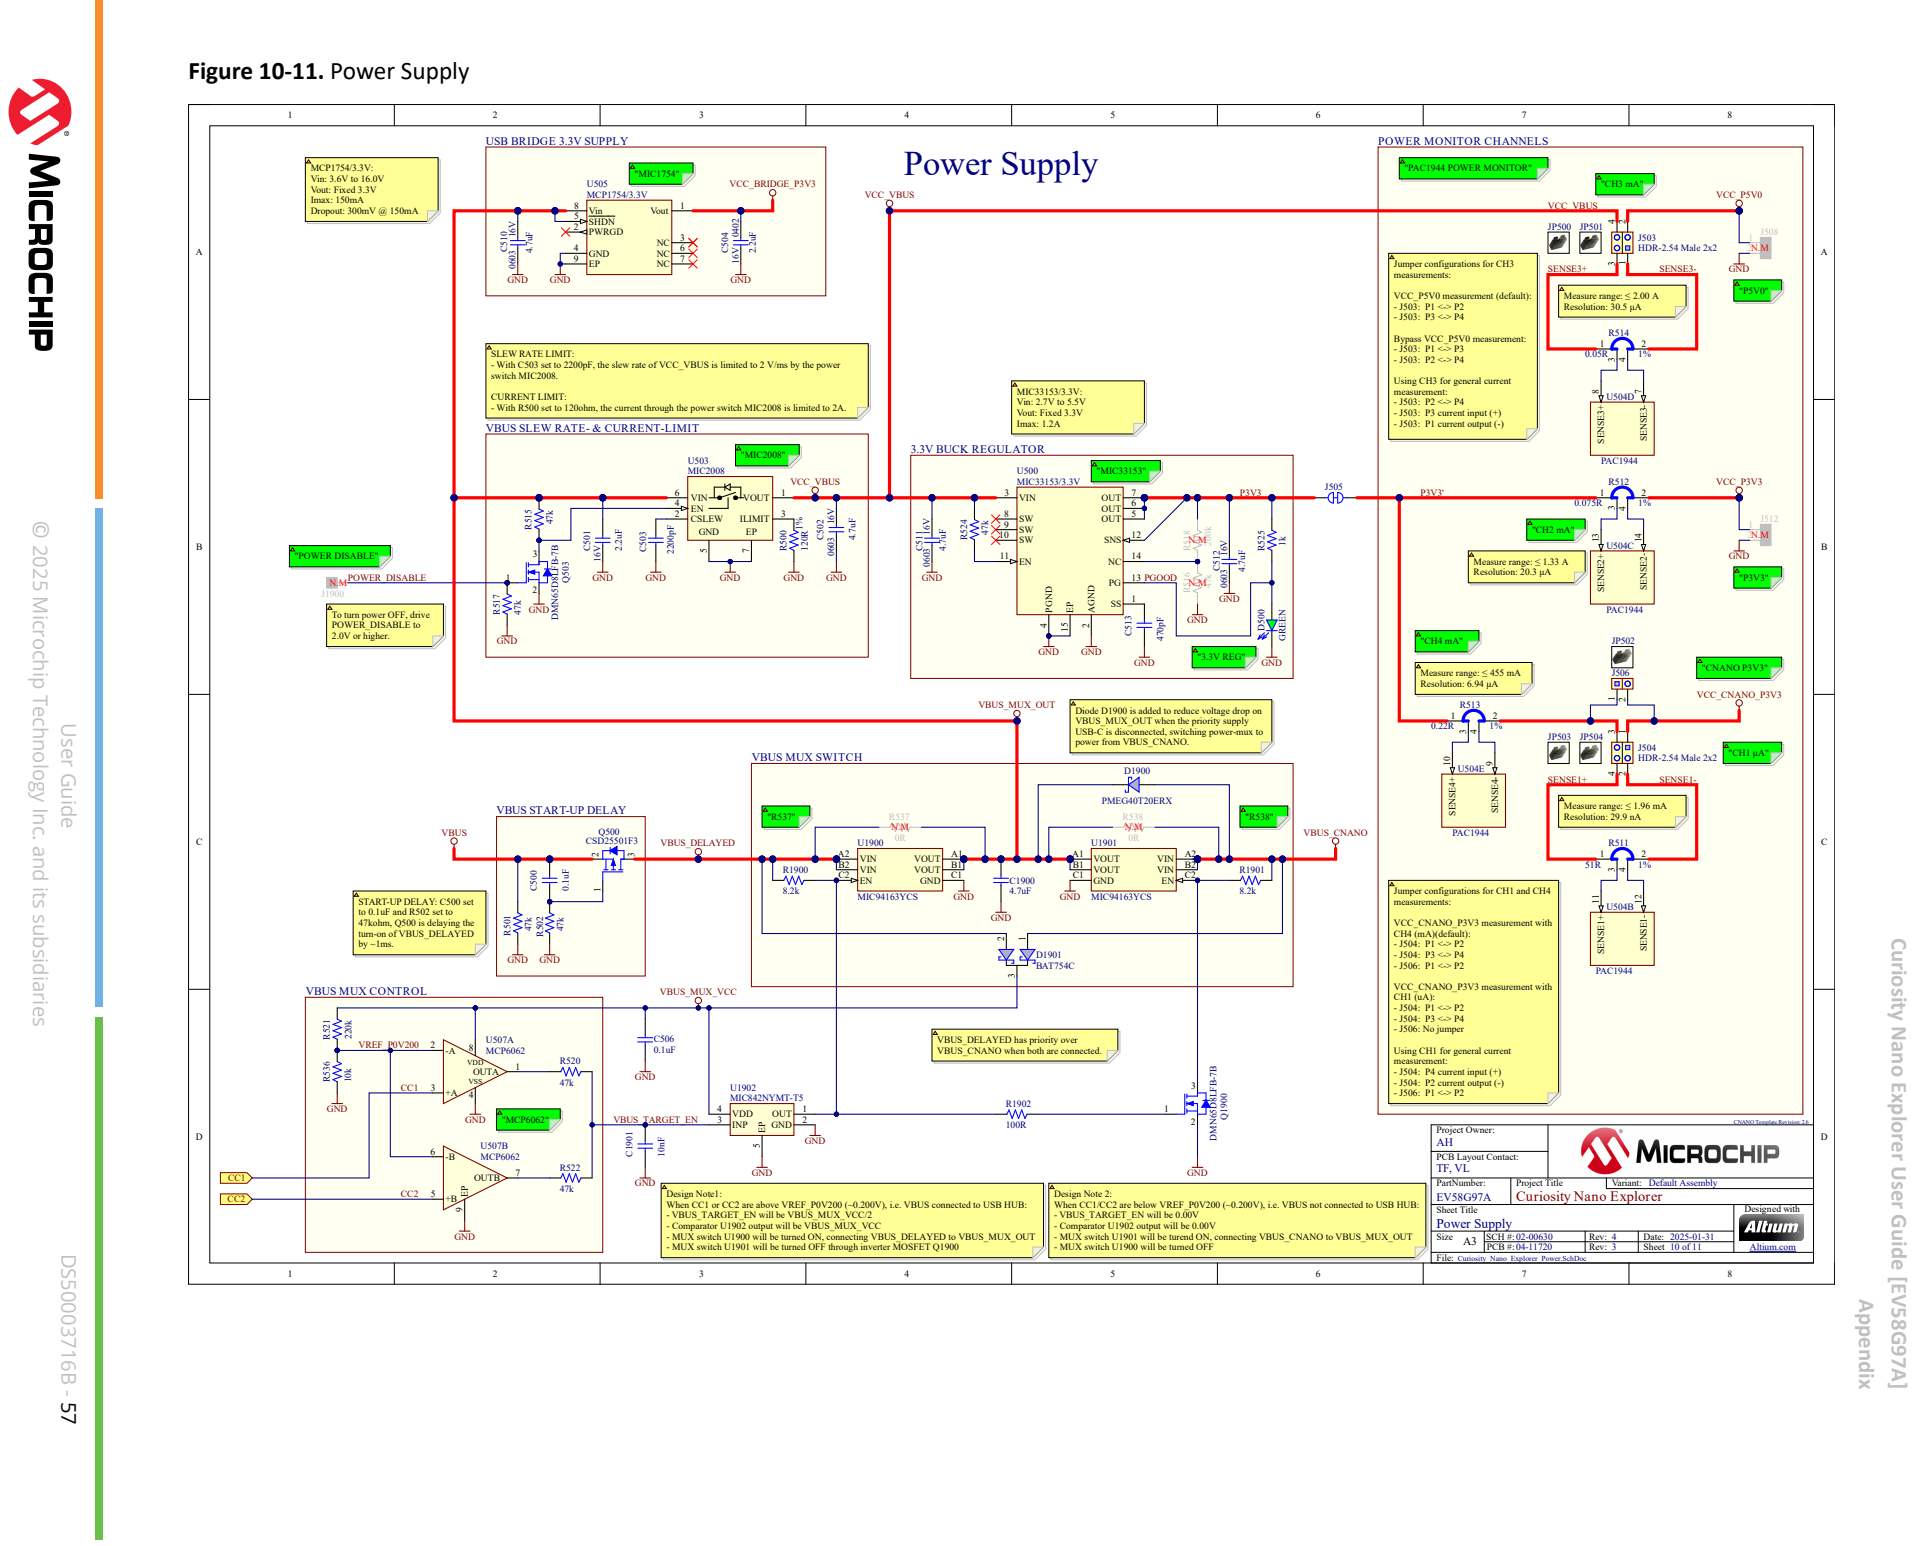
[picture p81: page 57]

SLEW RATE LIMIT:
- With C503 set to 2200pF, the slew rate of VCC_VBUS is limited to 2 V/ms by the power
switch MIC2008.

CURRENT LIMIT:
- With R500 set to 120ohm, the current through the power switch MIC2008 is limited to 2A.
VBUS SLEW RATE- & CURRENT-LIMIT

© 2025 Microchip Technology Inc. and its subsidiaries

To turn power OFF, drive
POWER_DISABLE to
2.0V or higher.

Diode D1900 is added to reduce voltage drop on
VBUS_MUX_OUT when the priority supply
USB-C is disconnected, switching power-mux to
power from VBUS_CNANO.

VBUS START-UP DELAY

START-UP DELAY: C500 set
to 0.1uF and R502 set to
47kohm, Q500 is delaying the
turn-on of VBUS_DELAYED

Jumper configurations for CH1 and CH4
measurements:

Curiosity Nano Explorer User Guide [EV58G97A]

VBUS_DELAYED has priority over
VBUS_CNANO when both are connected.

Design Note1:
When CC1 or CC2 are above VREF_P0V200 (~0.200V), i.e. VBUS connected to USB HUB:
- VBUS_TARGET_EN will be VBUS_MUX_VCC/2
- Comparator U1902 output will be VBUS_MUX_VCC
- MUX switch U1900 will be turned ON, connecting VBUS_DELAYED to VBUS_MUX_OUT
- MUX switch U1901 will be turned OFF through inverter MOSFET Q1900

Design Note 2:
When CC1/CC2 are below VREF_P0V200 (~0.200V), i.e. VBUS not connected to USB HUB:
- VBUS_TARGET_EN will be 0.00V
- Comparator U1902 output will be 0.00V
- MUX switch U1901 will be turend ON, connecting VBUS_CNANO to VBUS_MUX_OUT
- MUX switch U1900 will be turned OFF

Sheet Title Power Supply | Designed with Altium.com

Size A3 | SCH #: 02-00630 | Rev: 4 | Date: 2025-01-31

PCB #: 04-11720 | Rev: 3 | Sheet 10 of 11

## 10.4. Assembly Drawings

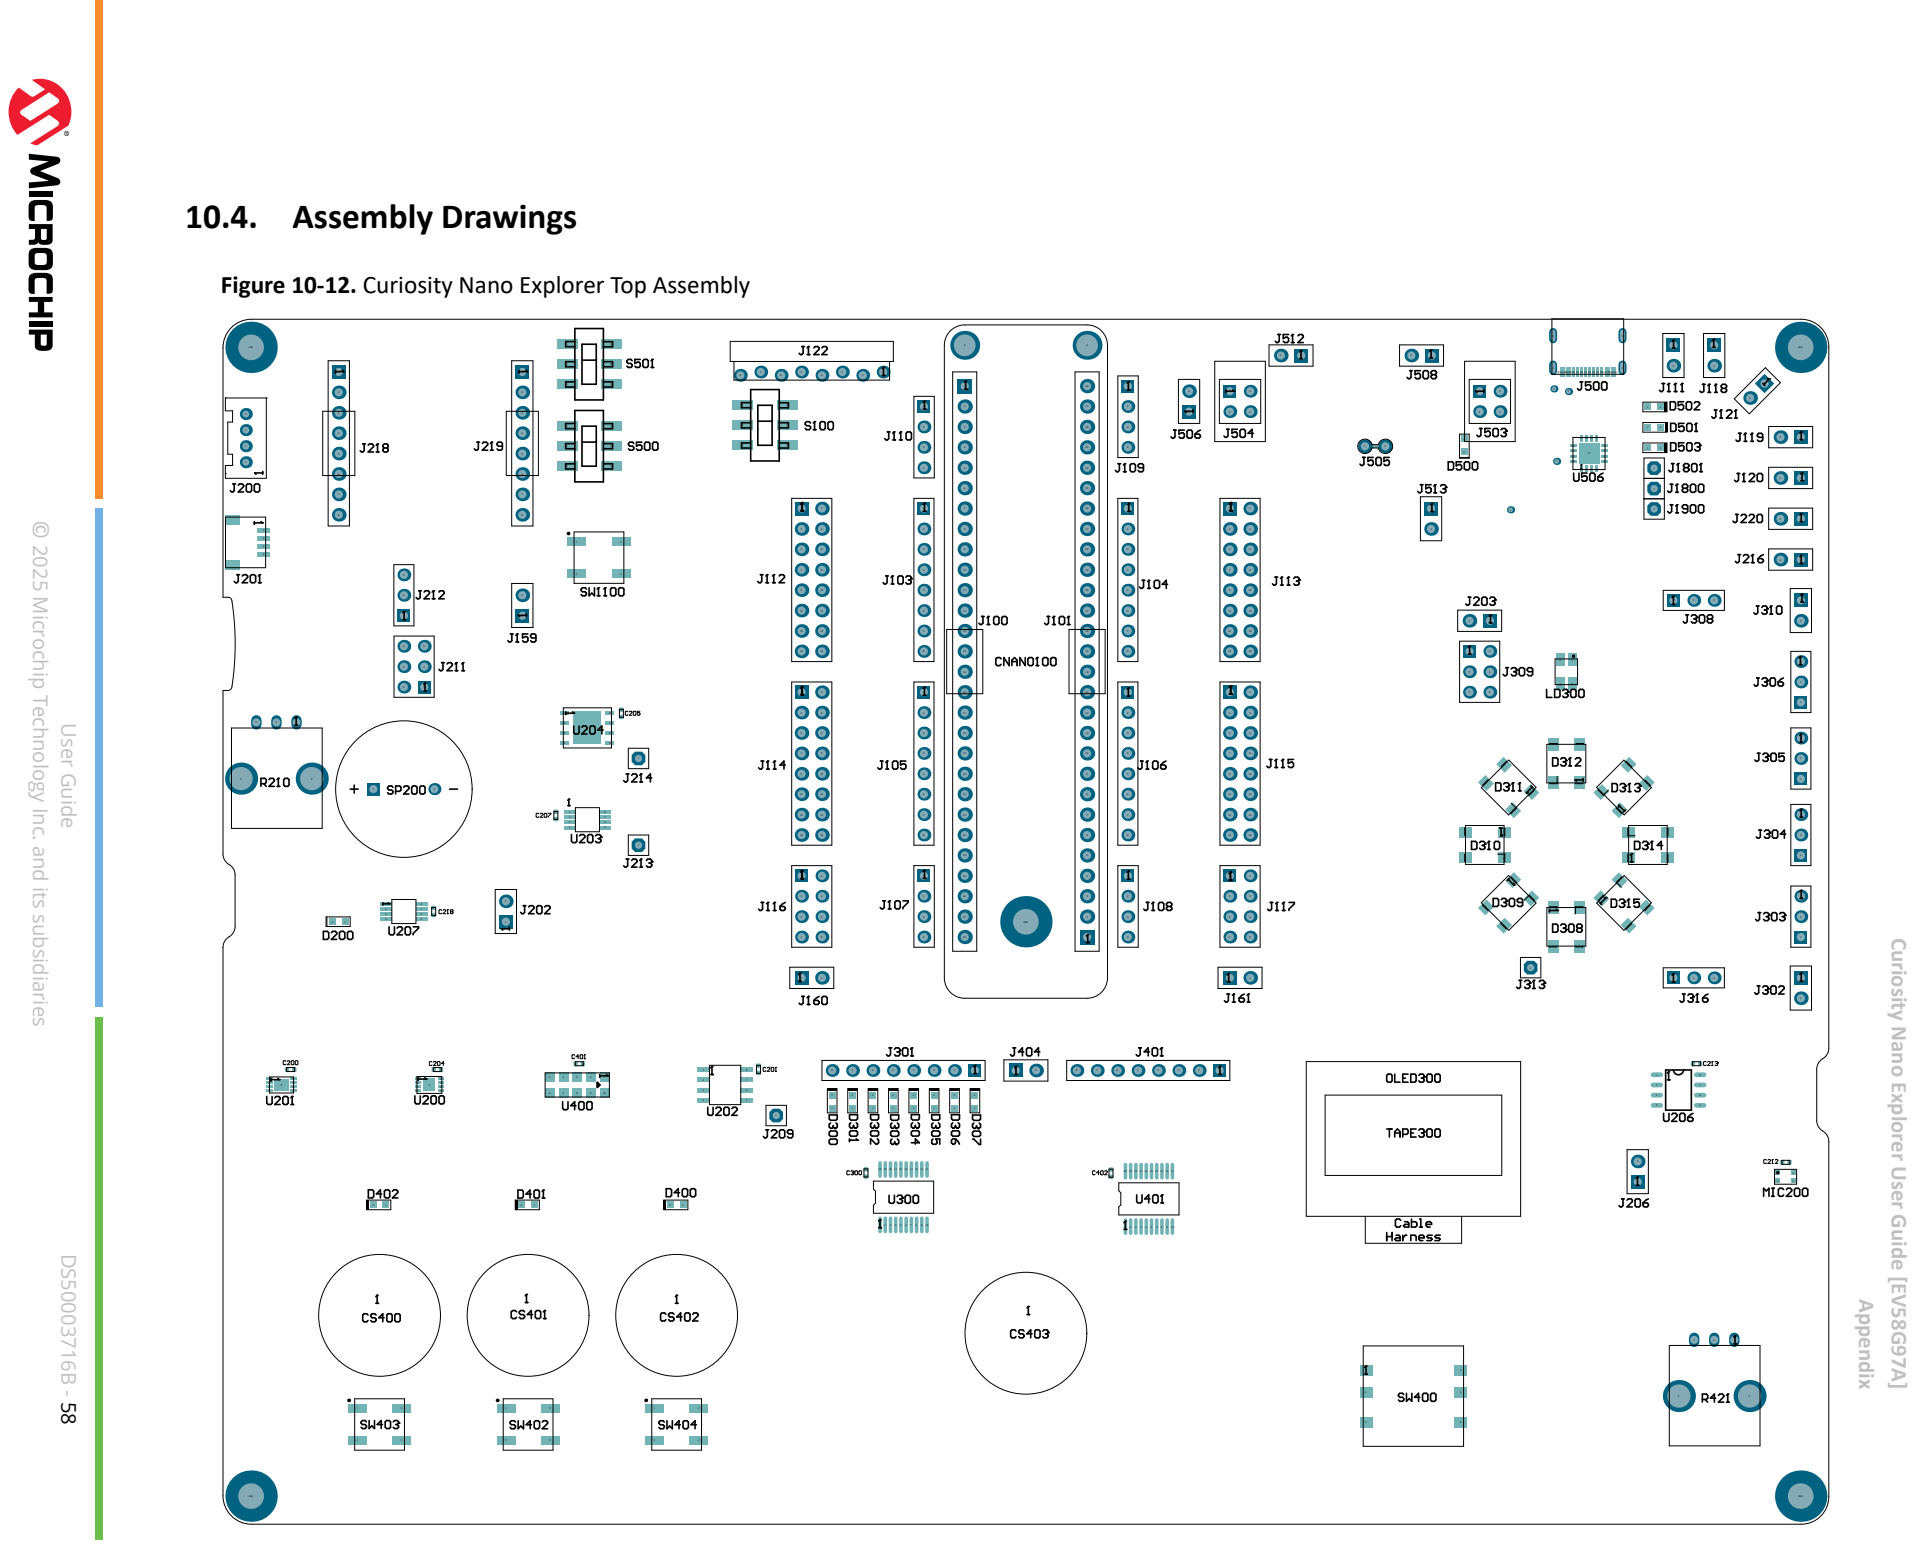
[picture p82: page 58]
Appendix; User Guide

rotatethispage90
Figure 10-12. Curiosity Nano Explorer Top Assemblyrotatethispage90

© 2025 Microchip Technology Inc. and its subsidiaries

Curiosity Nano Explorer User Guide [EV58G97A]

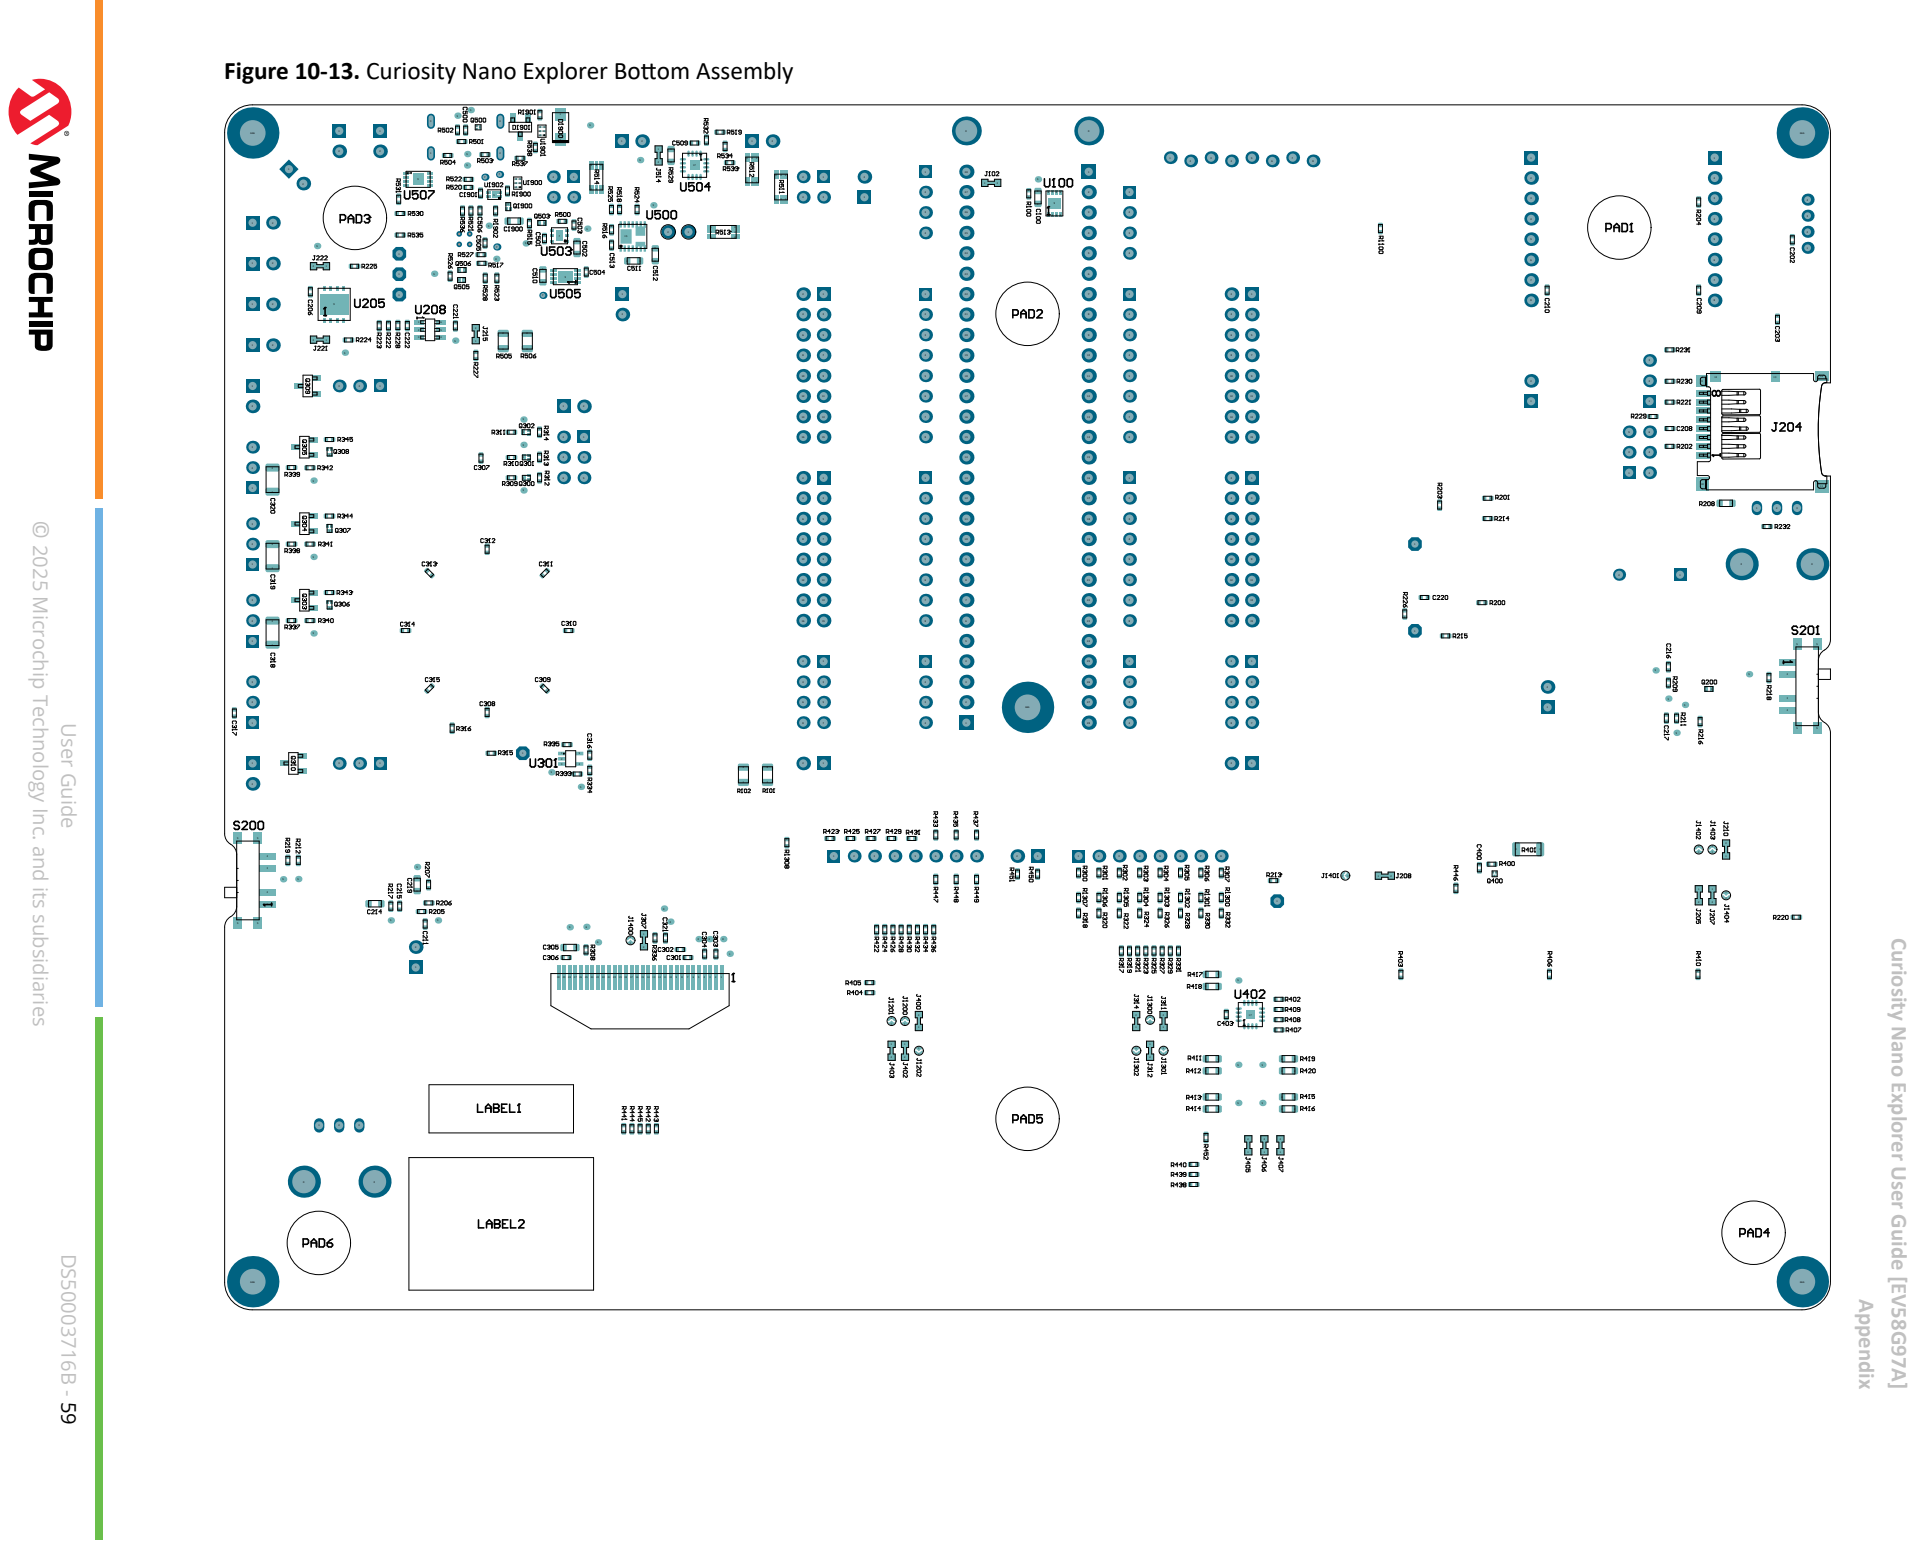
[picture p83: page 59]
Appendix; User Guide

Figure 10-13. Curiosity Nano Explorer Bottom Assemblyrotatethispage90

© 2025 Microchip Technology Inc. and its subsidiaries

Curiosity Nano Explorer User Guide [EV58G97A]

## Microchip Information

## Trademarks

The “Microchip” name and logo, the “M” logo, and other names, logos, and brands are registered and unregistered trademarks of Microchip Technology Incorporated or its affiliates and/or subsidiaries in the United States and/or other countries (“Microchip Trademarks”). Information regarding Microchip Trademarks can be found at https://www.microchip.com/en-us/about/legal-information/microchip-trademarks. (https://www.microchip.com/en-us/about/legal-information/microchip-trademarks)
ISBN: 979-8-3371-1733-1

## Legal Notice

This publication and the information herein may be used only with Microchip products, including to design, test, and integrate Microchip products with your application. Use of this information in any other manner violates these terms. Information regarding device applications is provided only for your convenience and may be superseded by updates. It is your responsibility to ensure that your application meets with your specifications. Contact your local Microchip sales office for additional support or, obtain additional support at www.microchip.com/en-us/support/design-help/ client-support-services. (https://www.microchip.com/en-us/support/design-help/client-support-services)
THIS INFORMATION IS PROVIDED BY MICROCHIP “AS IS”. MICROCHIP MAKES NO REPRESENTATIONS OR WARRANTIES OF ANY KIND WHETHER EXPRESS OR IMPLIED, WRITTEN OR ORAL, STATUTORY OR OTHERWISE, RELATED TO THE INFORMATION INCLUDING BUT NOT LIMITED TO ANY IMPLIED WARRANTIES OF NON-INFRINGEMENT, MERCHANTABILITY, AND FITNESS FOR A PARTICULAR PURPOSE, OR WARRANTIES RELATED TO ITS CONDITION, QUALITY, OR PERFORMANCE.
IN NO EVENT WILL MICROCHIP BE LIABLE FOR ANY INDIRECT, SPECIAL, PUNITIVE, INCIDENTAL, OR CONSEQUENTIAL LOSS, DAMAGE, COST, OR EXPENSE OF ANY KIND WHATSOEVER RELATED TO THE INFORMATION OR ITS USE, HOWEVER CAUSED, EVEN IF MICROCHIP HAS BEEN ADVISED OF THE POSSIBILITY OR THE DAMAGES ARE FORESEEABLE. TO THE FULLEST EXTENT ALLOWED BY LAW, MICROCHIP’S TOTAL LIABILITY ON ALL CLAIMS IN ANY WAY RELATED TO THE INFORMATION OR ITS USE WILL NOT EXCEED THE AMOUNT OF FEES, IF ANY, THAT YOU HAVE PAID DIRECTLY TO MICROCHIP FOR THE INFORMATION.
Use of Microchip devices in life support and/or safety applications is entirely at the buyer’s risk,
and the buyer agrees to defend, indemnify and hold harmless Microchip from any and all damages, claims, suits, or expenses resulting from such use. No licenses are conveyed, implicitly or otherwise, under any Microchip intellectual property rights unless otherwise stated.

## Microchip Devices Code Protection Feature

Note the following details of the code protection feature on Microchip products:
- Microchip products meet the specifications contained in their particular Microchip Data Sheet.
- Microchip believes that its family of products is secure when used in the intended manner, within operating specifications, and under normal conditions.
- Microchip values and aggressively protects its intellectual property rights. Attempts to breach the code protection features of Microchip products are strictly prohibited and may violate the Digital Millennium Copyright Act.
- Neither Microchip nor any other semiconductor manufacturer can guarantee the security of its code. Code protection does not mean that we are guaranteeing the product is “unbreakable”. Code protection is constantly evolving. Microchip is committed to continuously improving the code protection features of our products.

## Product Page Links

25CSM04, (https://www.microchip.com/en-us/product/25CSM04) AT24CM02, (https://www.microchip.com/en-us/product/AT24CM02) ATECC608B, (https://www.microchip.com/en-us/product/ATECC608B) ATSHA204A, (https://www.microchip.com/en-us/product/ATSHA204A) MCP1501, (https://www.microchip.com/en-us/product/MCP1501) MCP2221A, (https://www.microchip.com/en-us/product/MCP2221A) MCP23008, (https://www.microchip.com/en-us/product/MCP23008) MCP4821, (https://www.microchip.com/en-us/product/MCP4821) MCP6022, (https://www.microchip.com/en-us/product/MCP6022) MCP9808, (https://www.microchip.com/en-us/product/MCP9808) MTCH1030, (https://www.microchip.com/en-us/product/MTCH1030) PAC1944 (https://www.microchip.com/en-us/product/PAC1944)
