808017/ATmega4809-CNANO-Documents/(list of files, drawings)

Other design files:
ATmega4809-Curiosity-Nano-Altium-Project/ATmega4809_Curiosity_Nano.PcbDoc
ATmega4809-Curiosity-Nano-Altium-Project/ATmega4809_Curiosity_Nano.PrjPcb
ATmega4809-Curiosity-Nano-Altium-Project/ATmega4809_Curiosity_Nano_Debugger.SchDoc
ATmega4809-Curiosity-Nano-Altium-Project/ATmega4809_Curiosity_Nano_Revision_History.SchDoc
ATmega4809-Curiosity-Nano-Altium-Project/ATmega4809_Curiosity_Nano_Target_MCU.SchDoc
ATmega4809-Curiosity-Nano-Altium-Project/ATmega4809_Curiosity_Nano_TopLevel.SchDoc
