808017/ATmega4809-CNANO-Documents/(commit log)

2026-09-06 init commit
    [ATmega4809_Curiosity_Nano.PcbDoc, ATmega4809_Curiosity_Nano.PrjPcb, ATmega4809_Curiosity_Nano_Debugger.SchDoc, ATmega4809_Curiosity_Nano_Revision_History.SchDoc, ATmega4809_Curiosity_Nano_Target_MCU.SchDoc, ATmega4809_Curiosity_Nano_TopLevel.SchDoc, BOM_Template.xlsx]
2026-09-06 Add README with resources for ATmega4809 Curiosity Nano
    This README provides comprehensive resources for the ATmega4809 Curiosity Nano Development Board, including datasheets, pinout information, schematics, and user guides.
